Sembazuru/Interactive-Rainbow/Schematic/ExtraLEDs/ExtraLEDs_Bottom.png

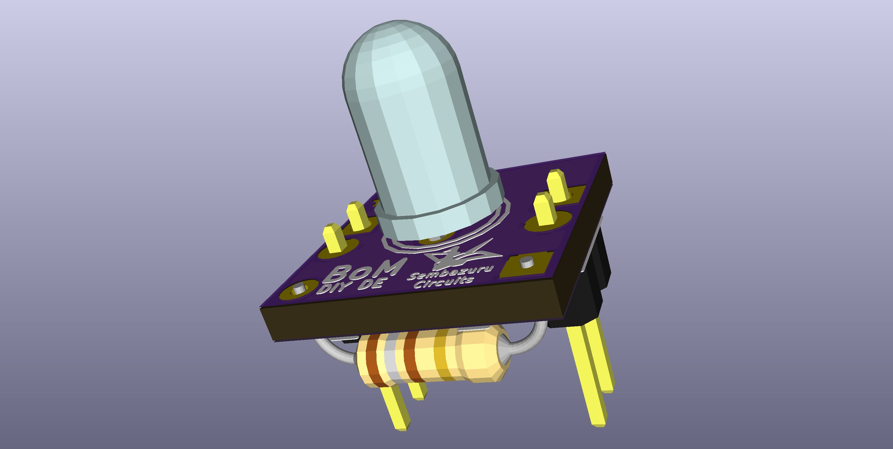
Schematic/ExtraLEDs/ExtraLEDs_Bottom.png
