Sembazuru/Interactive-Rainbow/Schematic/ExtraLEDs/ExtraLEDs_BareTop.png

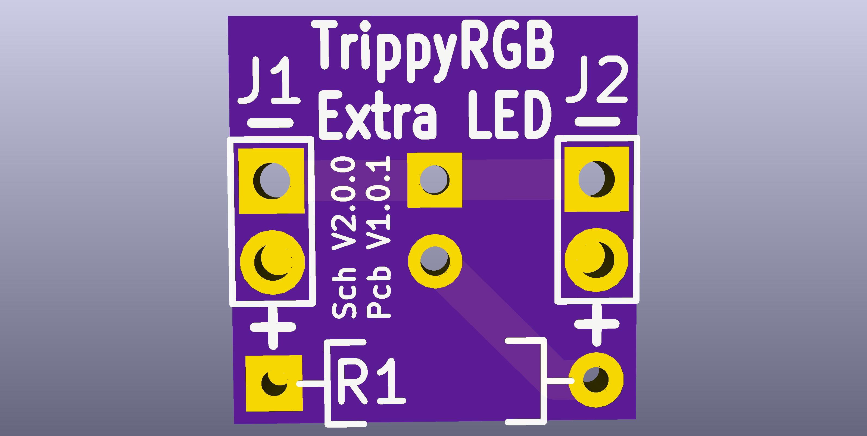
Schematic/ExtraLEDs/ExtraLEDs_BareTop.png
