Sembazuru/Interactive-Rainbow/Circuit Board Design Relative Sizes.pdf

LED | LED

LED LED

LED LED

LED LED

LED LED

LED LED

LED LED

LED LED

Sensor & LED | Sensor & LED

I&O Expander

Logic & Oscillator

Sensor & LED | Sensor & LED
Sensor & LED | Sensor & LED

I&O Expander
