Sembazuru/Interactive-Rainbow/Long Sign design idea 2017-02-08 CDE.png

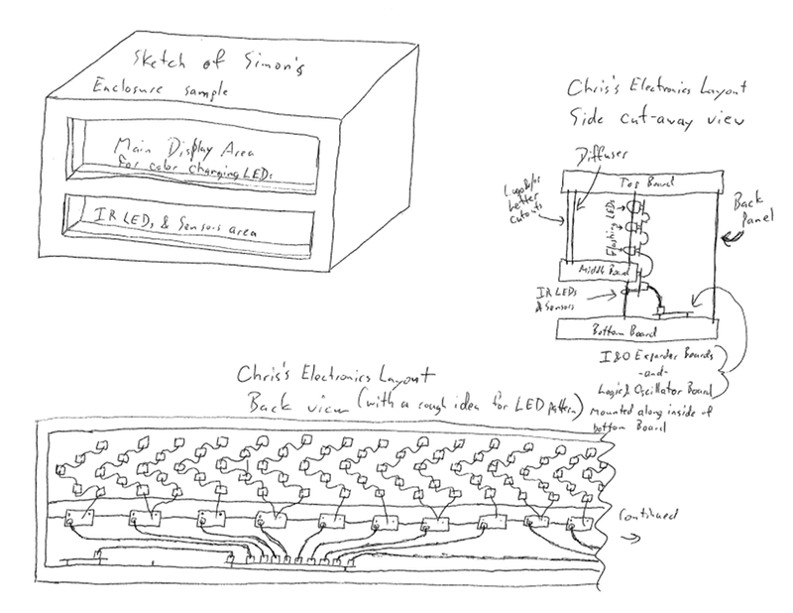
Long Sign design idea 2017-02-08 CDE.png
