Sembazuru/Interactive-Rainbow/Schematic/ExtraLEDs/ExtraLEDs_BareBottom.png

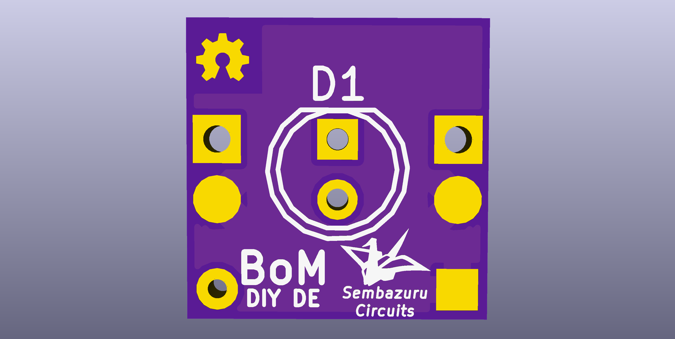
Schematic/ExtraLEDs/ExtraLEDs_BareBottom.png
