Sembazuru/Interactive-Rainbow/Schematic/ExtraLEDs/ExtraLEDs_Top.png

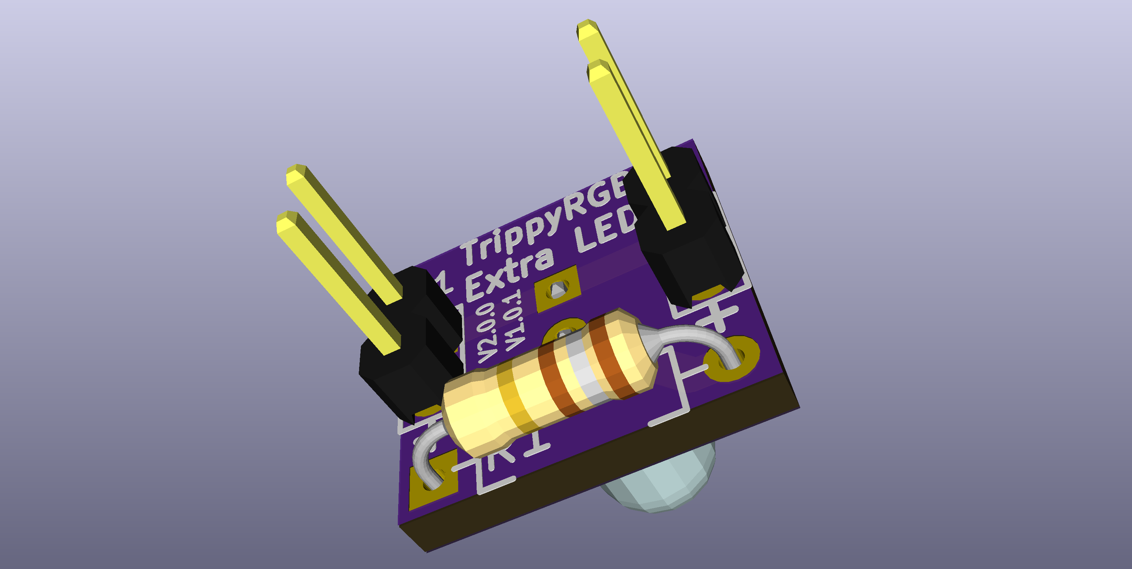
Schematic/ExtraLEDs/ExtraLEDs_Top.png
