Sembazuru/Interactive-Rainbow/Schematic/I&O_Epander/I&O_Epander_ComponentSide.png

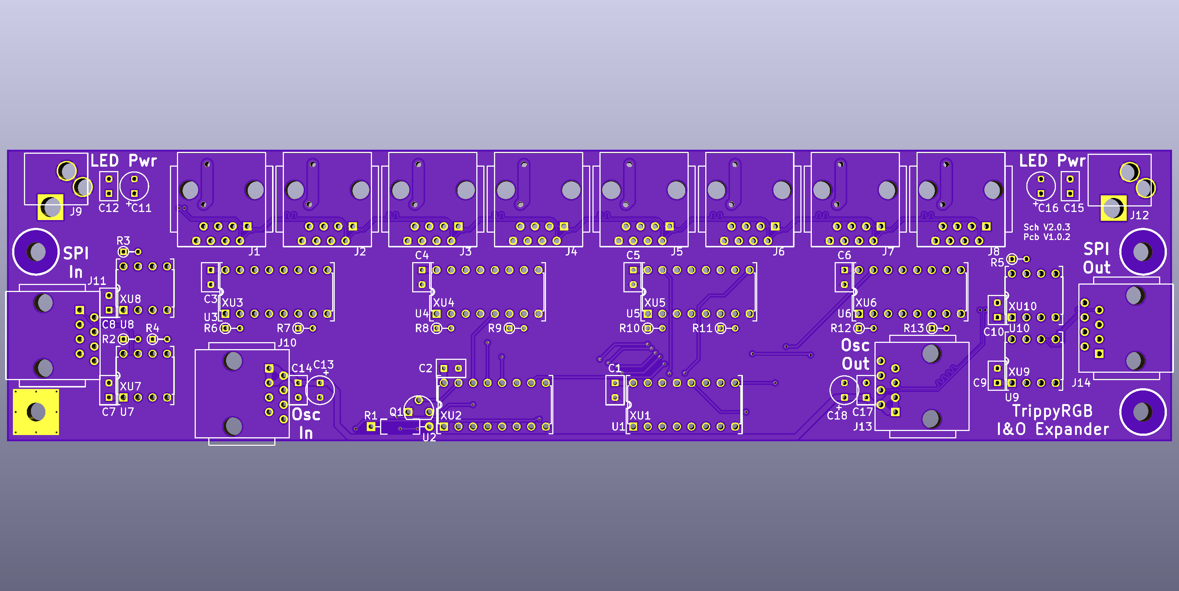
Schematic/I&O_Epander/I&O_Epander_ComponentSide.png
