Sembazuru/Interactive-Rainbow/Schematic/I&O_Epander/I&O_Epander_ComponentSide_Parts.png

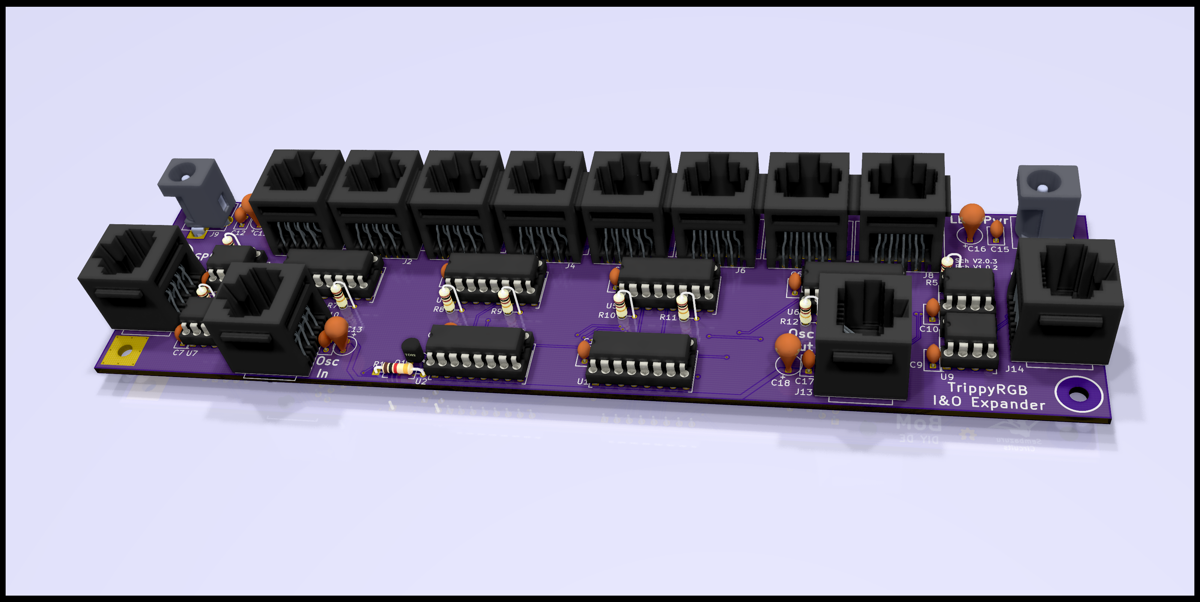
Schematic/I&O_Epander/I&O_Epander_ComponentSide_Parts.png
