Sembazuru/Interactive-Rainbow/Schematic/LED&Sensor/LED&Sensor_ComponentSide.png

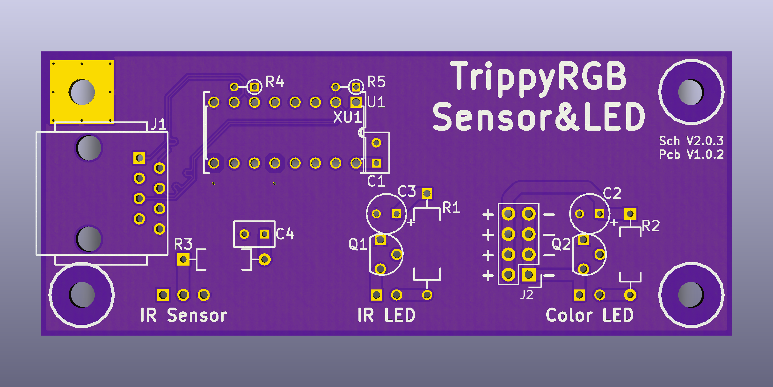
Schematic/LED&Sensor/LED&Sensor_ComponentSide.png
