Sembazuru/Interactive-Rainbow/Schematic/LED&Sensor/LED&Sensor_ComponentSide_Parts.png

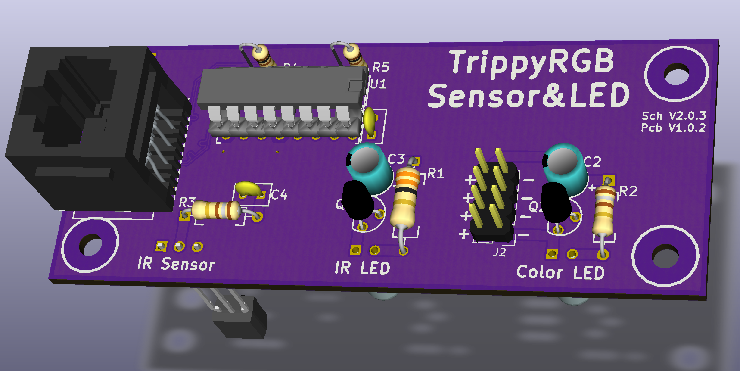
Schematic/LED&Sensor/LED&Sensor_ComponentSide_Parts.png
