Sembazuru/Interactive-Rainbow/Schematic/LED&Sensor/LED&Sensor_SolderSide_Parts.png

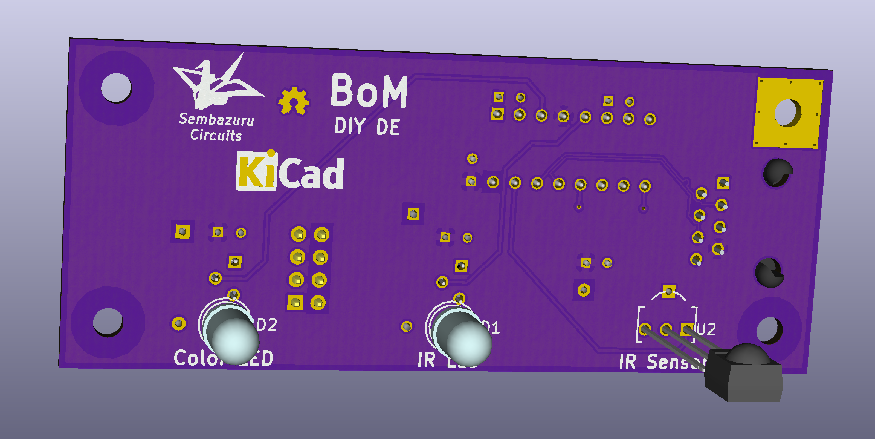
Schematic/LED&Sensor/LED&Sensor_SolderSide_Parts.png
