Sembazuru/Interactive-Rainbow/Schematic/Logic&Oscillator/Logic&Oscillator_ComponentSide.png

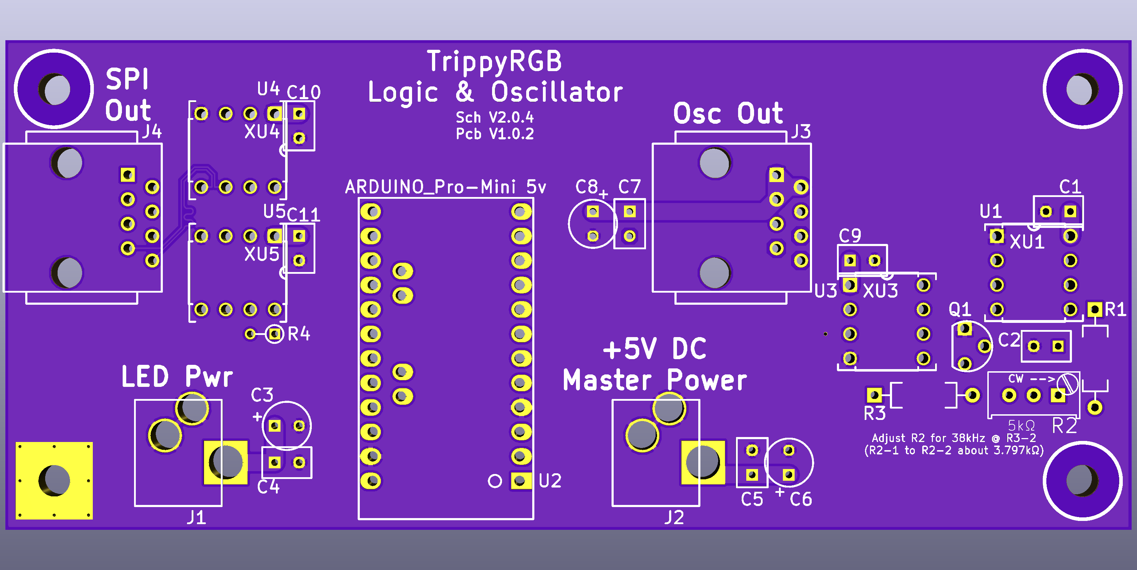
Schematic/Logic&Oscillator/Logic&Oscillator_ComponentSide.png
