Sembazuru/Interactive-Rainbow/Schematic/Logic&Oscillator/Logic&Oscillator_ComponentSide_Parts.png

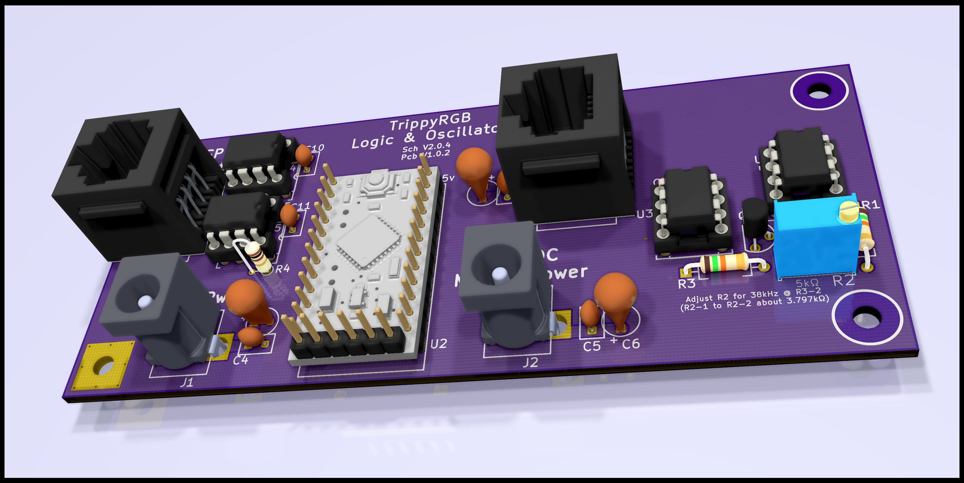
Schematic/Logic&Oscillator/Logic&Oscillator_ComponentSide_Parts.png
