Sembazuru/Interactive-Rainbow/Schematic/Logic&Oscillator/Logic&Oscillator_SolderSide_Parts.png

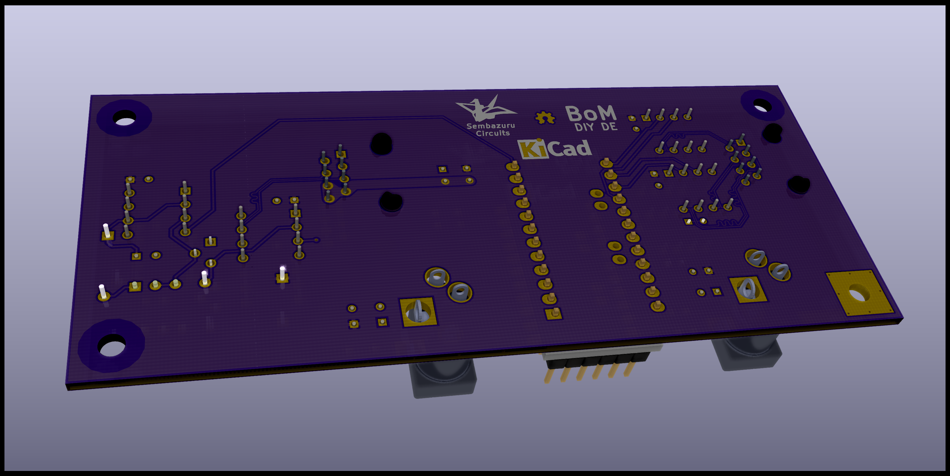
Schematic/Logic&Oscillator/Logic&Oscillator_SolderSide_Parts.png
