Sembazuru/Interactive-Rainbow/(list of files, cad)

Other CAD files:
Circuit Board Design Relative Sizes.dwg
Layout suggestion 2105-08-07.dwg
