Sembazuru/Interactive-Rainbow/Schematic/LED&Sensor/bom/Screenshots/Assembly01.png

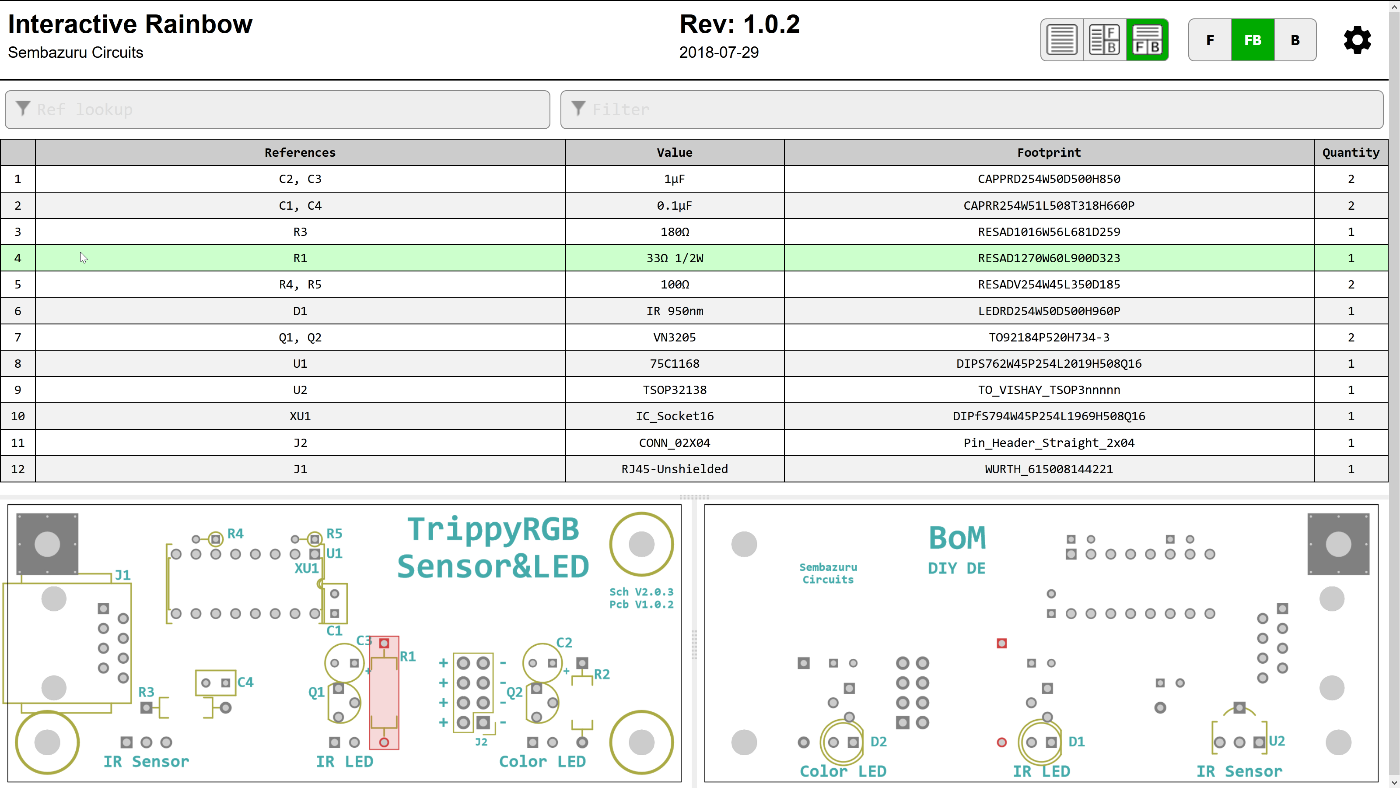
Schematic/LED&Sensor/bom/Screenshots/Assembly01.png
