Sembazuru/Interactive-Rainbow/Schematic/LED&Sensor/bom/Screenshots/Assembly03.png

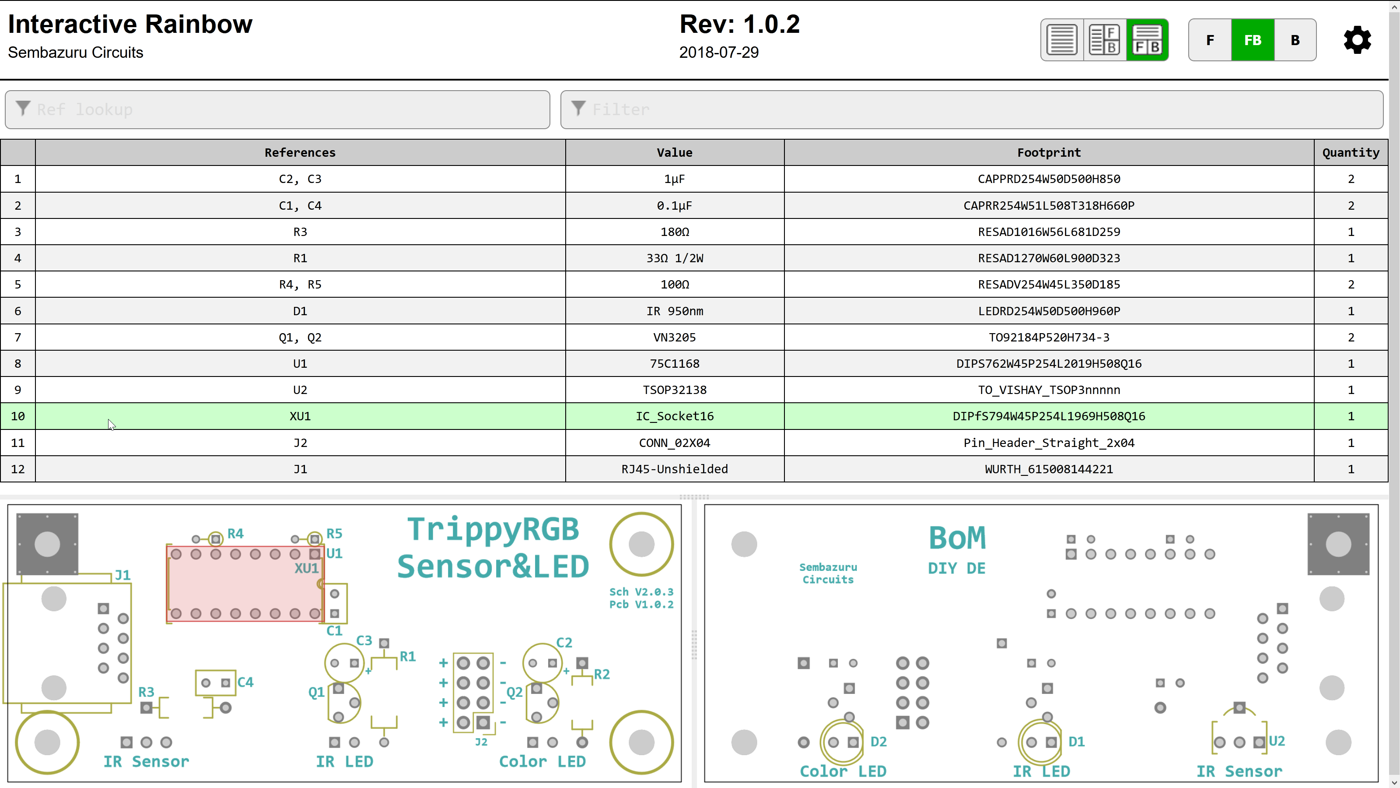
Schematic/LED&Sensor/bom/Screenshots/Assembly03.png
