Sembazuru/Interactive-Rainbow/Schematic/LED&Sensor/LED&Sensor_SolderSide.png

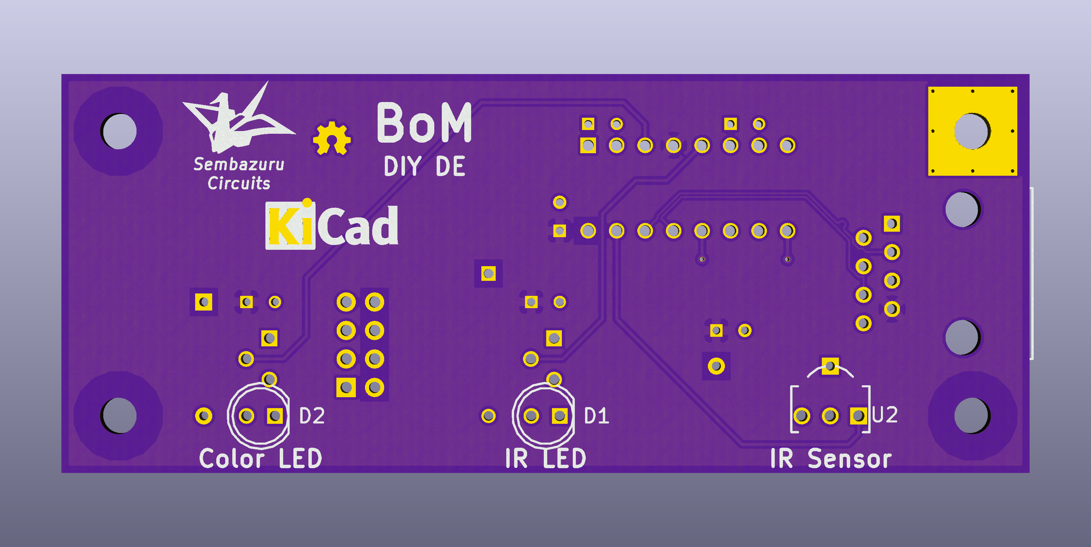
Schematic/LED&Sensor/LED&Sensor_SolderSide.png
