Sembazuru/Interactive-Rainbow/Schematic/Logic&Oscillator/Logic&Oscillator_SolderSide.png

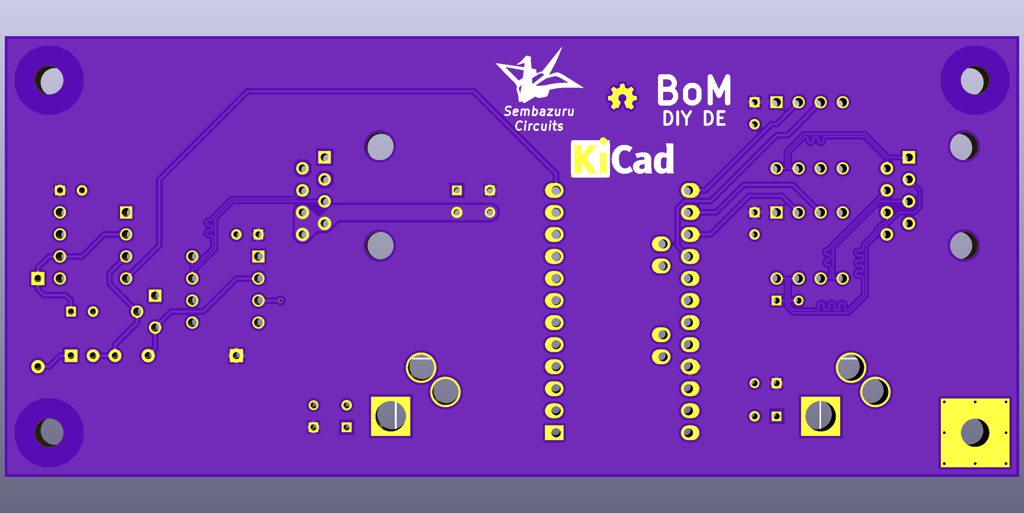
Schematic/Logic&Oscillator/Logic&Oscillator_SolderSide.png
