Sembazuru/Interactive-Rainbow/LED_characterization/R=217.4/CleanedUp.ods

UTC TIME SEC | CH2 VOLT DC | Converted UTC Time | Converted Local Time | Converted Amps | mA | 217.4 |  | A | mA
1475537569.371 | 1.537687 | 2016-10-03 23:32:49.371 | 19:32:49.371 | 0.007073077276909 | 7.07307727690892 |  | Max= | 0.009402966881325 | 9.40296688132475
1475537570.67 | 1.538127 | 2016-10-03 23:32:50.670 | 19:32:50.670 | 0.007075101195952 | 7.07510119595216 |  | Min= | 0.006986706531739 | 6.98670653173873
1475537571.966 | 1.54518 | 2016-10-03 23:32:51.966 | 19:32:51.966 | 0.007107543698252 | 7.10754369825207 |  | Average= | 0.008326716243163 | 8.32671624316347
1475537573.503 | 1.559413 | 2016-10-03 23:32:53.503 | 19:32:53.503 | 0.007173012879485 | 7.17301287948482 |  | RMS= | 0.008367249406598 | 8.36724940659813
1475537574.801 | 1.559249 | 2016-10-03 23:32:54.801 | 19:32:54.801 | 0.00717225850966 | 7.17225850965961
1475537576.1 | 1.558992 | 2016-10-03 23:32:56.100 | 19:32:56.100 | 0.007171076356946 | 7.17107635694572 |  | Elapsed Time= | 16:15.594
1475537577.465 | 1.7241 | 2016-10-03 23:32:57.465 | 19:32:57.465 | 0.007930542778289 | 7.93054277828887
1475537578.793 | 1.924527 | 2016-10-03 23:32:58.793 | 19:32:58.793 | 0.008852470101196 | 8.85247010119595
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
