Sembazuru/Interactive-Rainbow/LED_characterization/R=109.1/Calculated.csv

UTC TIME SEC | CH2 VOLT DC | Converted UTC Time | Converted Local Time | Converted Amps | mA
1475544487.639 | 1.374686 | 2016-10-04 01:28:07.639 | 21:28:08 | 0.012600238313474 | 12.6002383134739
1475544488.373 | 1.373825 | 2016-10-04 01:28:08.373 | 21:28:08 | 0.012592346471127 | 12.5923464711274
1475544489.696 | 1.333505 | 2016-10-04 01:28:09.696 | 21:28:10 | 0.012222777268561 | 12.222777268561
1475544490.986 | 1.262904 | 2016-10-04 01:28:10.986 | 21:28:11 | 0.011575655362053 | 11.5756553620532
1475544492.466 | 1.218261 | 2016-10-04 01:28:12.466 | 21:28:12 | 0.011166461961503 | 11.1664619615032
1475544493.815 | 1.217107 | 2016-10-04 01:28:13.815 | 21:28:14 | 0.011155884509624 | 11.1558845096242
1475544495.106 | 1.224013 | 2016-10-04 01:28:15.106 | 21:28:15 | 0.011219184234647 | 11.2191842346471
1475544496.395 | 1.241434 | 2016-10-04 01:28:16.395 | 21:28:16 | 0.011378863428048 | 11.3788634280477
1475544497.75 | 1.265945 | 2016-10-04 01:28:17.750 | 21:28:18 | 0.011603528872594 | 11.603528872594
1475544499.075 | 1.257701 | 2016-10-04 01:28:19.075 | 21:28:19 | 0.011527965169569 | 11.5279651695692
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
