Sembazuru/Interactive-Rainbow/LED_characterization/R=109.1/CleanedUp.CSV

UTC TIME SEC | CH1 AMPS DC | CH2 VOLT DC
1475544487.639 | -1.923242E-05 | 1.374686E000
1475544488.373 | -2.884864E-05 | 1.373825E000
1475544489.696 | -2.884864E-05 | 1.333505E000
1475544490.986 | -9.616215E-06 | 1.262904E000
1475544492.466 | -2.884864E-05 | 1.218261E000
1475544493.815 | -3.365675E-05 | 1.217107E000
1475544495.106 | -2.404053E-05 | 1.224013E000
1475544496.395 | -3.365675E-05 | 1.241434E000
1475544497.750 | -2.404053E-05 | 1.265945E000
1475544499.075 | -2.884864E-05 | 1.257701E000
1475544500.366 | -2.404053E-05 | 1.259607E000
1475544501.658 | -2.884864E-05 | 1.410316E000
1475544502.950 | -1.923242E-05 | 1.572237E000
1475544504.531 | 4.808107E-06 | 1.627120E000
1475544505.823 | -3.365675E-05 | 1.626516E000
1475544507.113 | -2.404053E-05 | 1.597242E000
1475544508.468 | -1.442432E-05 | 1.541314E000
1475544509.791 | -1.923242E-05 | 1.503632E000
1475544511.083 | -1.923242E-05 | 1.502955E000
1475544512.375 | -3.846485E-05 | 1.507351E000
1475544513.968 | -3.365675E-05 | 1.569361E000
1475544515.265 | -2.404053E-05 | 1.619683E000
1475544516.556 | -2.404053E-05 | 1.620287E000
1475544517.915 | -3.365675E-05 | 1.618803E000
1475544519.238 | -1.923242E-05 | 1.658794E000
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
