Sembazuru/Interactive-Rainbow/LED_characterization/R=109.1/Calculated.png

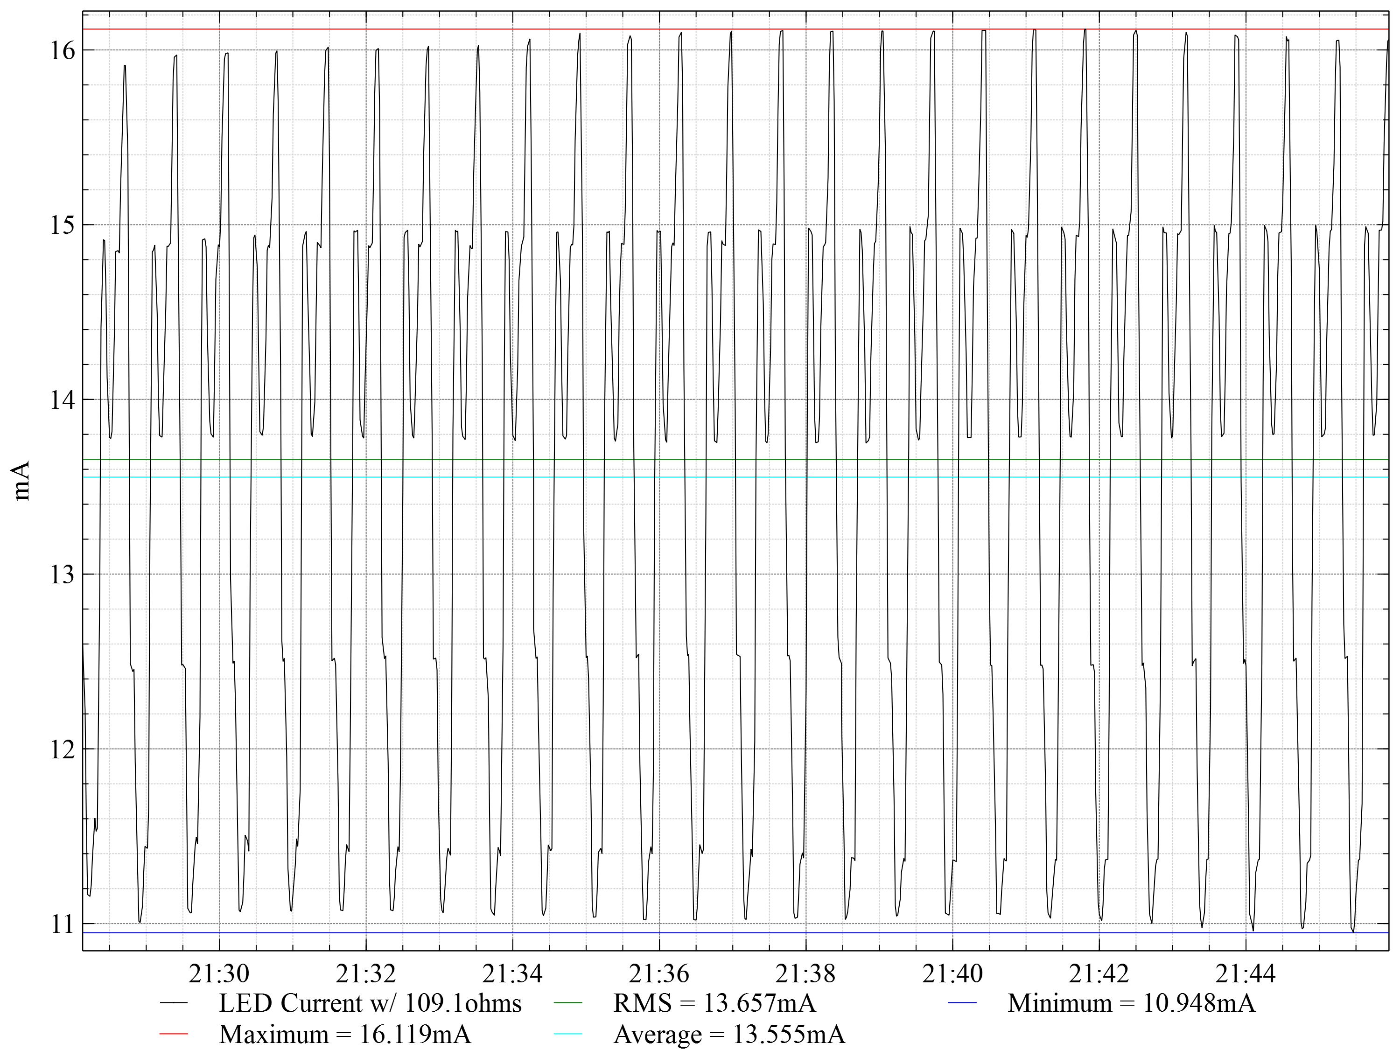
LED_characterization/R=109.1/Calculated.png
