Sembazuru/Interactive-Rainbow/LED_characterization/R=217.4/Calculated.png

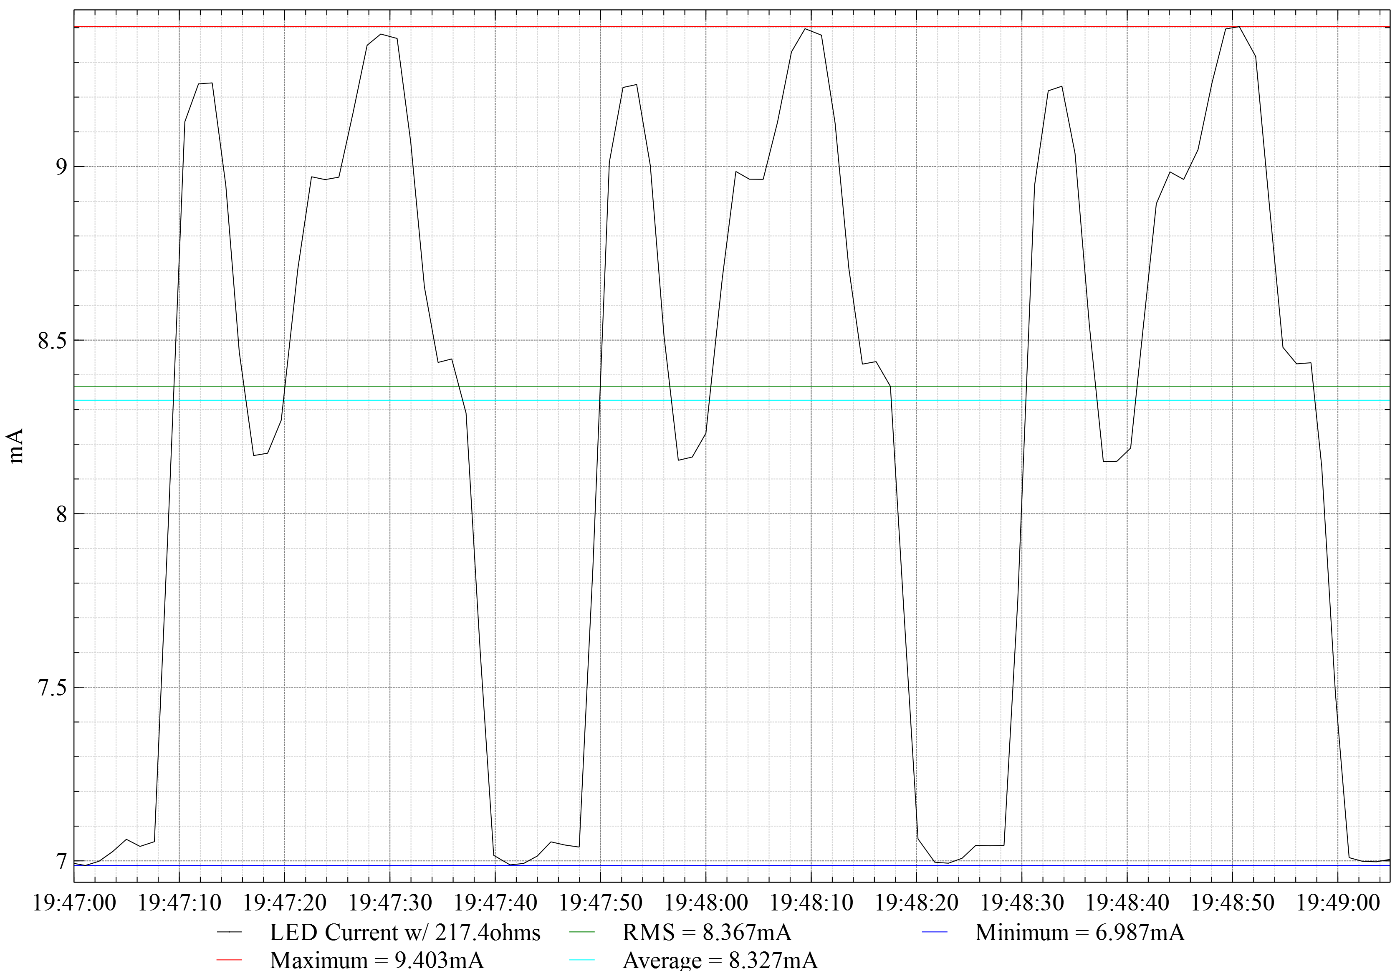
LED_characterization/R=217.4/Calculated.png
