Sembazuru/Interactive-Rainbow/Circuit Board Design Layout Guide.pdf

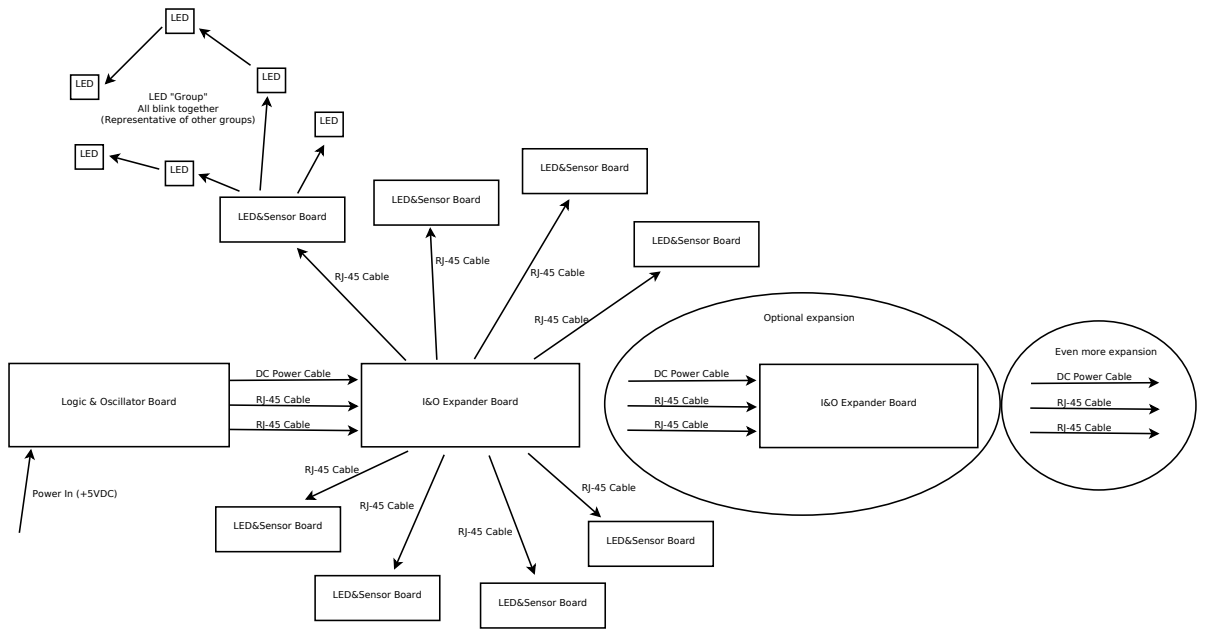
[picture p22: page 1]
Power In (+5VDC); I&O Expander Board; RJ-45 Cable; Optional expansion; LED

LED "Group"
All blink together

(Representative of other groups)

LED&Sensor Board

Even more expansion

DC Power Cable

Logic & Oscillator Board
