Sembazuru/Interactive-Rainbow/Schematic/I&O_Epander/I&O_Expander_Schematic_v2.0.3.pdf

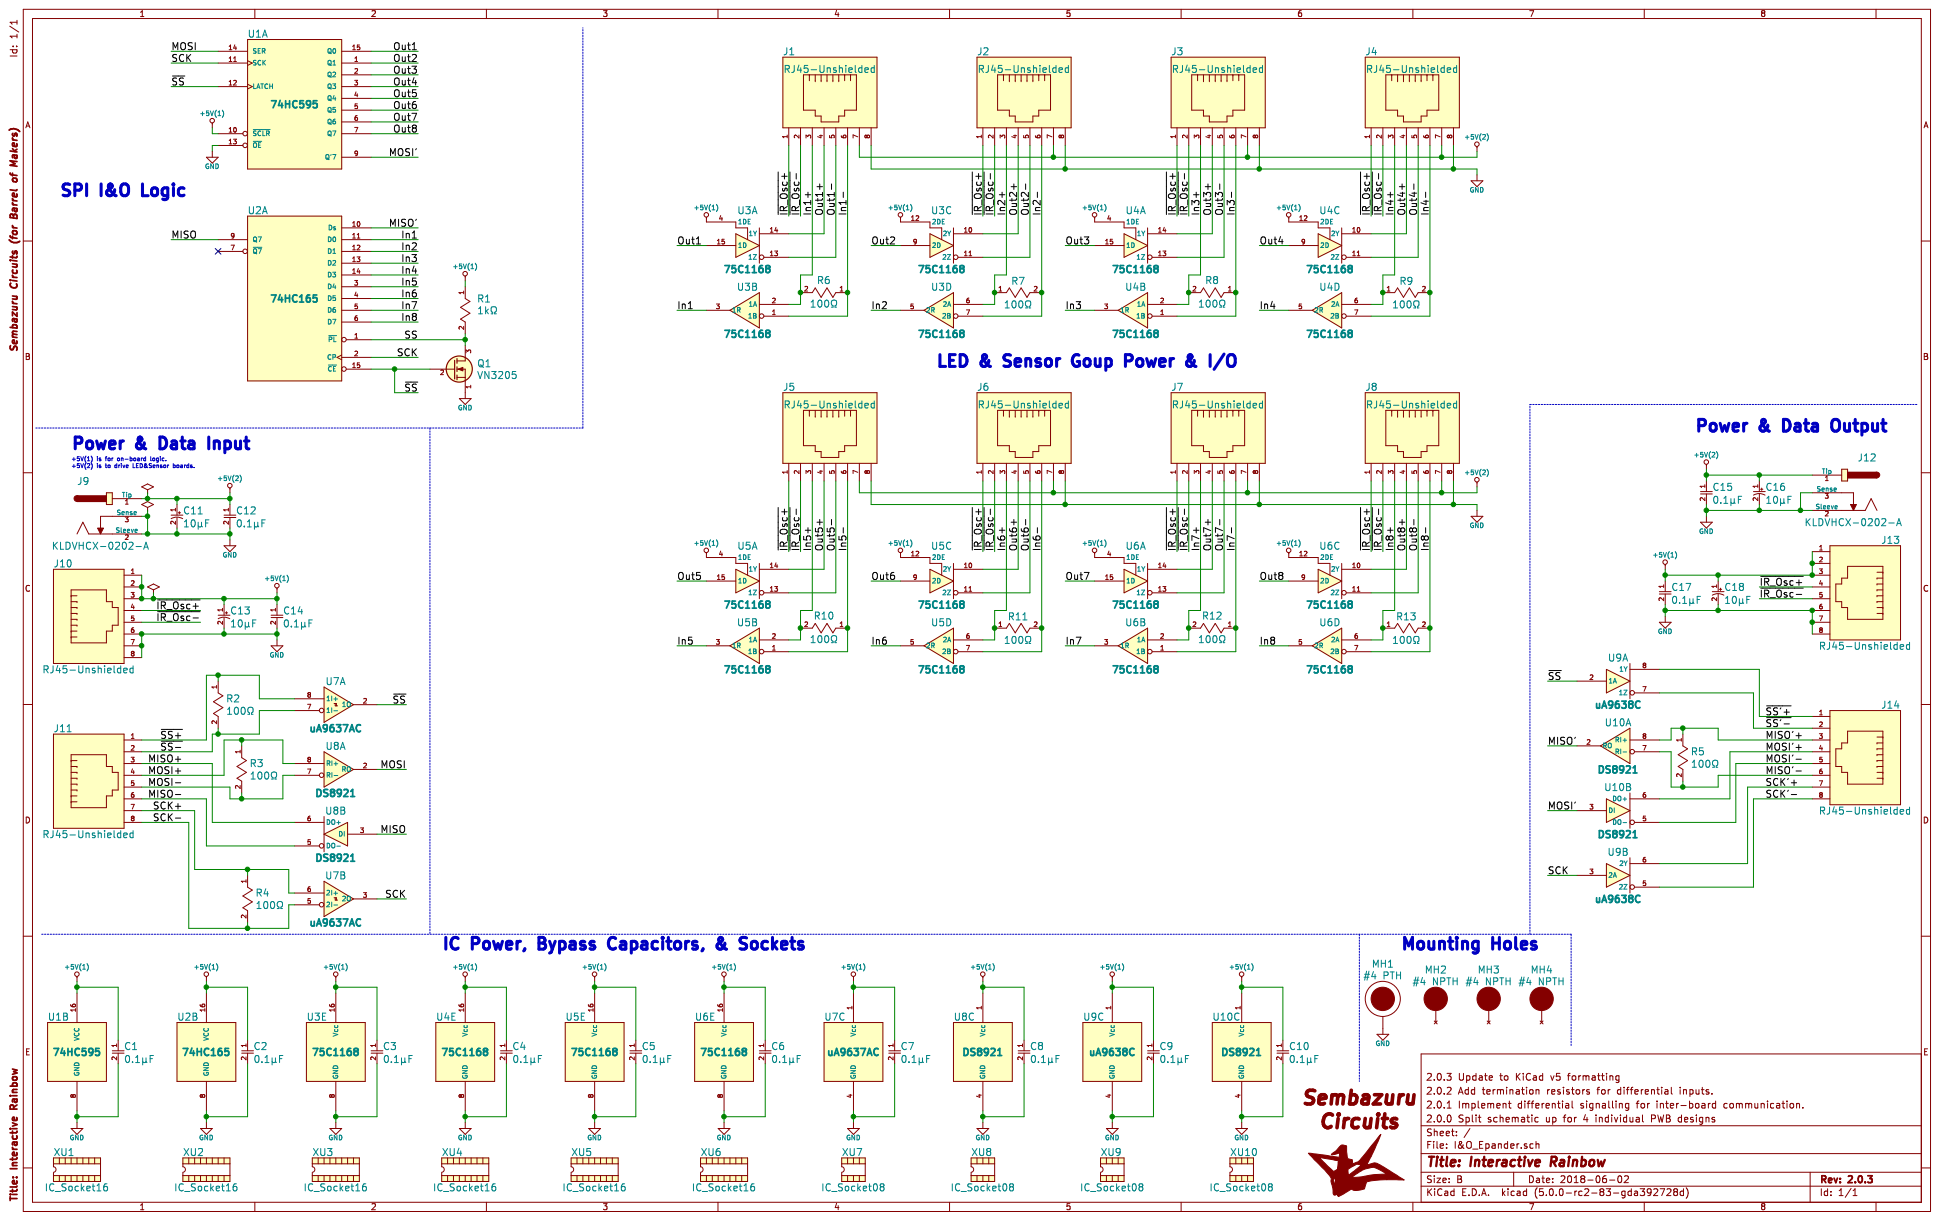
[picture p38: page 1]
