Sembazuru/Interactive-Rainbow/Schematic/I&O_Epander/PCB 1.0.2.pdf

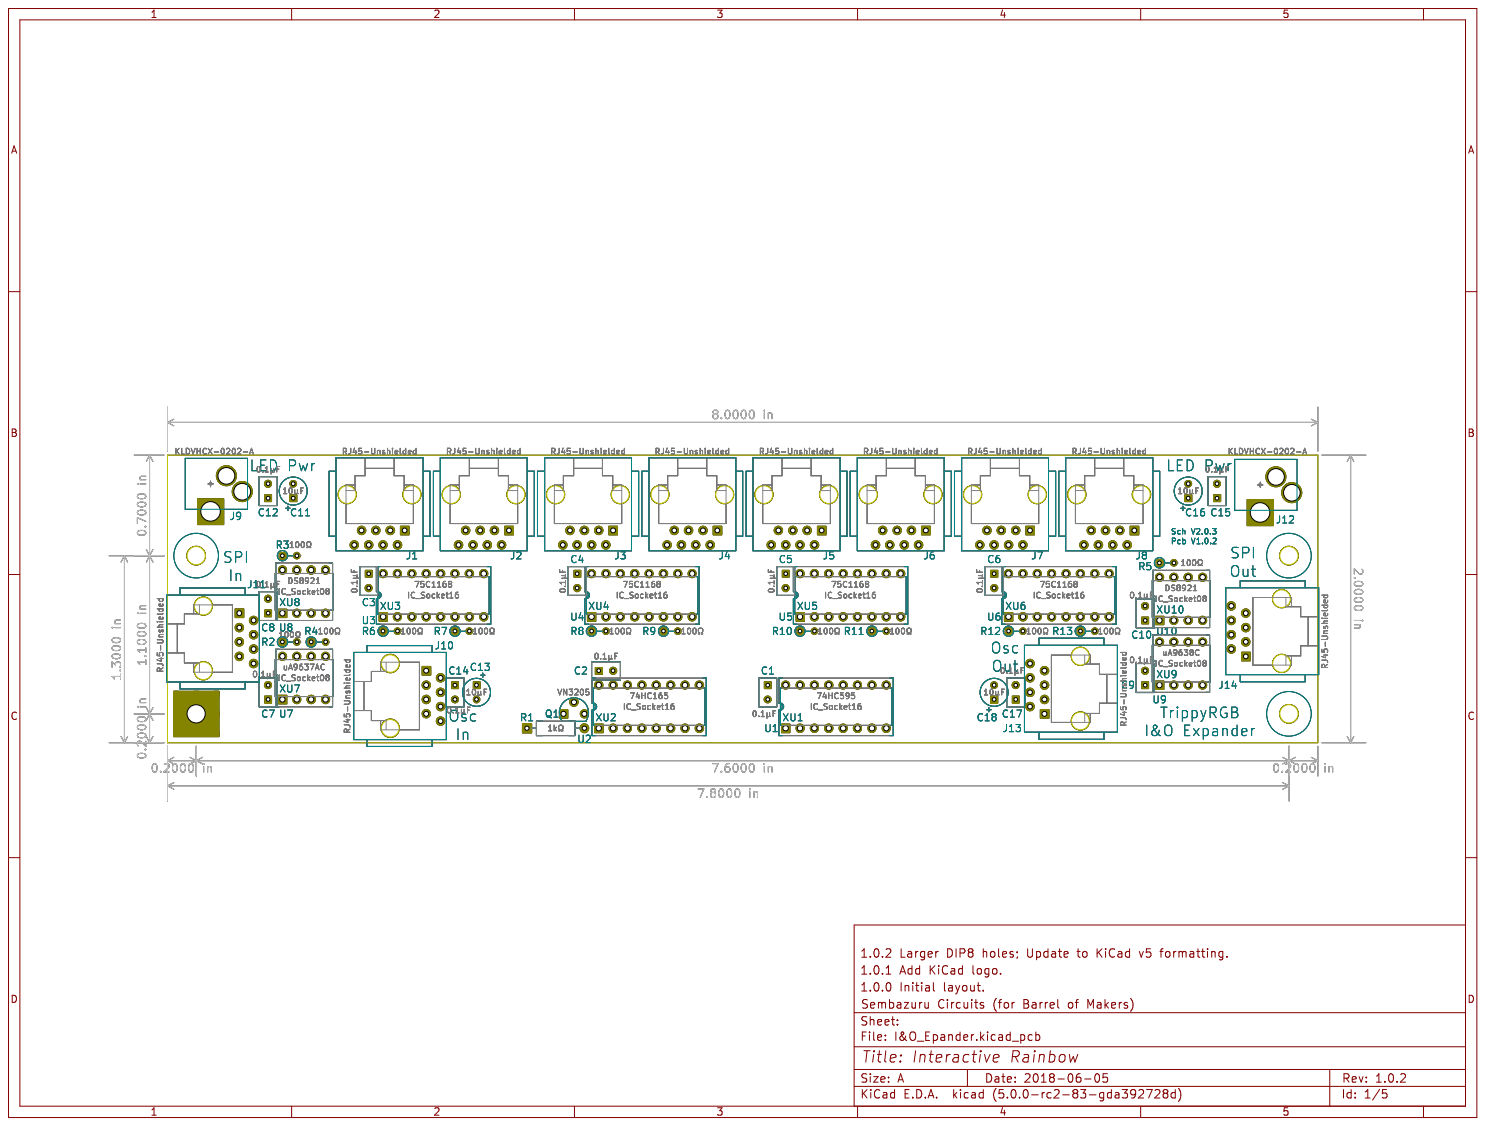
[picture p39: page 1]

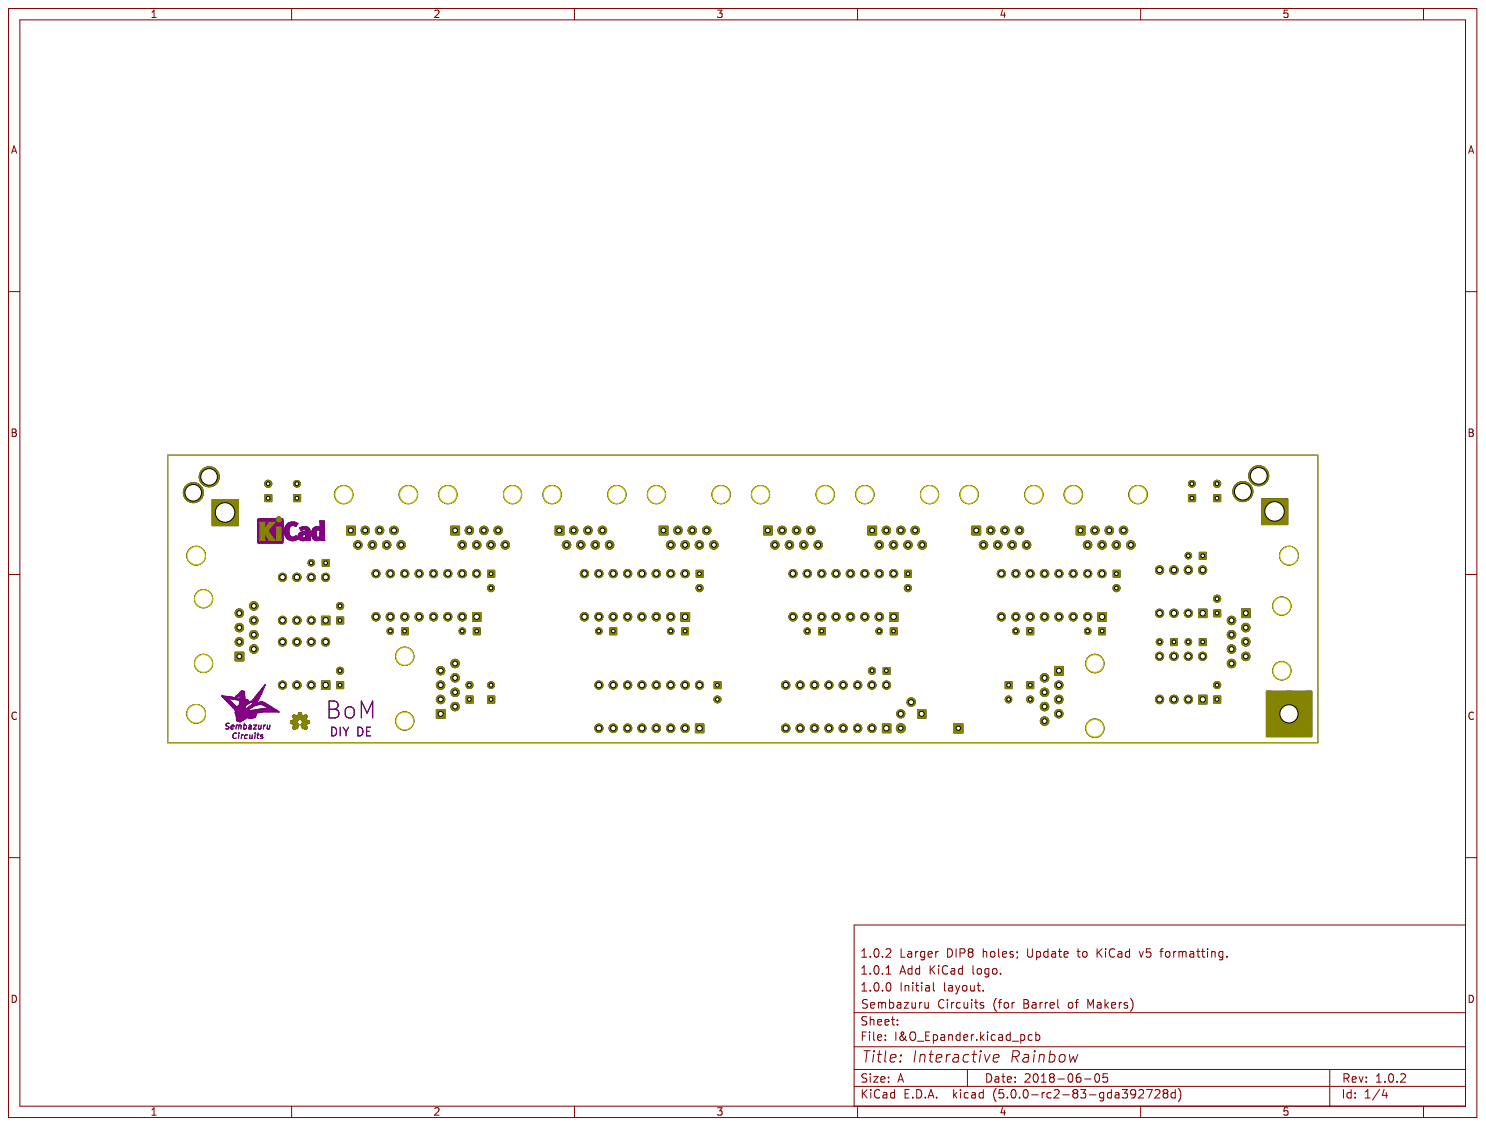
[picture p40: page 2]
