Sembazuru/Interactive-Rainbow/Schematic/Logic&Oscillator/PCB 1.0.2.pdf

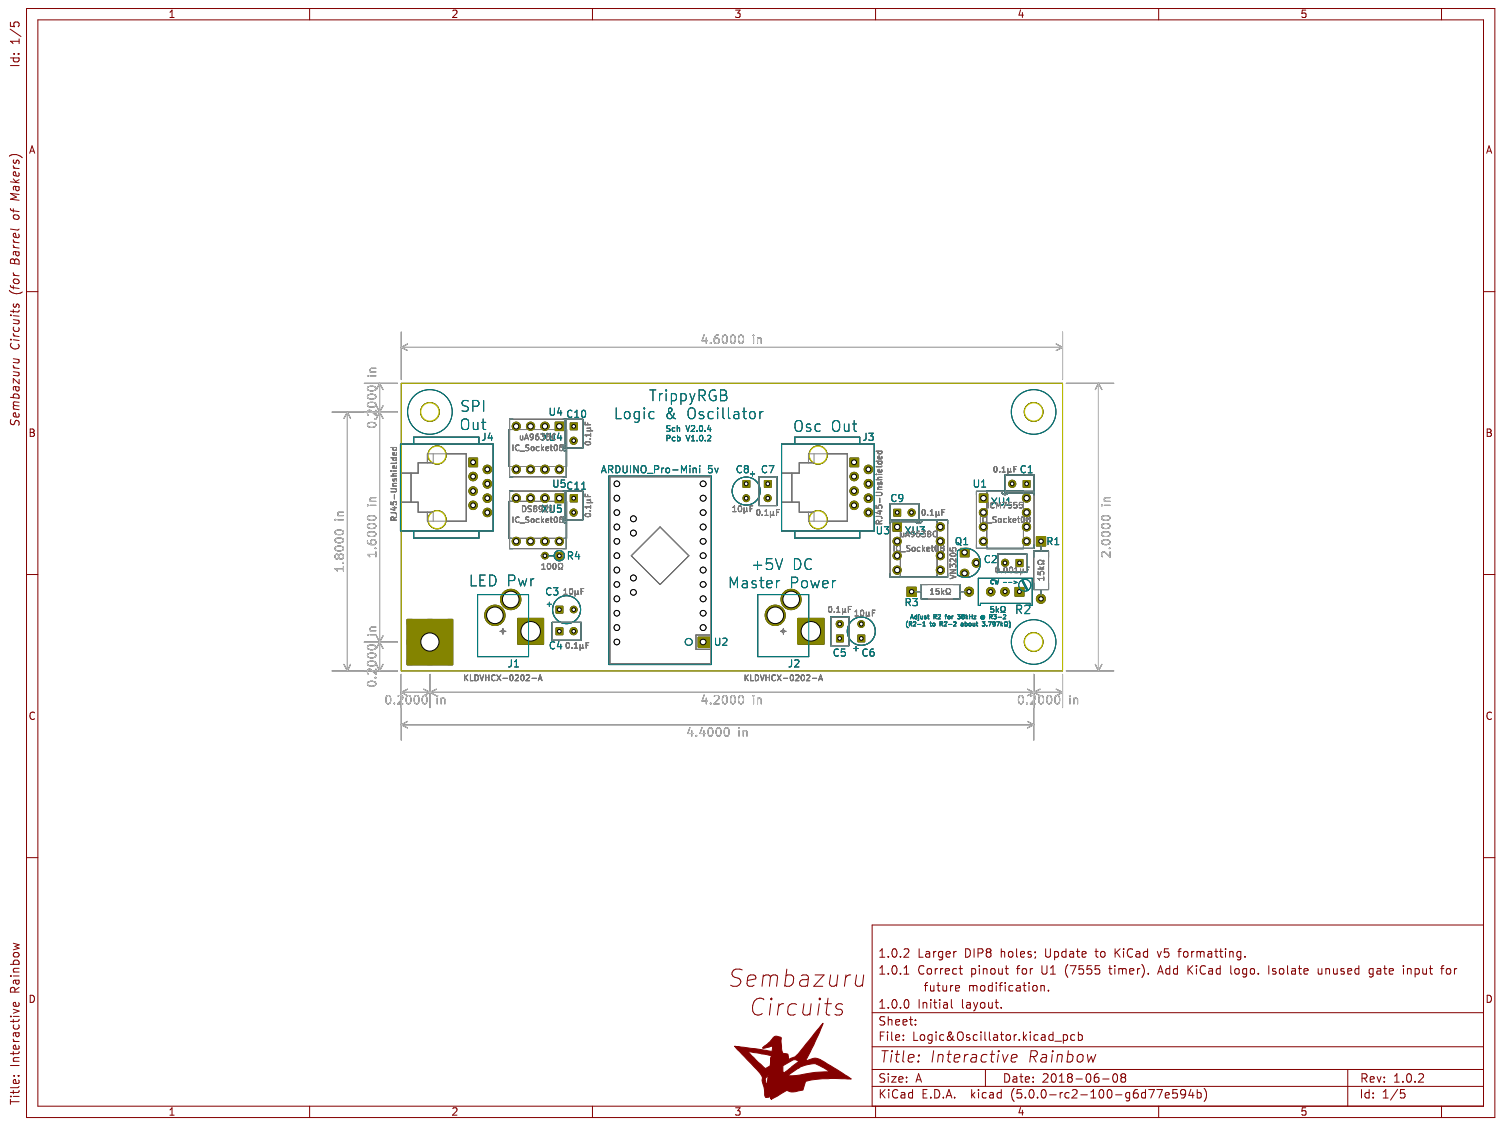
[picture p41: page 1]

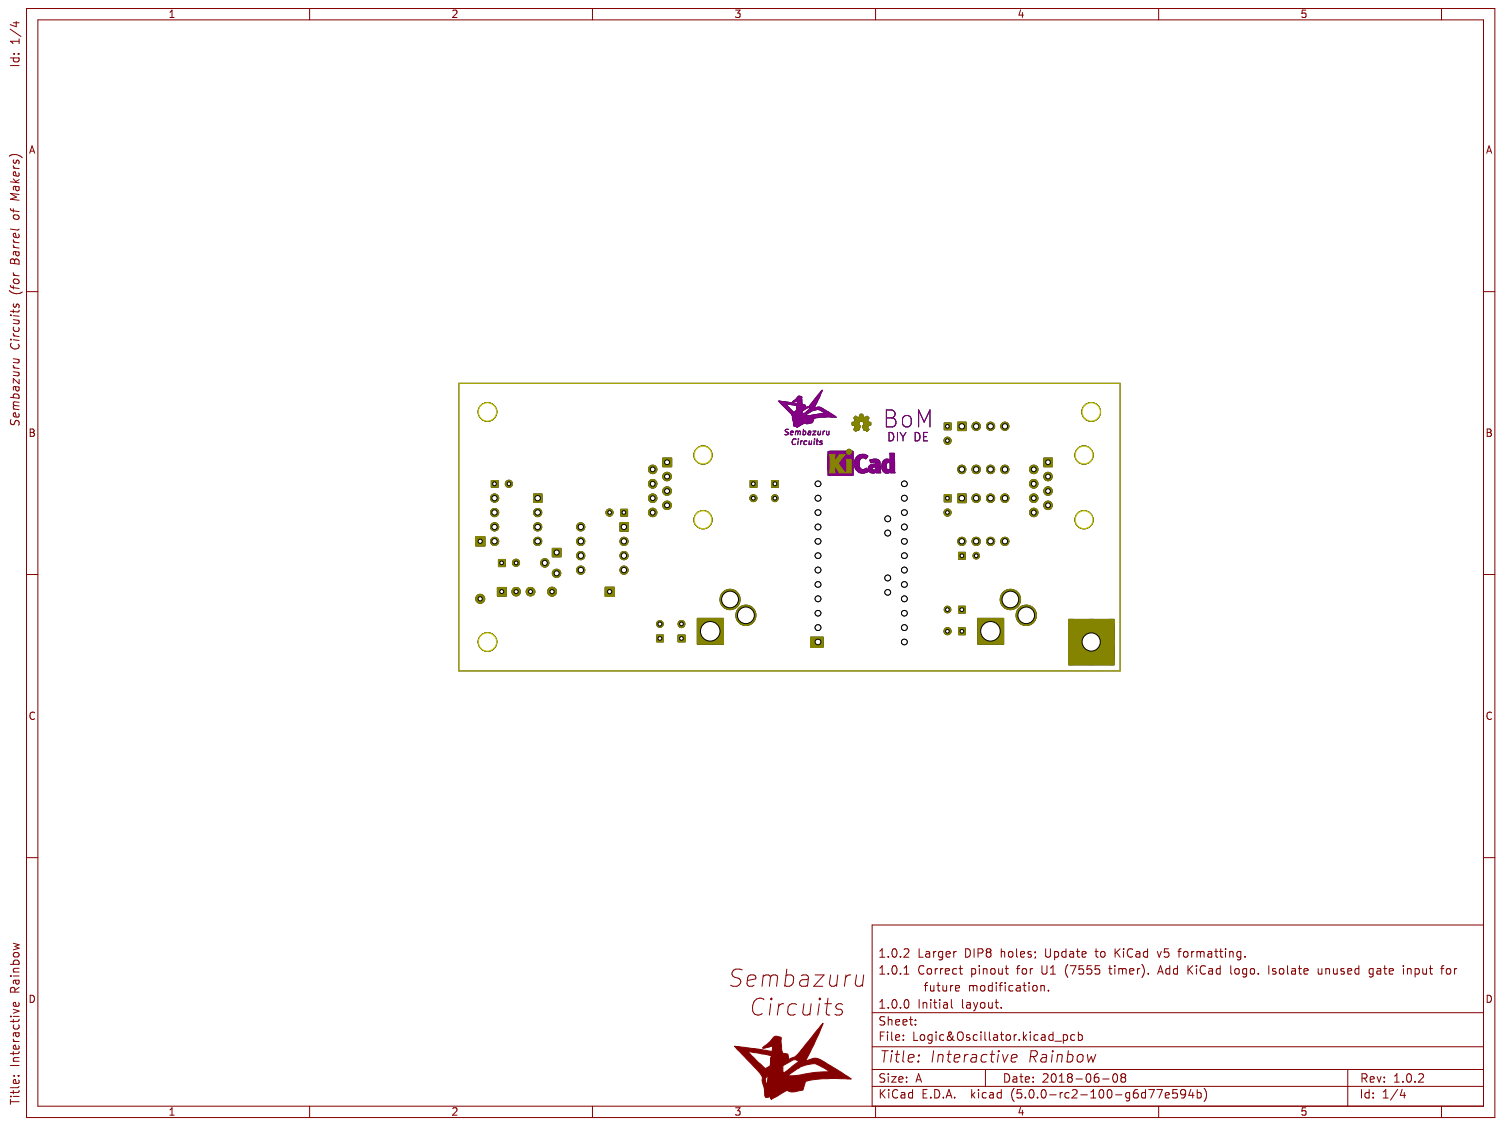
[picture p42: page 2]
