Sembazuru/Interactive-Rainbow/Schematic/Logic&Oscillator/Schematic 2.0.4.pdf

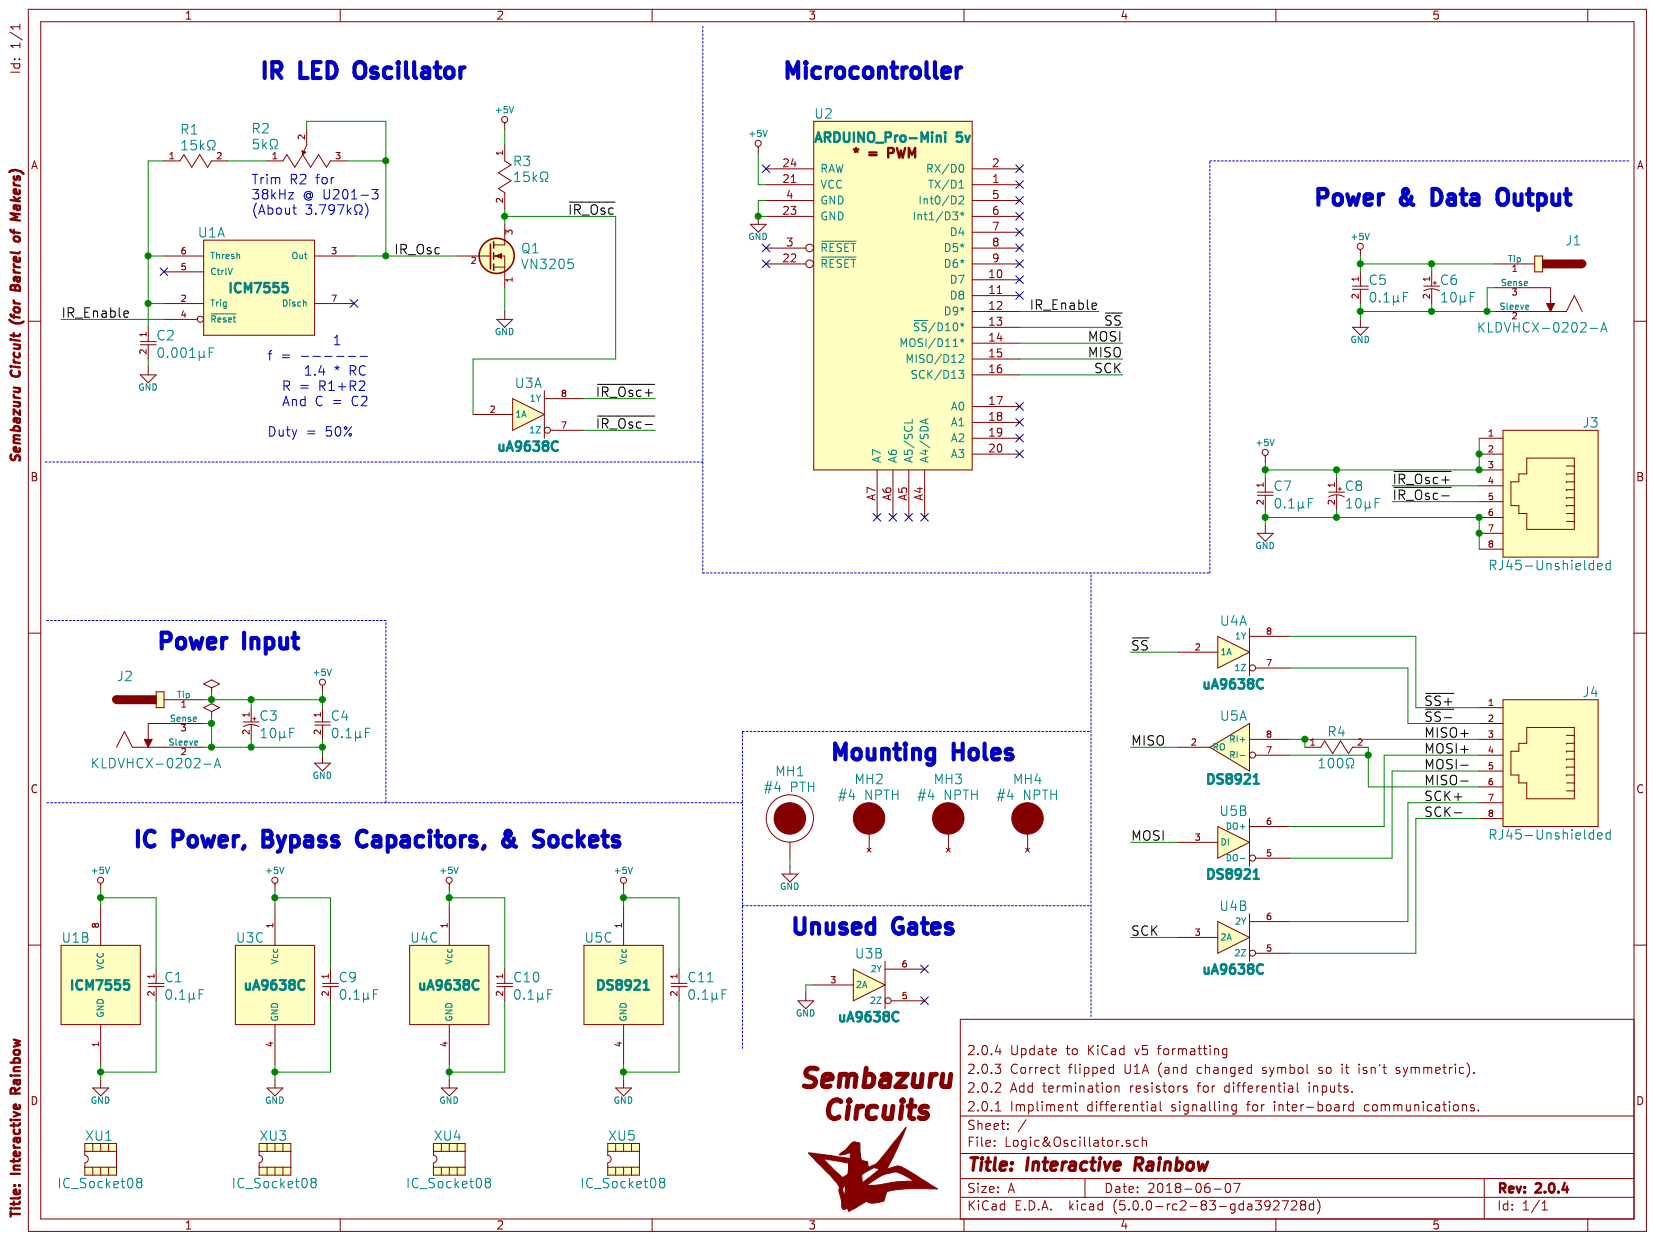
[picture p43: page 1]
