Sembazuru/Interactive-Rainbow/Schematic/ExtraLEDs/PCB 1.0.0.pdf

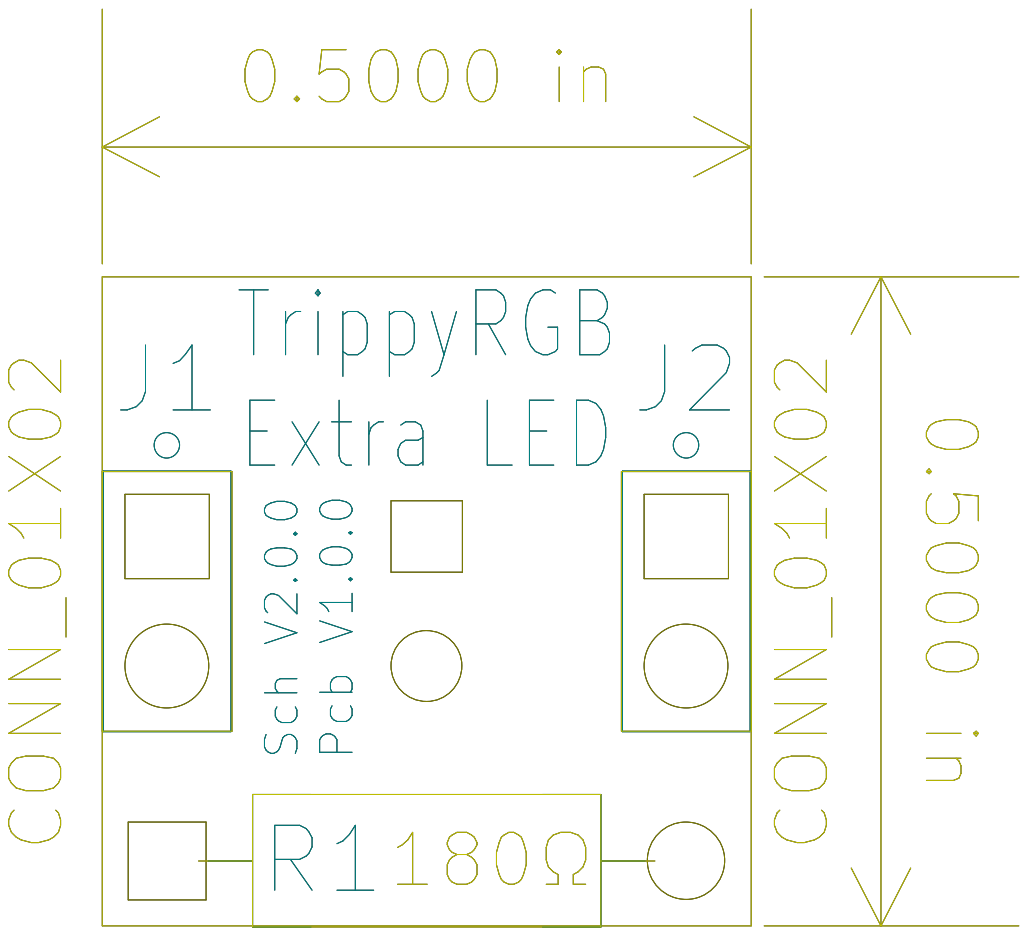
[picture p44: page 1]

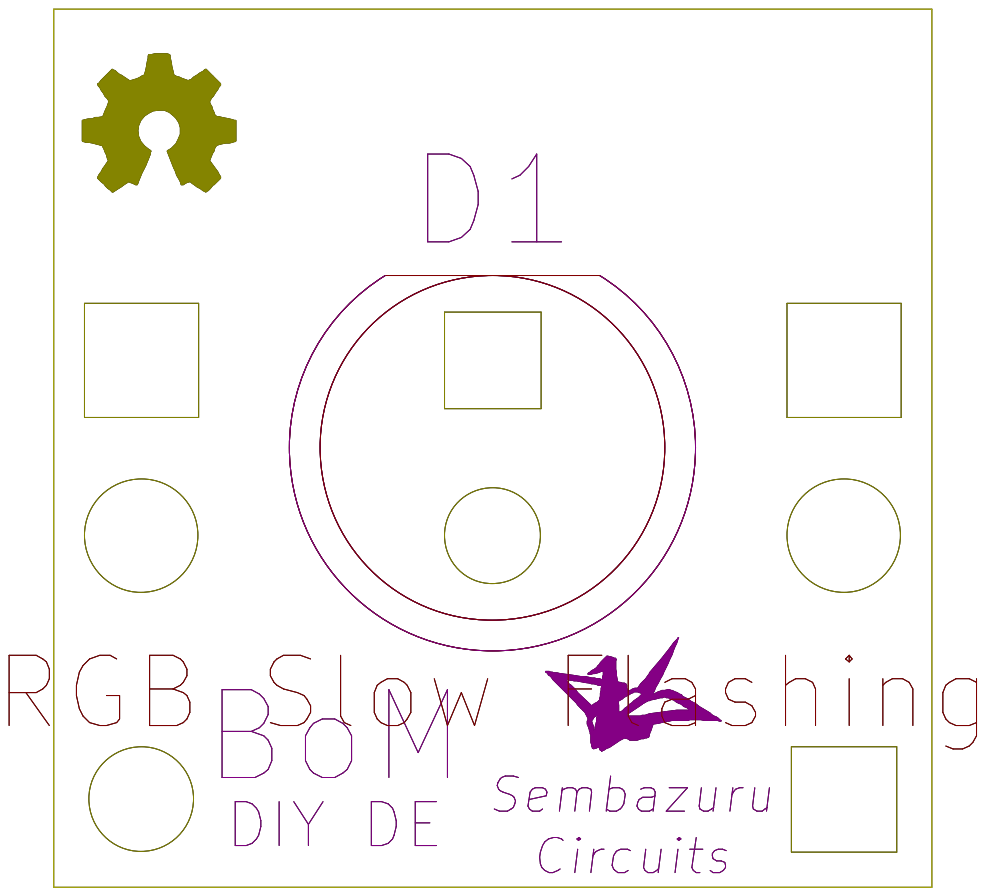
[picture p45: page 2]
