Sembazuru/Interactive-Rainbow/Schematic/ExtraLEDs/Schematic 2.0.0.pdf

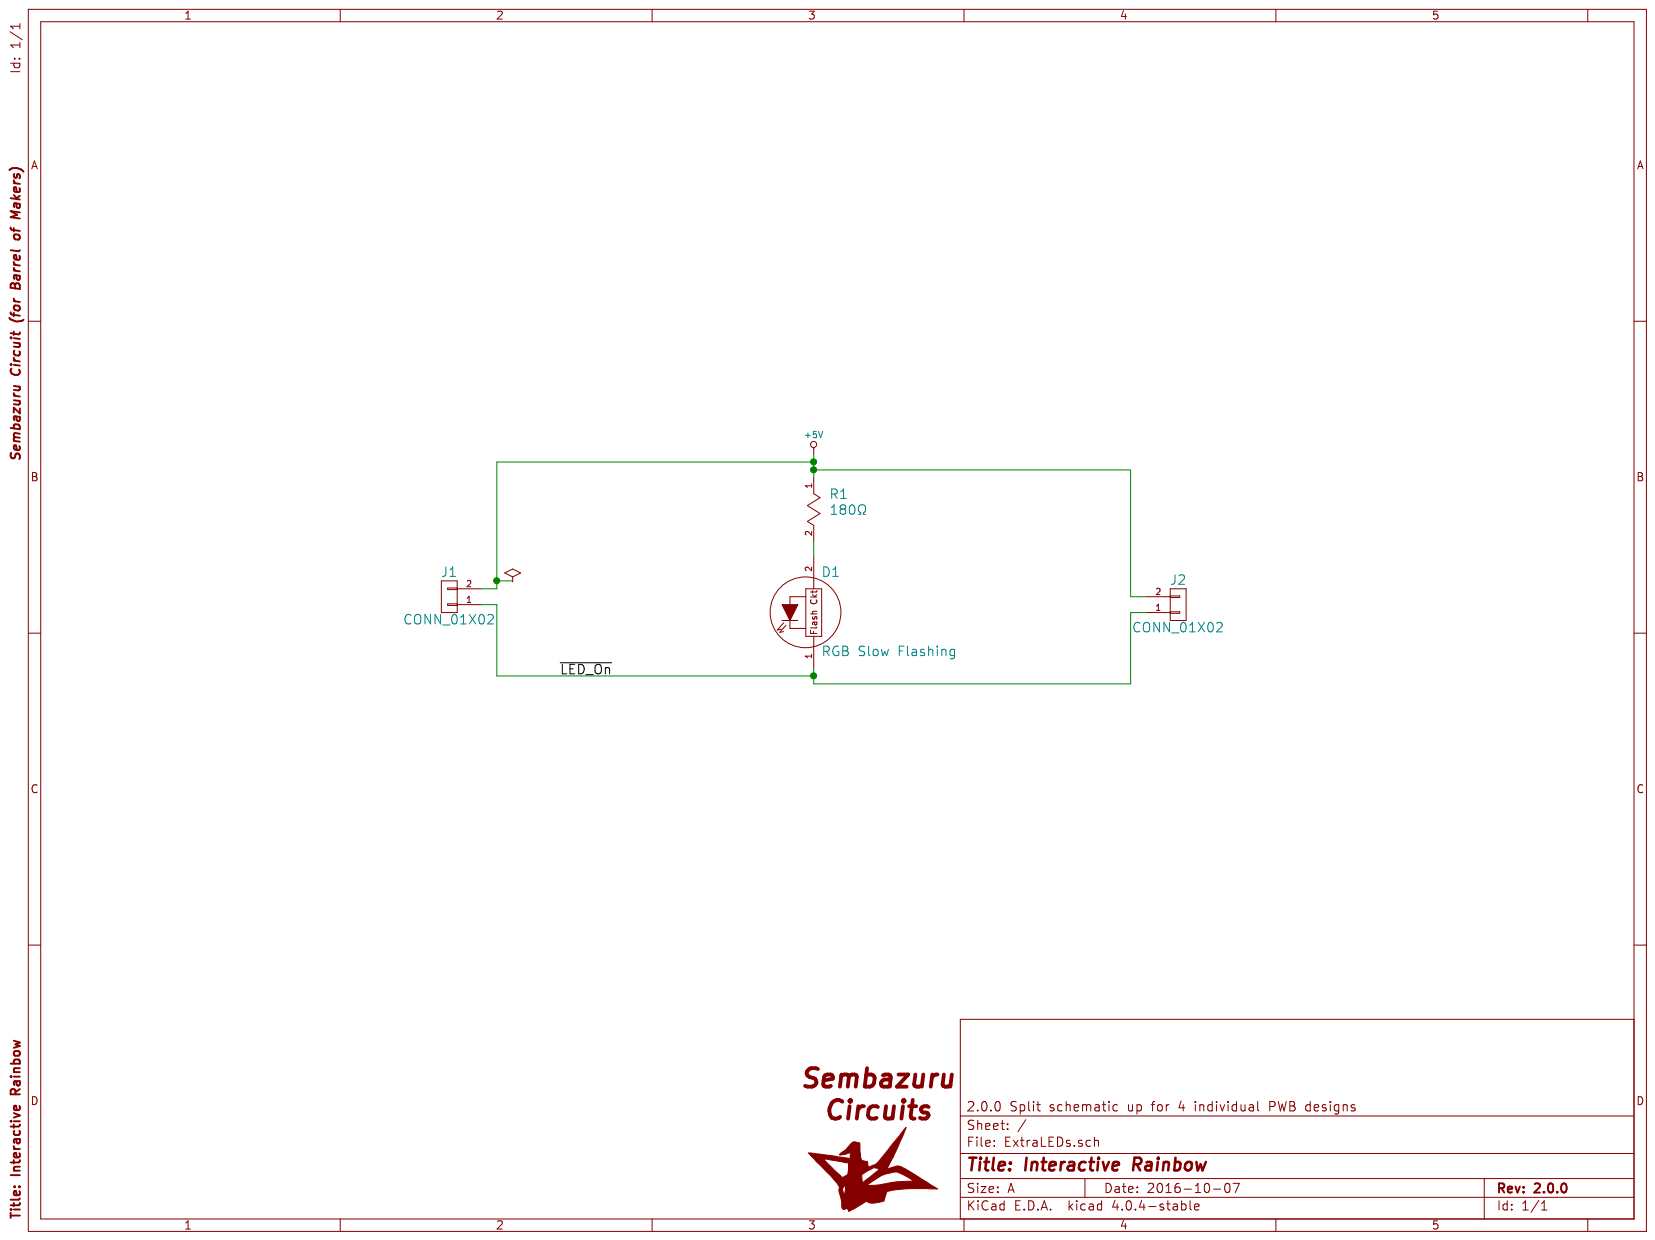
[picture p46: page 1]
