Sembazuru/Interactive-Rainbow/Schematic/I&O_Epander/PCB 1.0.0.pdf

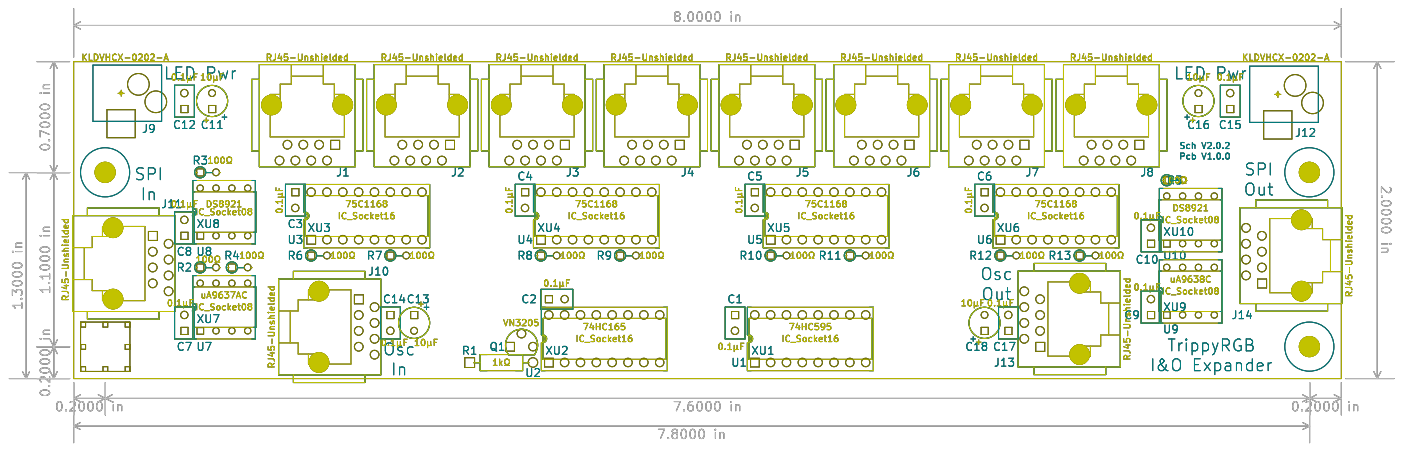
[picture p47: page 1]

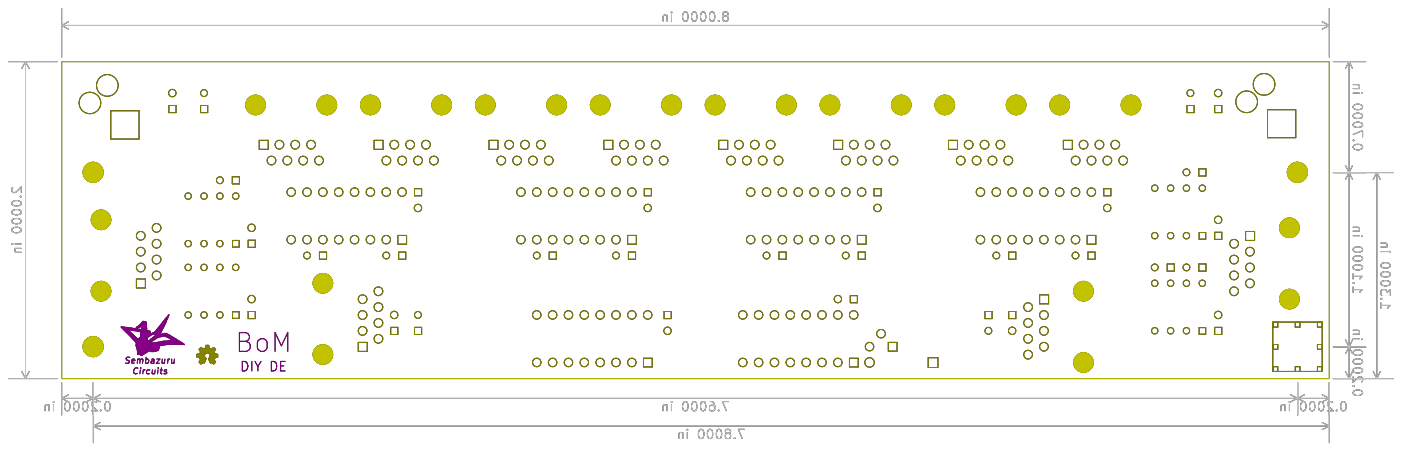
[picture p48: page 2]
