Sembazuru/Interactive-Rainbow/Schematic/I&O_Epander/PCB 1.0.1.pdf

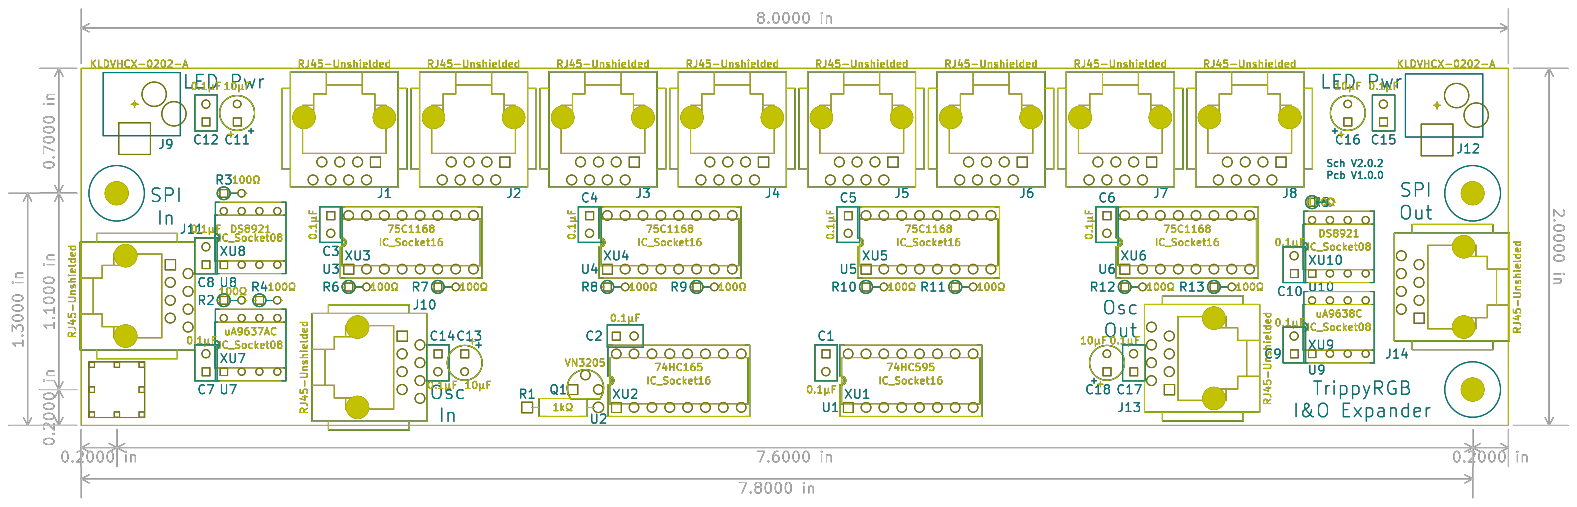
[picture p49: page 1]

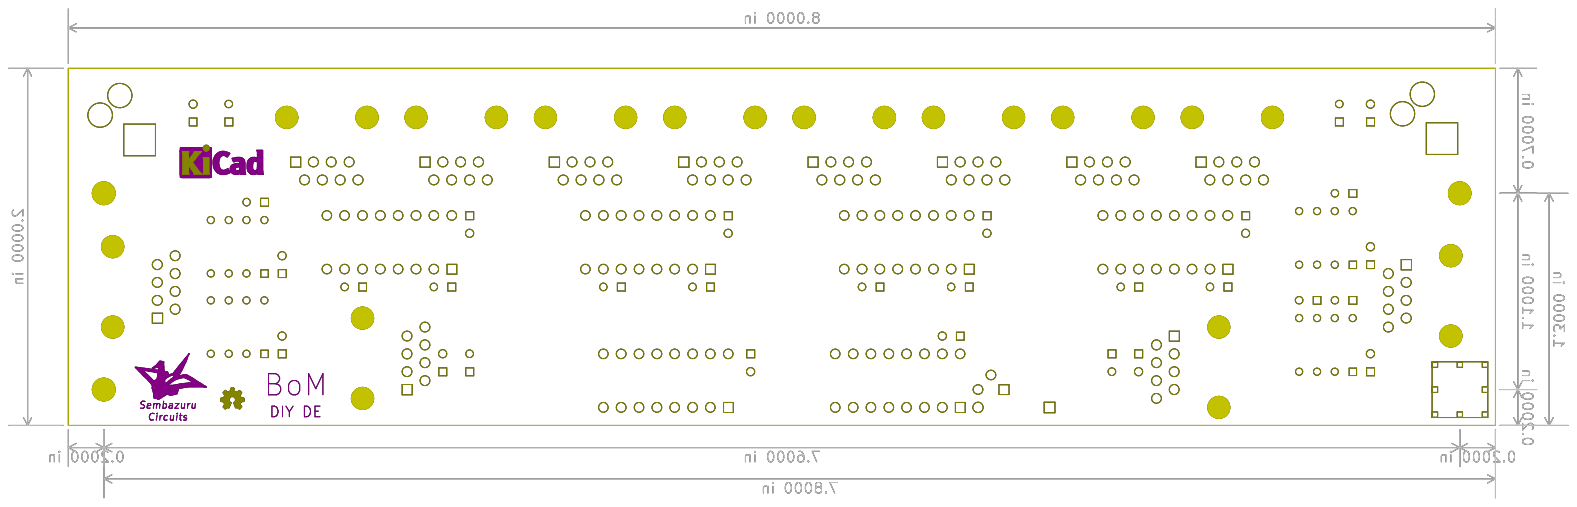
[picture p50: page 2]
