Sembazuru/Interactive-Rainbow/Schematic/LED&Sensor/PCB 1.0.0.pdf

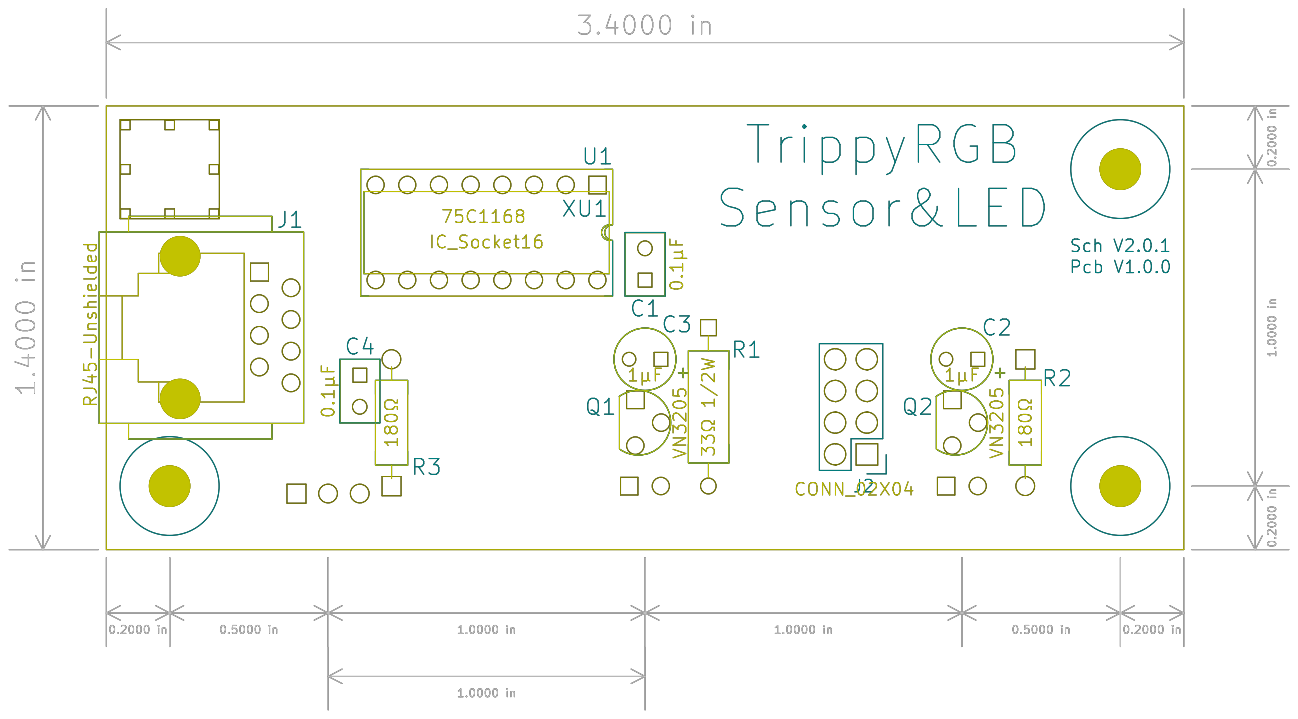
[picture p51: page 1]

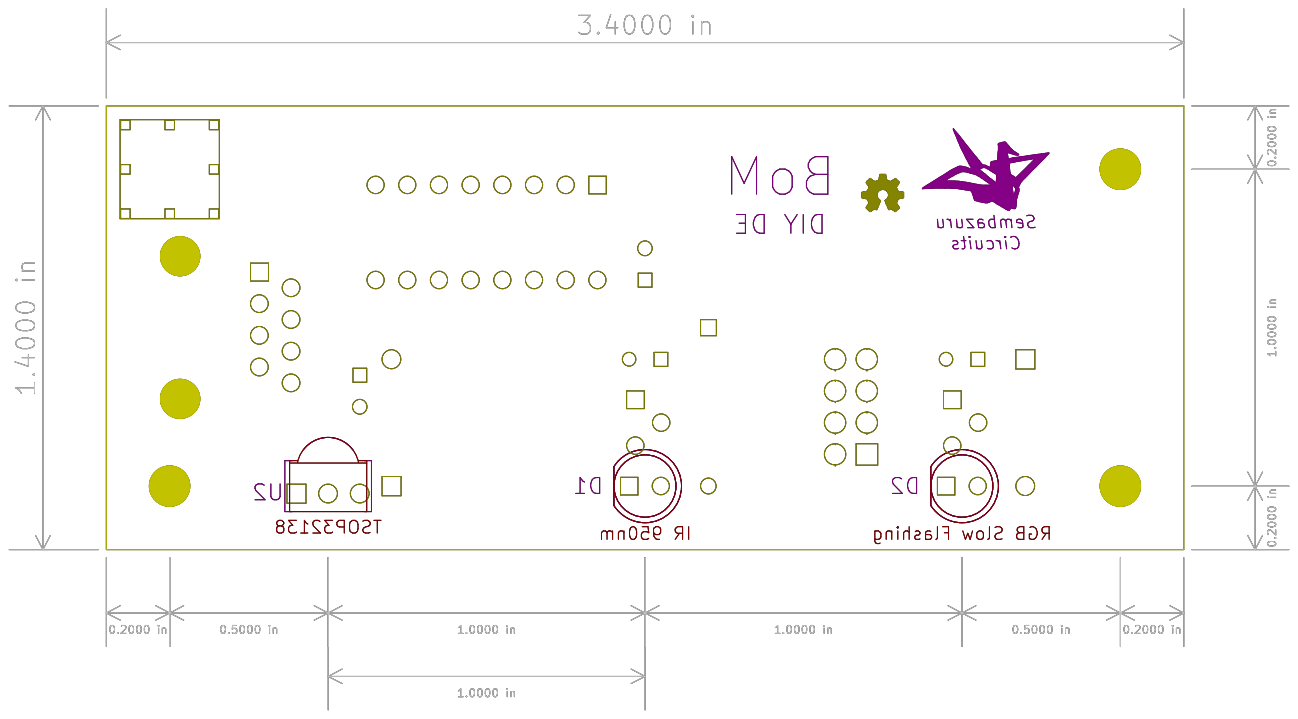
[picture p52: page 2]
