Sembazuru/Interactive-Rainbow/Schematic/LED&Sensor/PCB 1.0.1.pdf

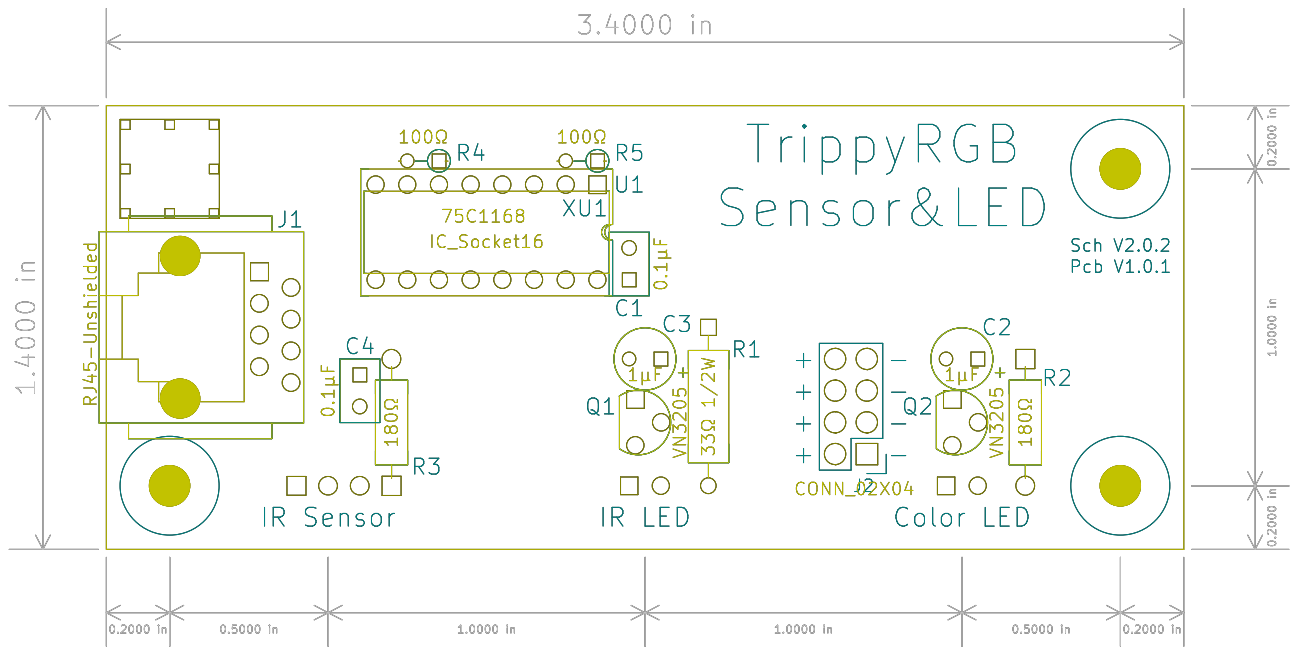
[picture p53: page 1]

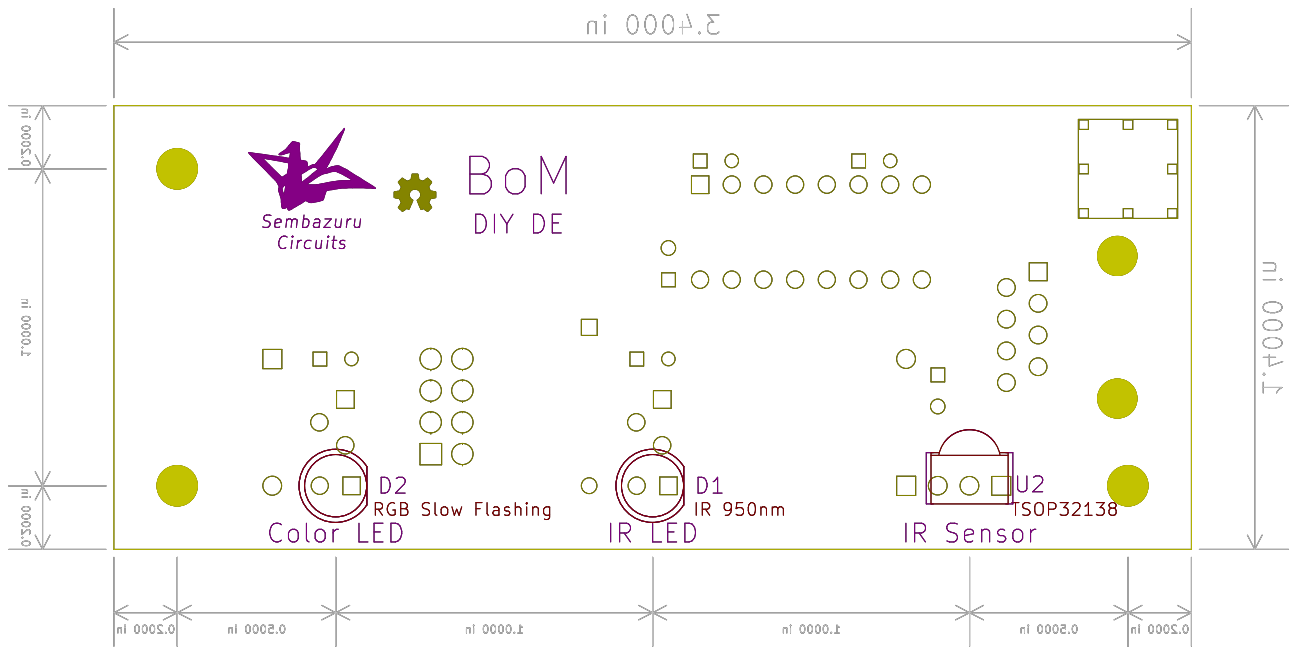
[picture p54: page 2]
