Sembazuru/Interactive-Rainbow/Schematic/LED&Sensor/PCB 1.0.2.pdf

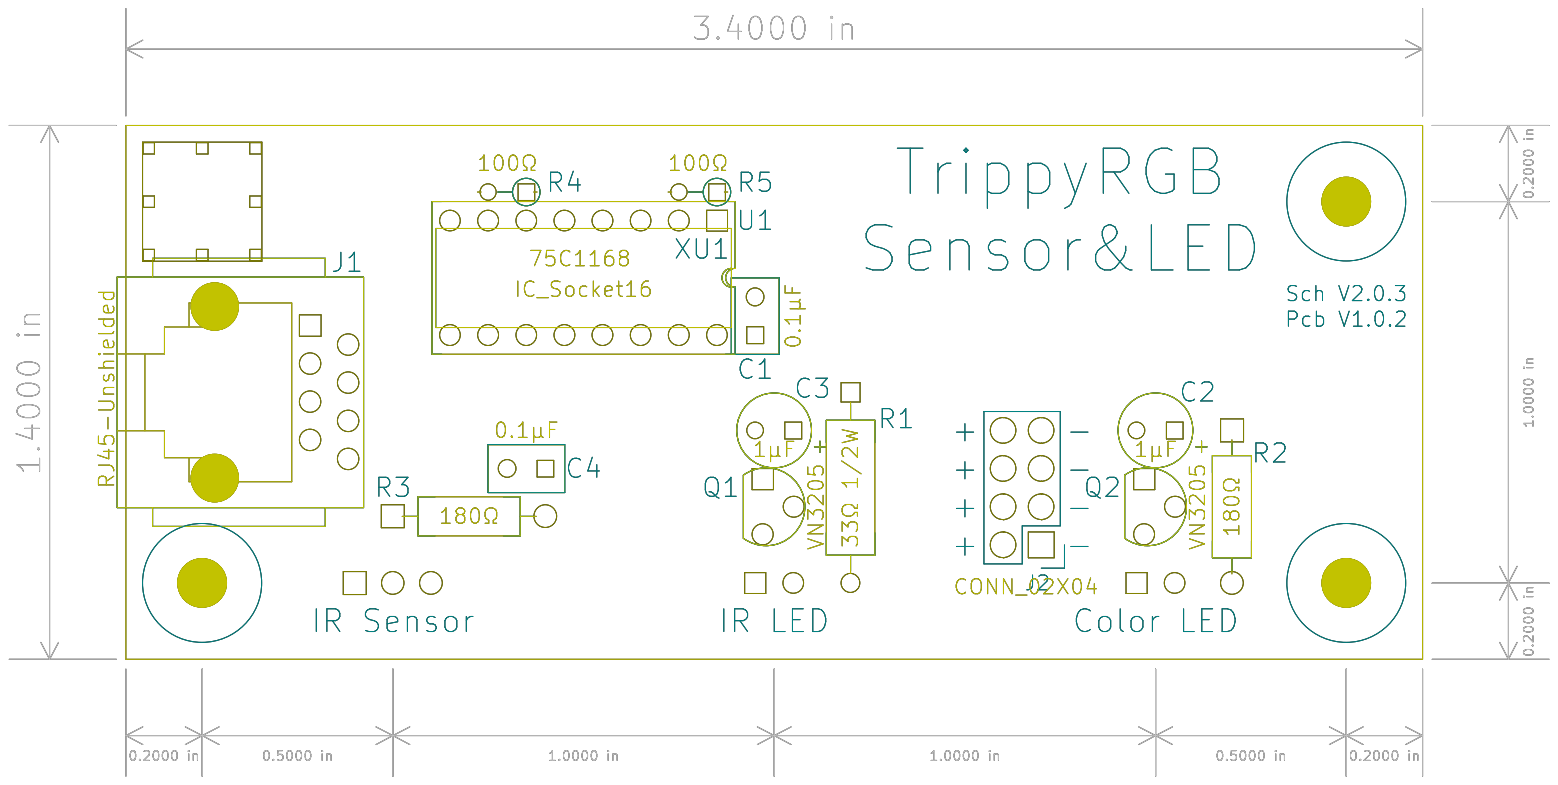
[picture p55: page 1]

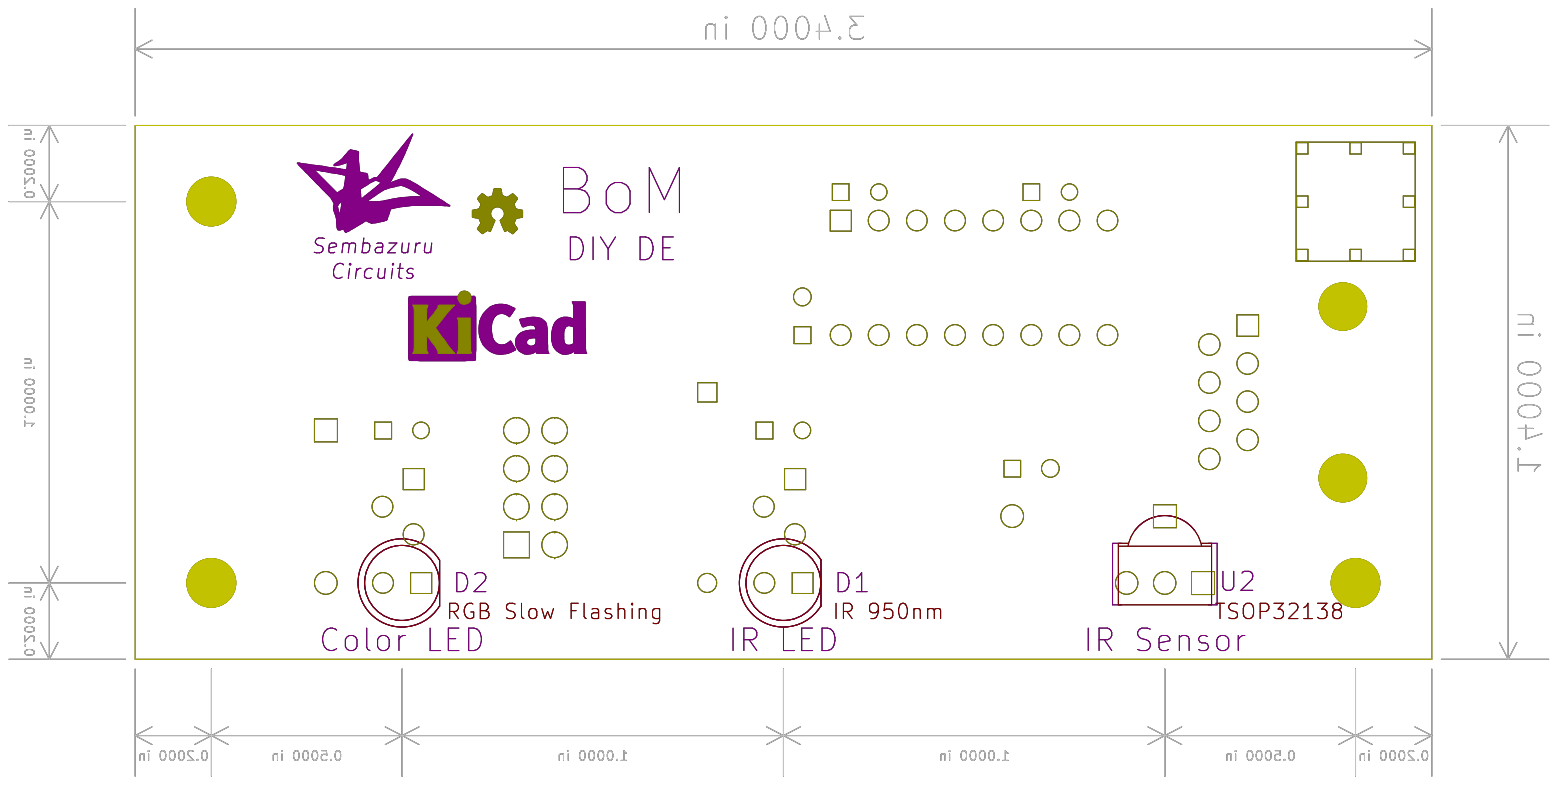
[picture p56: page 2]
