Sembazuru/Interactive-Rainbow/Schematic/LED&Sensor/Schematic 2.0.0.pdf

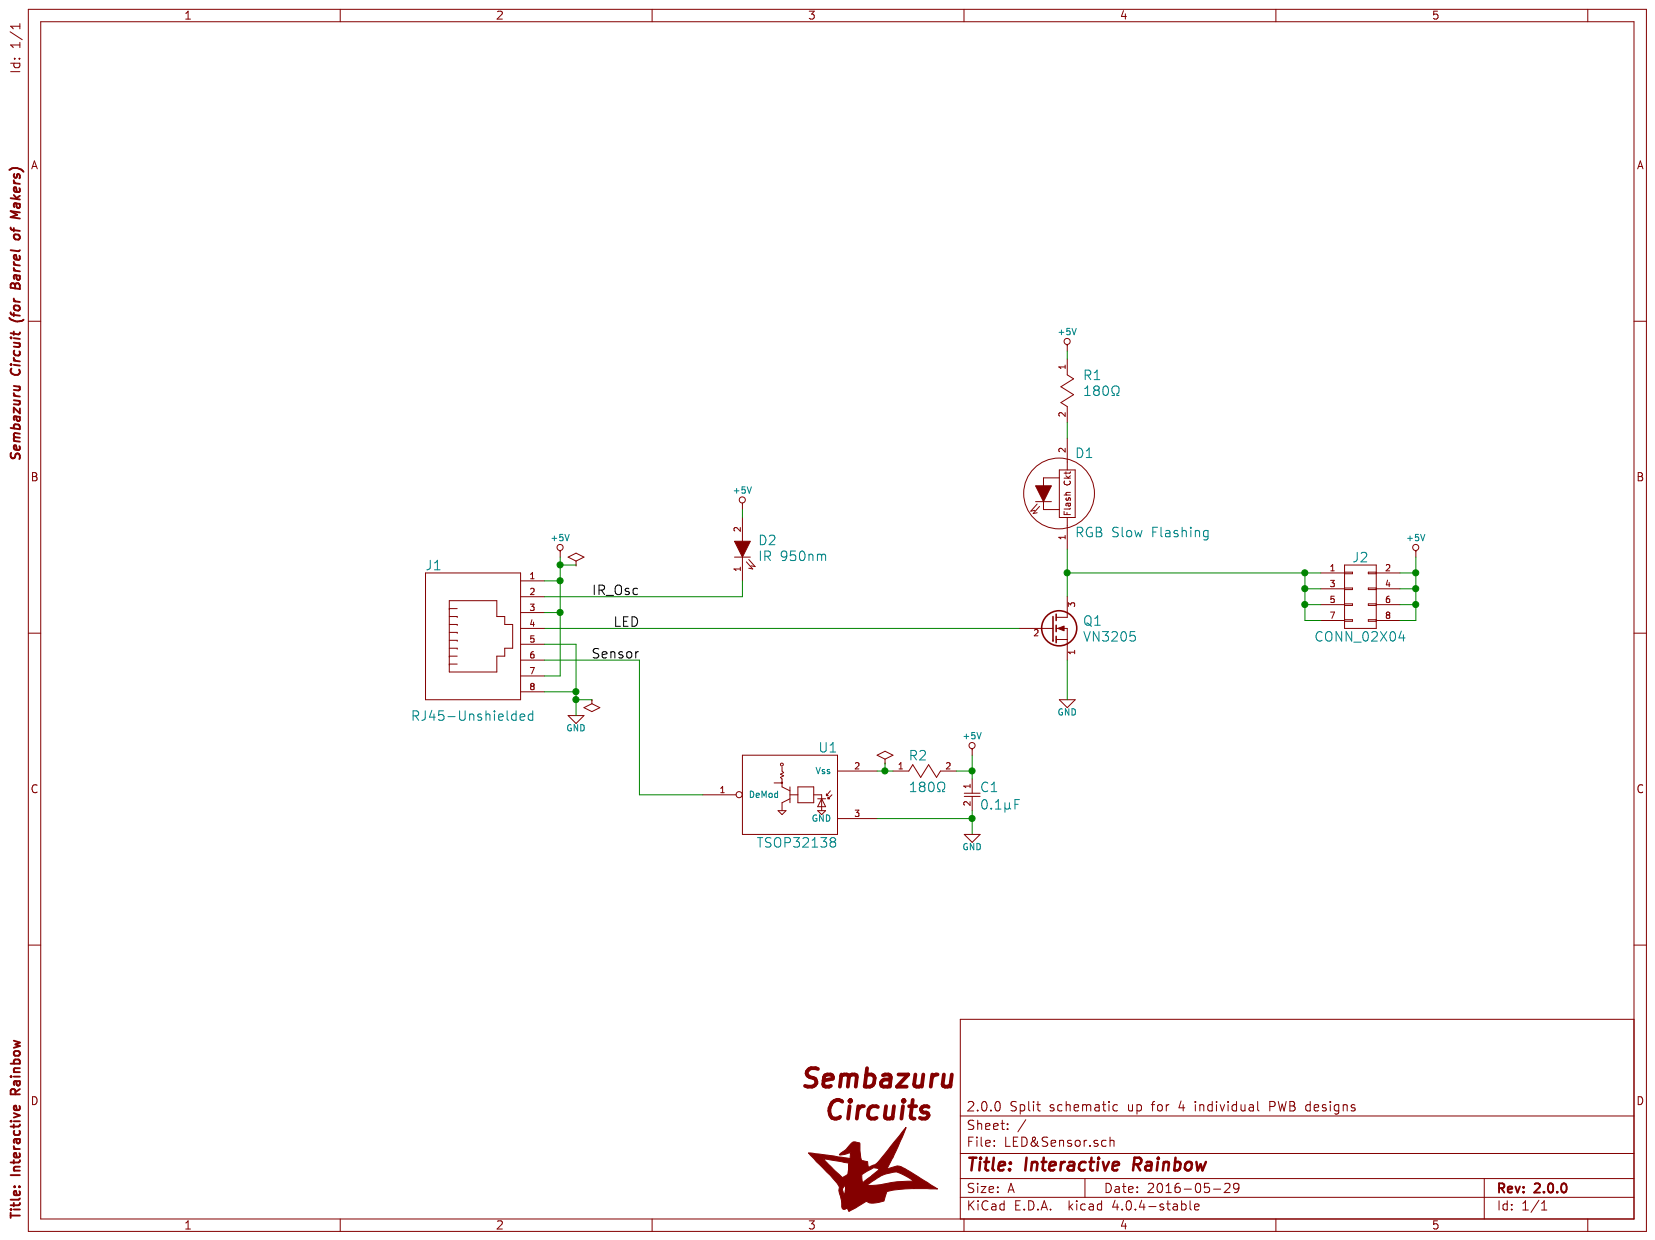
[picture p57: page 1]
