Sembazuru/Interactive-Rainbow/Schematic/LED&Sensor/Schematic 2.0.1.pdf

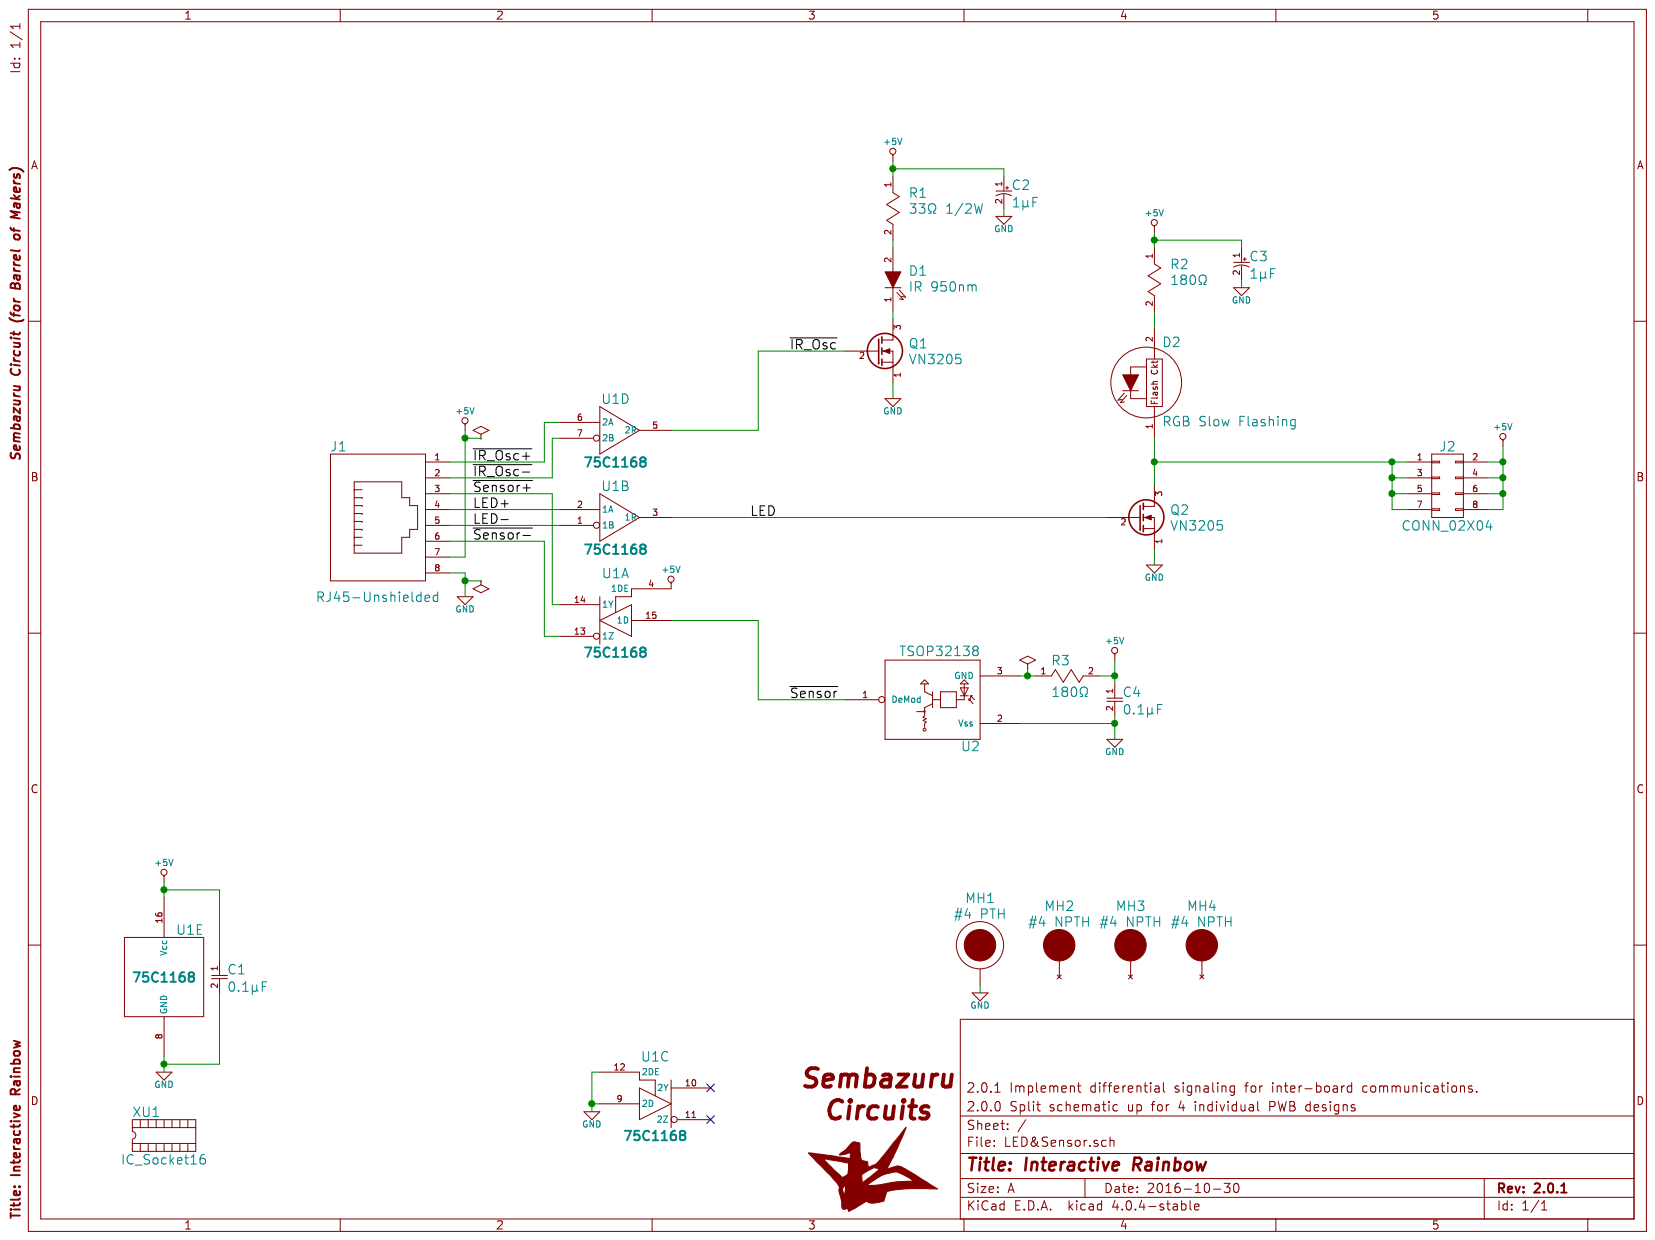
[picture p58: page 1]
