Sembazuru/Interactive-Rainbow/Schematic/LED&Sensor/Schematic 2.0.2.pdf

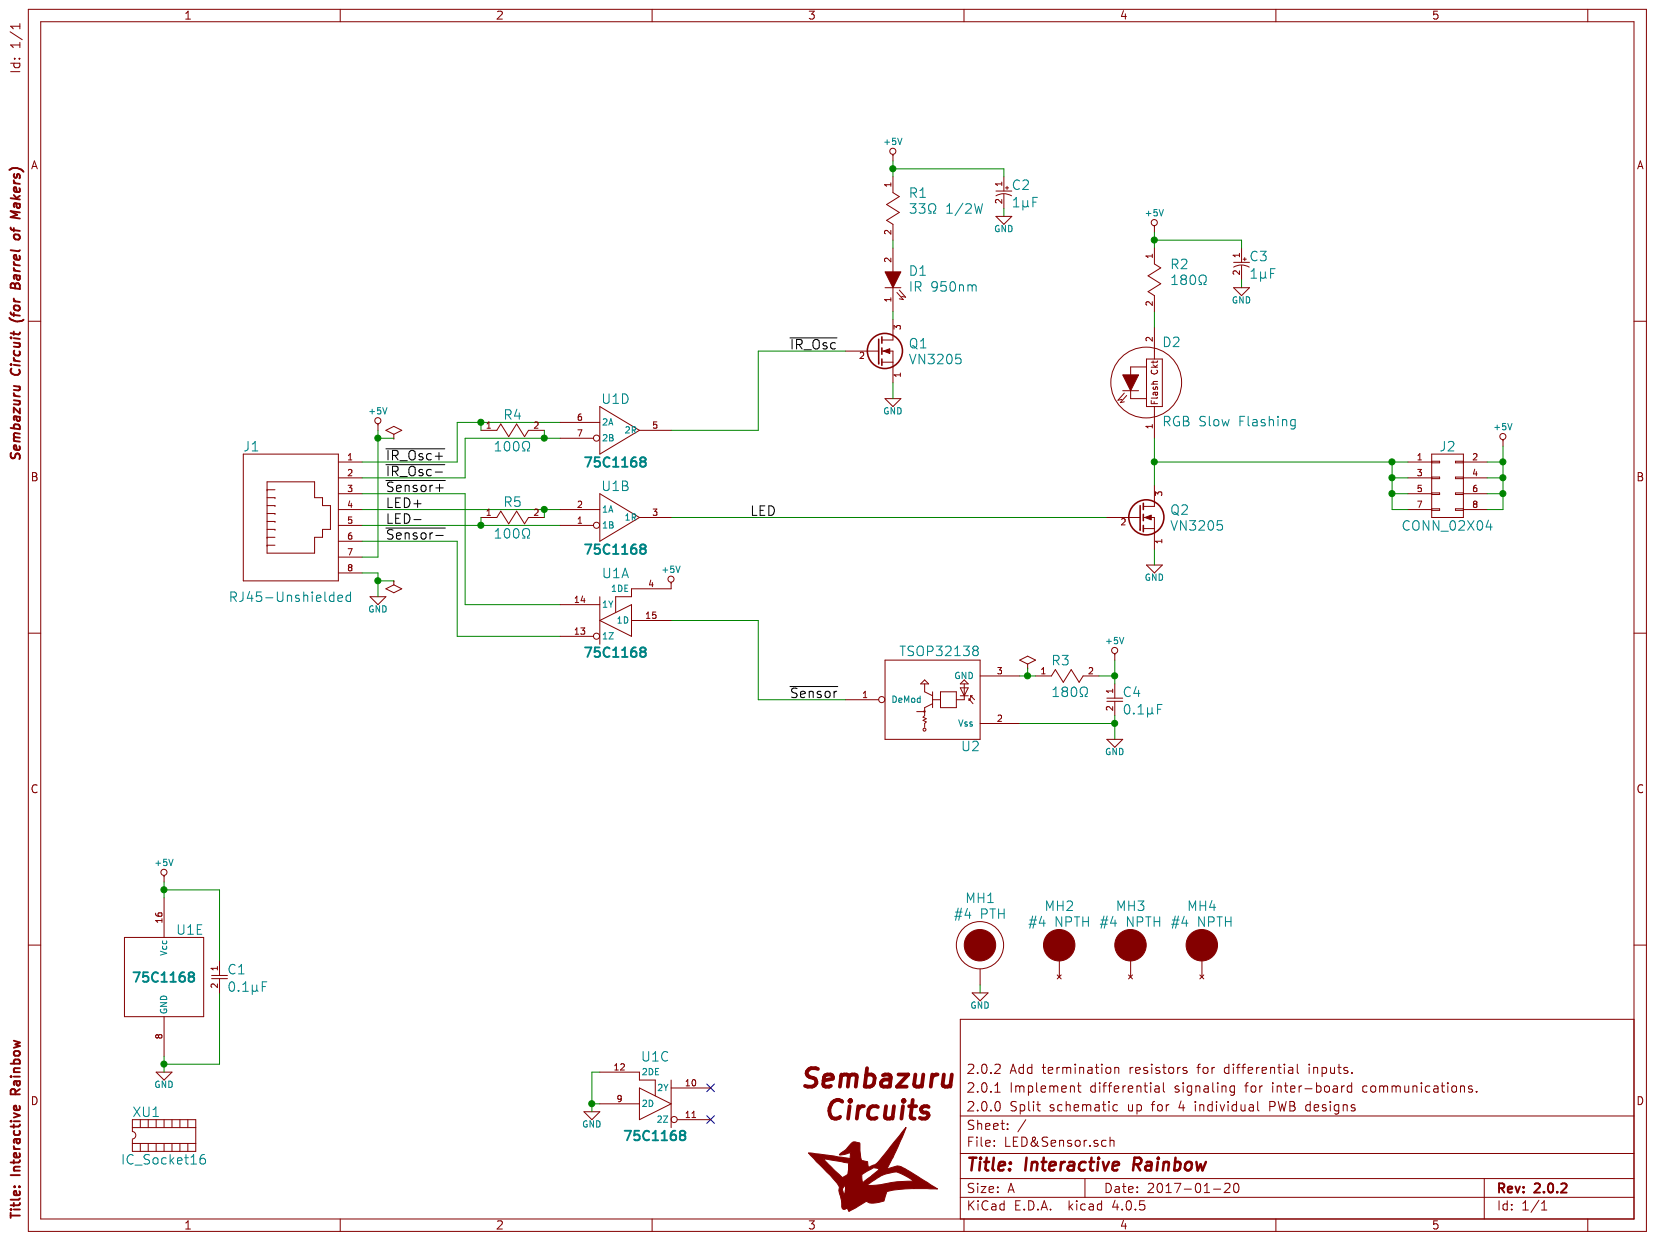
[picture p59: page 1]
