Sembazuru/Interactive-Rainbow/Schematic/LED&Sensor/Schematic 2.0.3.pdf

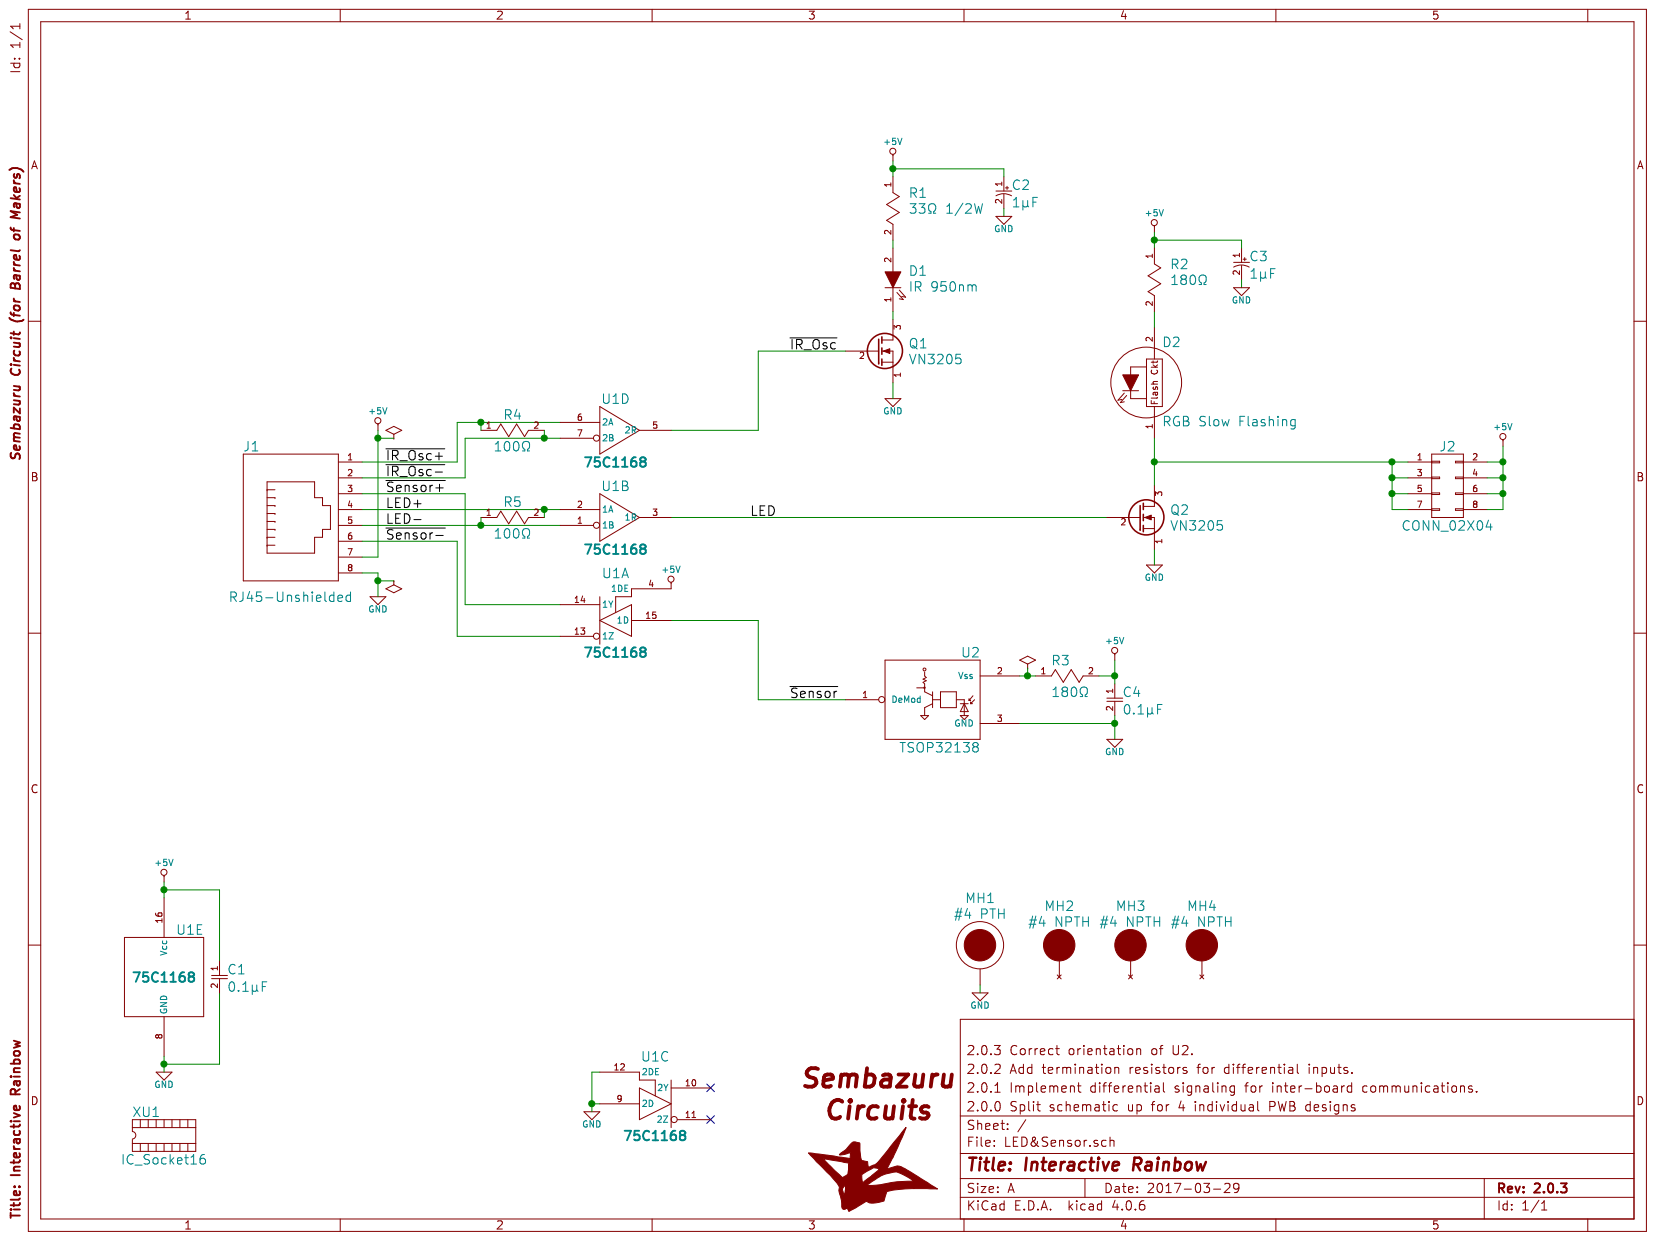
[picture p60: page 1]
