Sembazuru/Interactive-Rainbow/Schematic/Logic&Oscillator/PCB 1.0.0.pdf

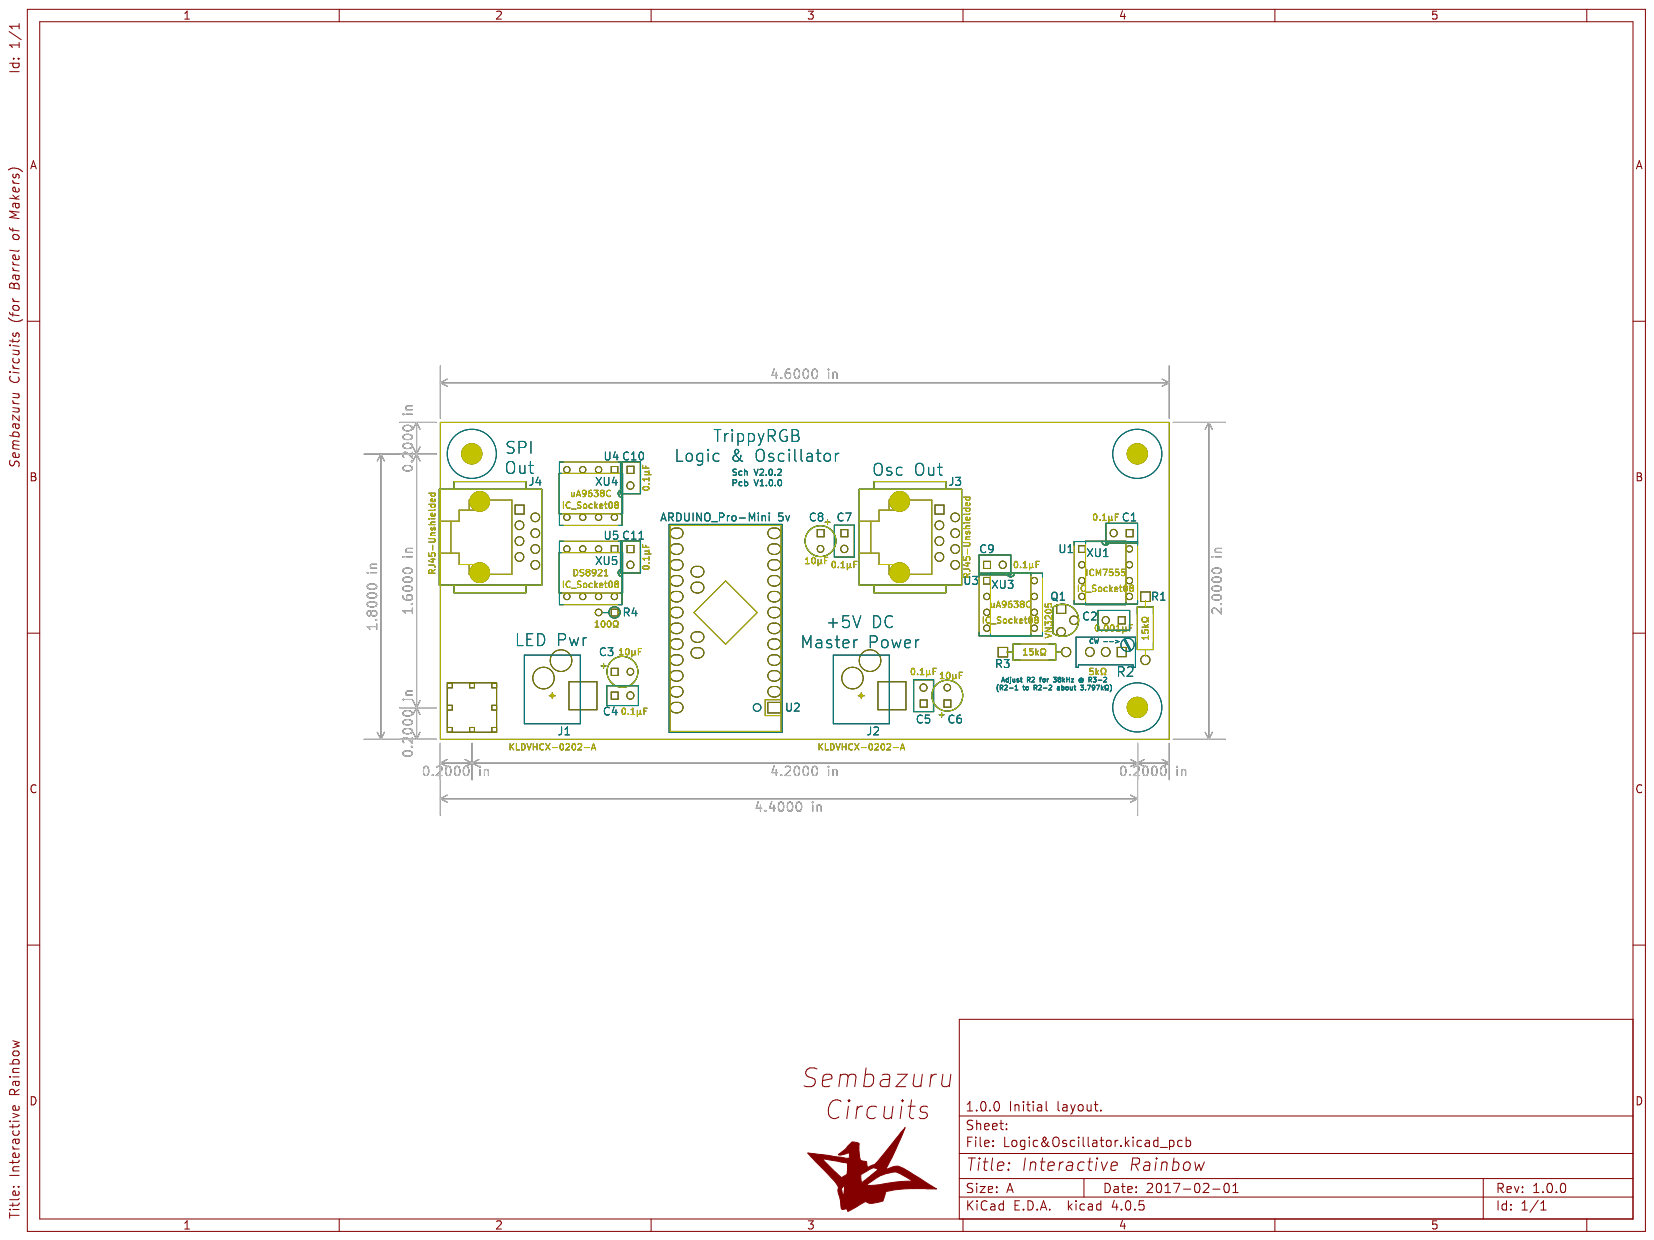
[picture p61: page 1]

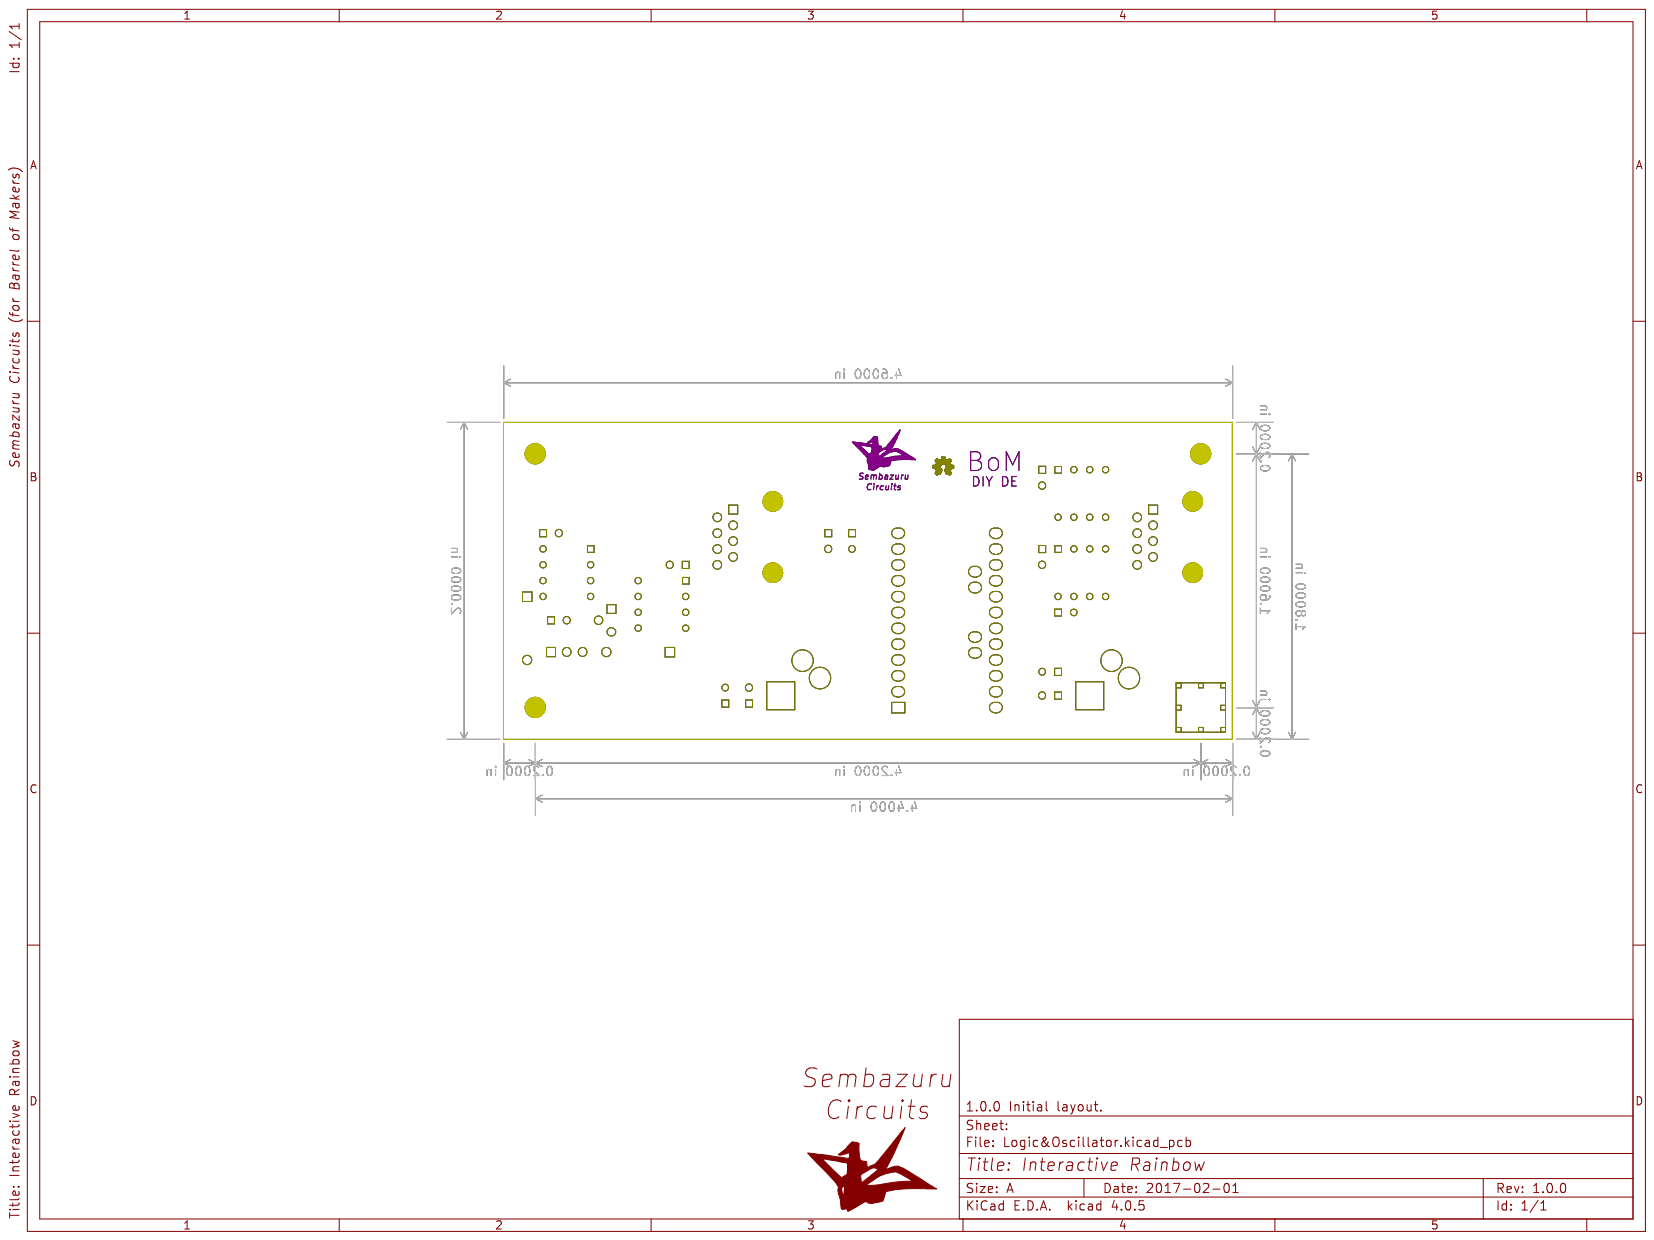
[picture p62: page 2]
