Sembazuru/Interactive-Rainbow/Schematic/Logic&Oscillator/PCB 1.0.1.pdf

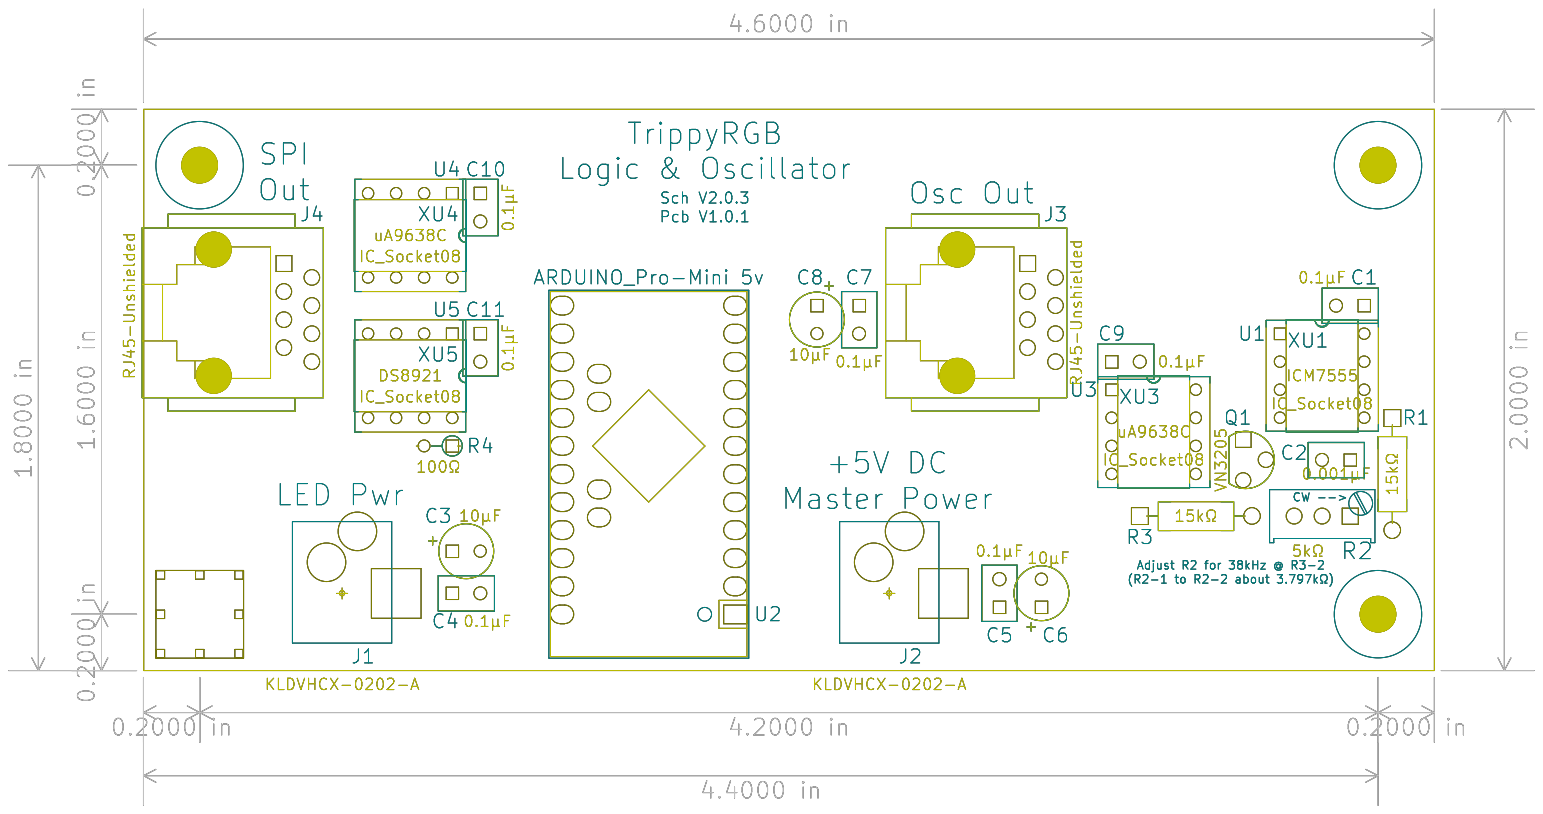
[picture p63: page 1]

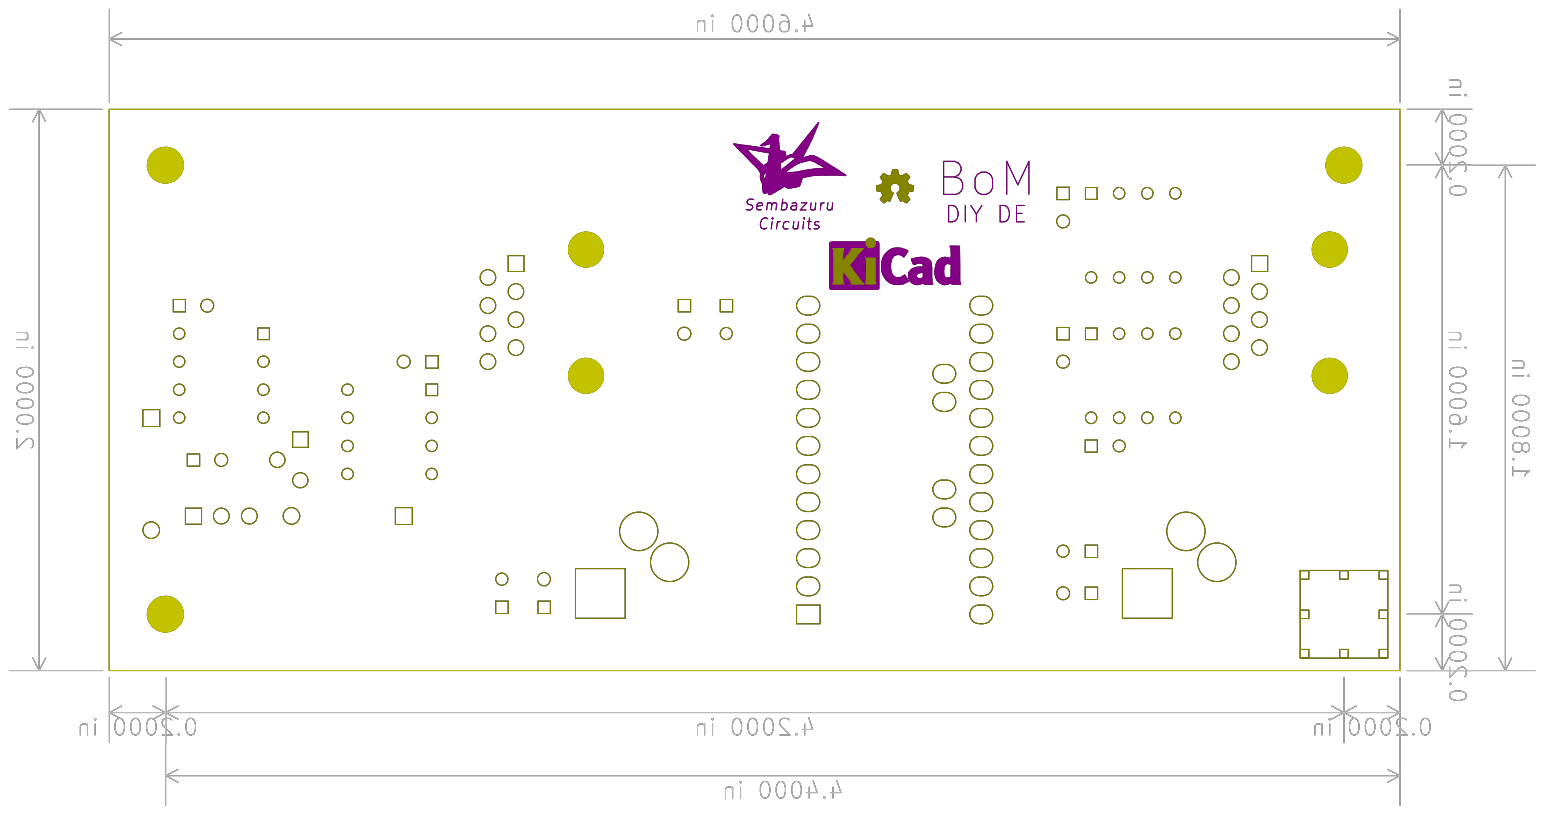
[picture p64: page 2]
