Sembazuru/Interactive-Rainbow/Schematic/Logic&Oscillator/Schematic 2.0.0.pdf

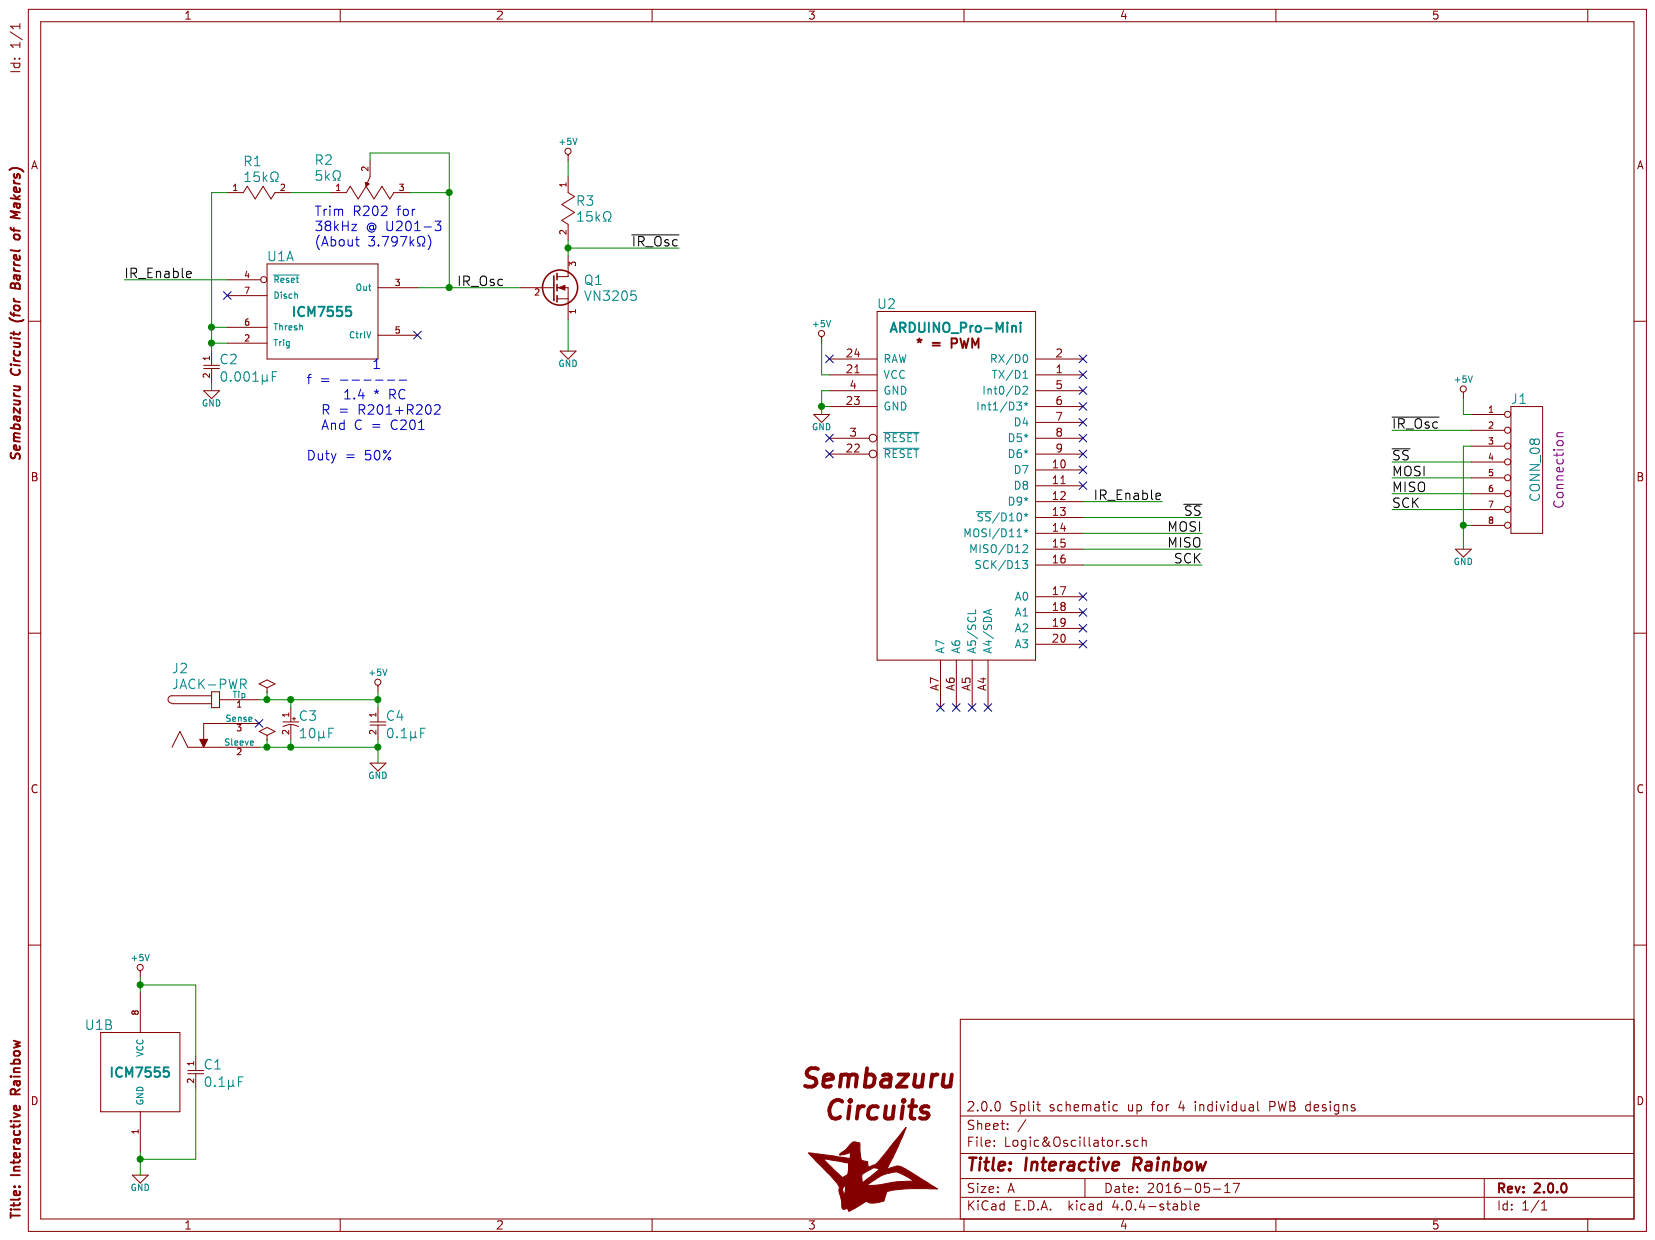
[picture p65: page 1]
