Sembazuru/Interactive-Rainbow/Schematic/Logic&Oscillator/Schematic 2.0.1.pdf

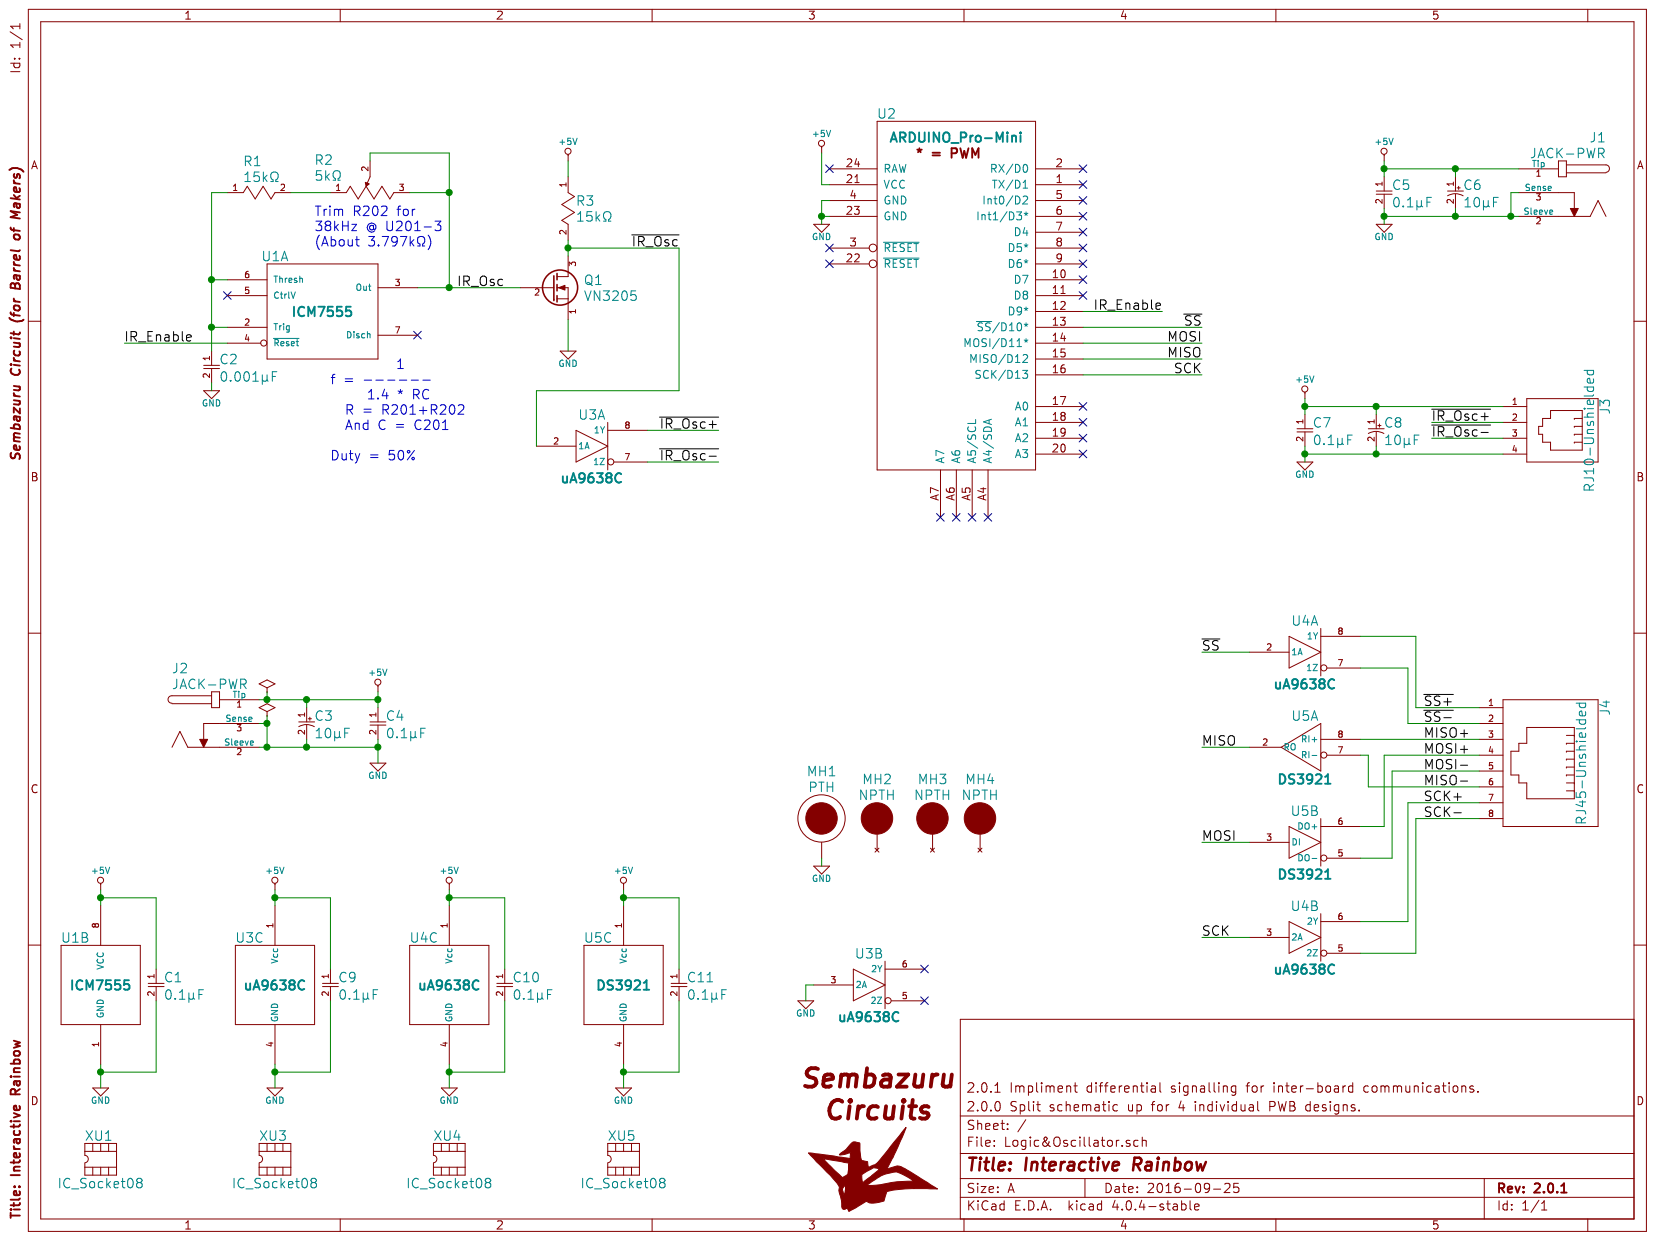
[picture p66: page 1]
