Sembazuru/Interactive-Rainbow/Schematic/Logic&Oscillator/Schematic 2.0.2.pdf

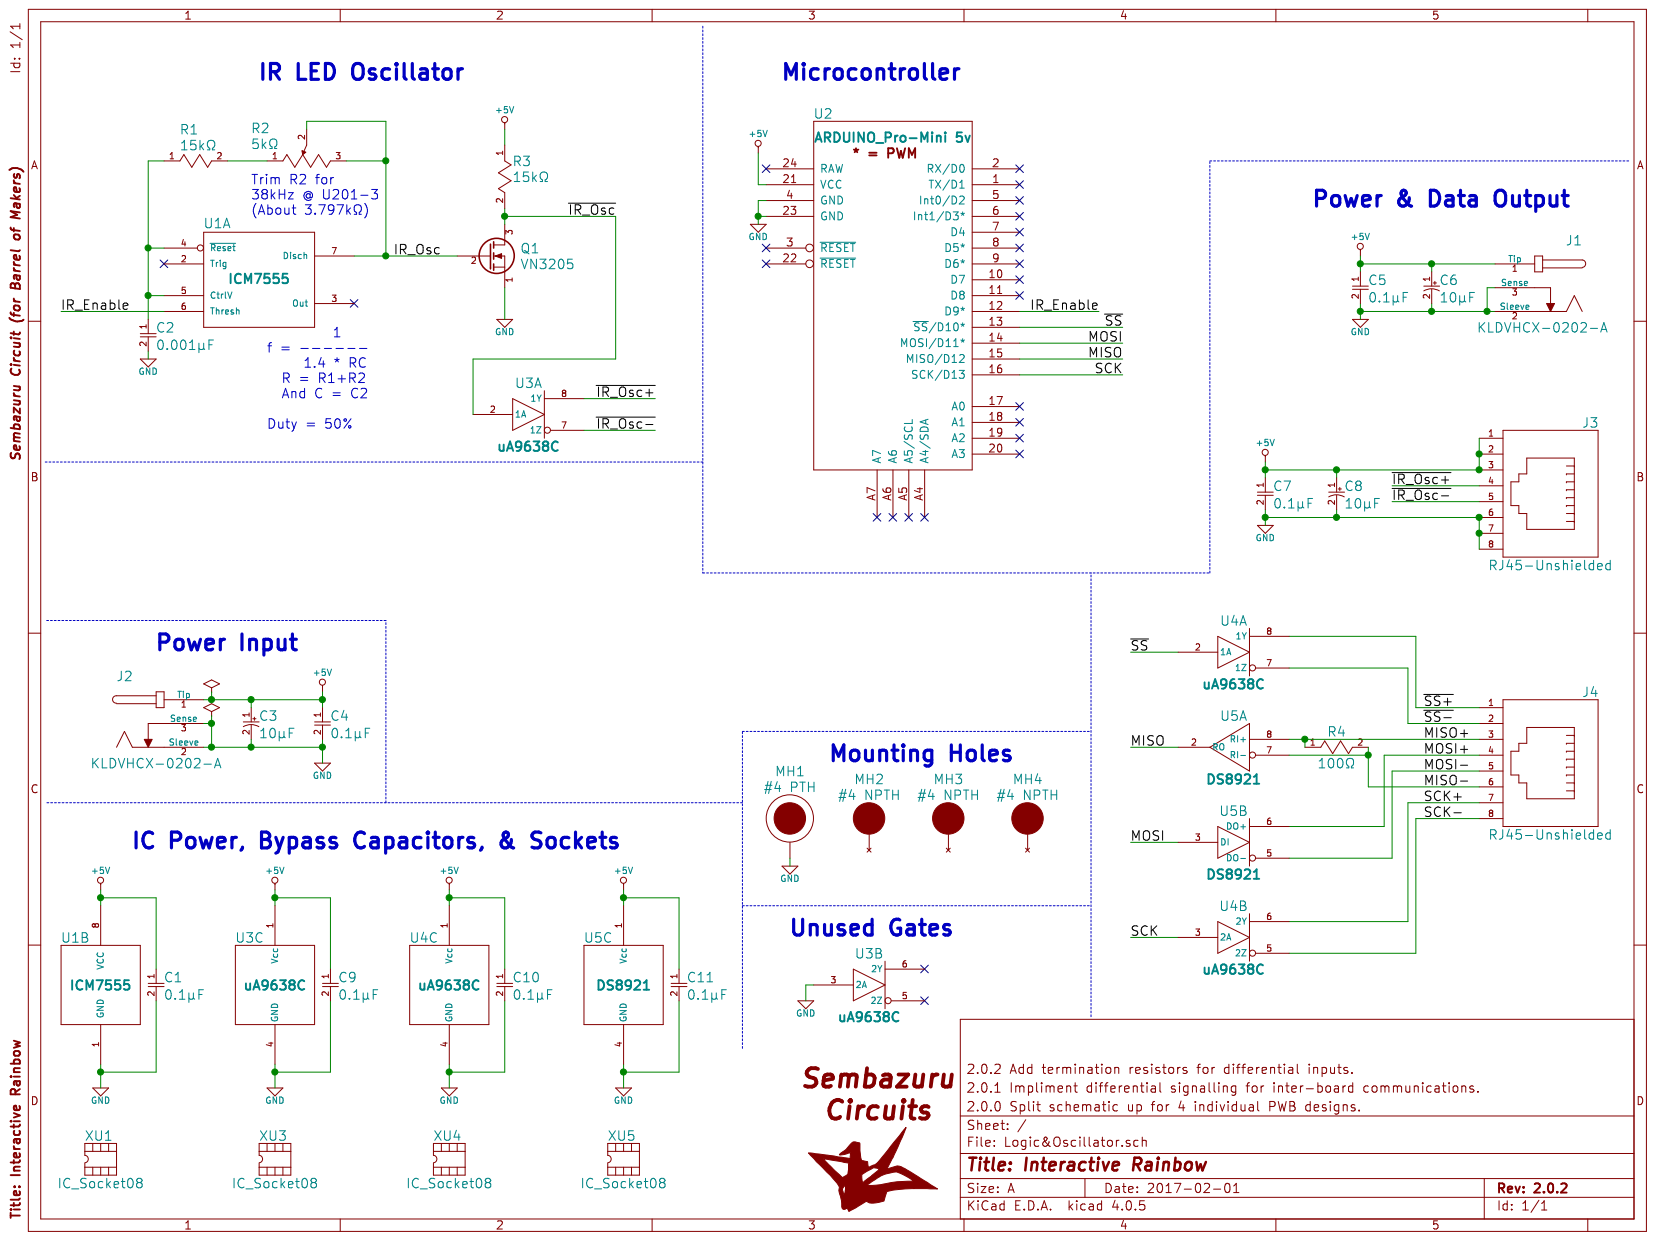
[picture p67: page 1]
