Sembazuru/Interactive-Rainbow/Schematic/Logic&Oscillator/Schematic 2.0.3.pdf

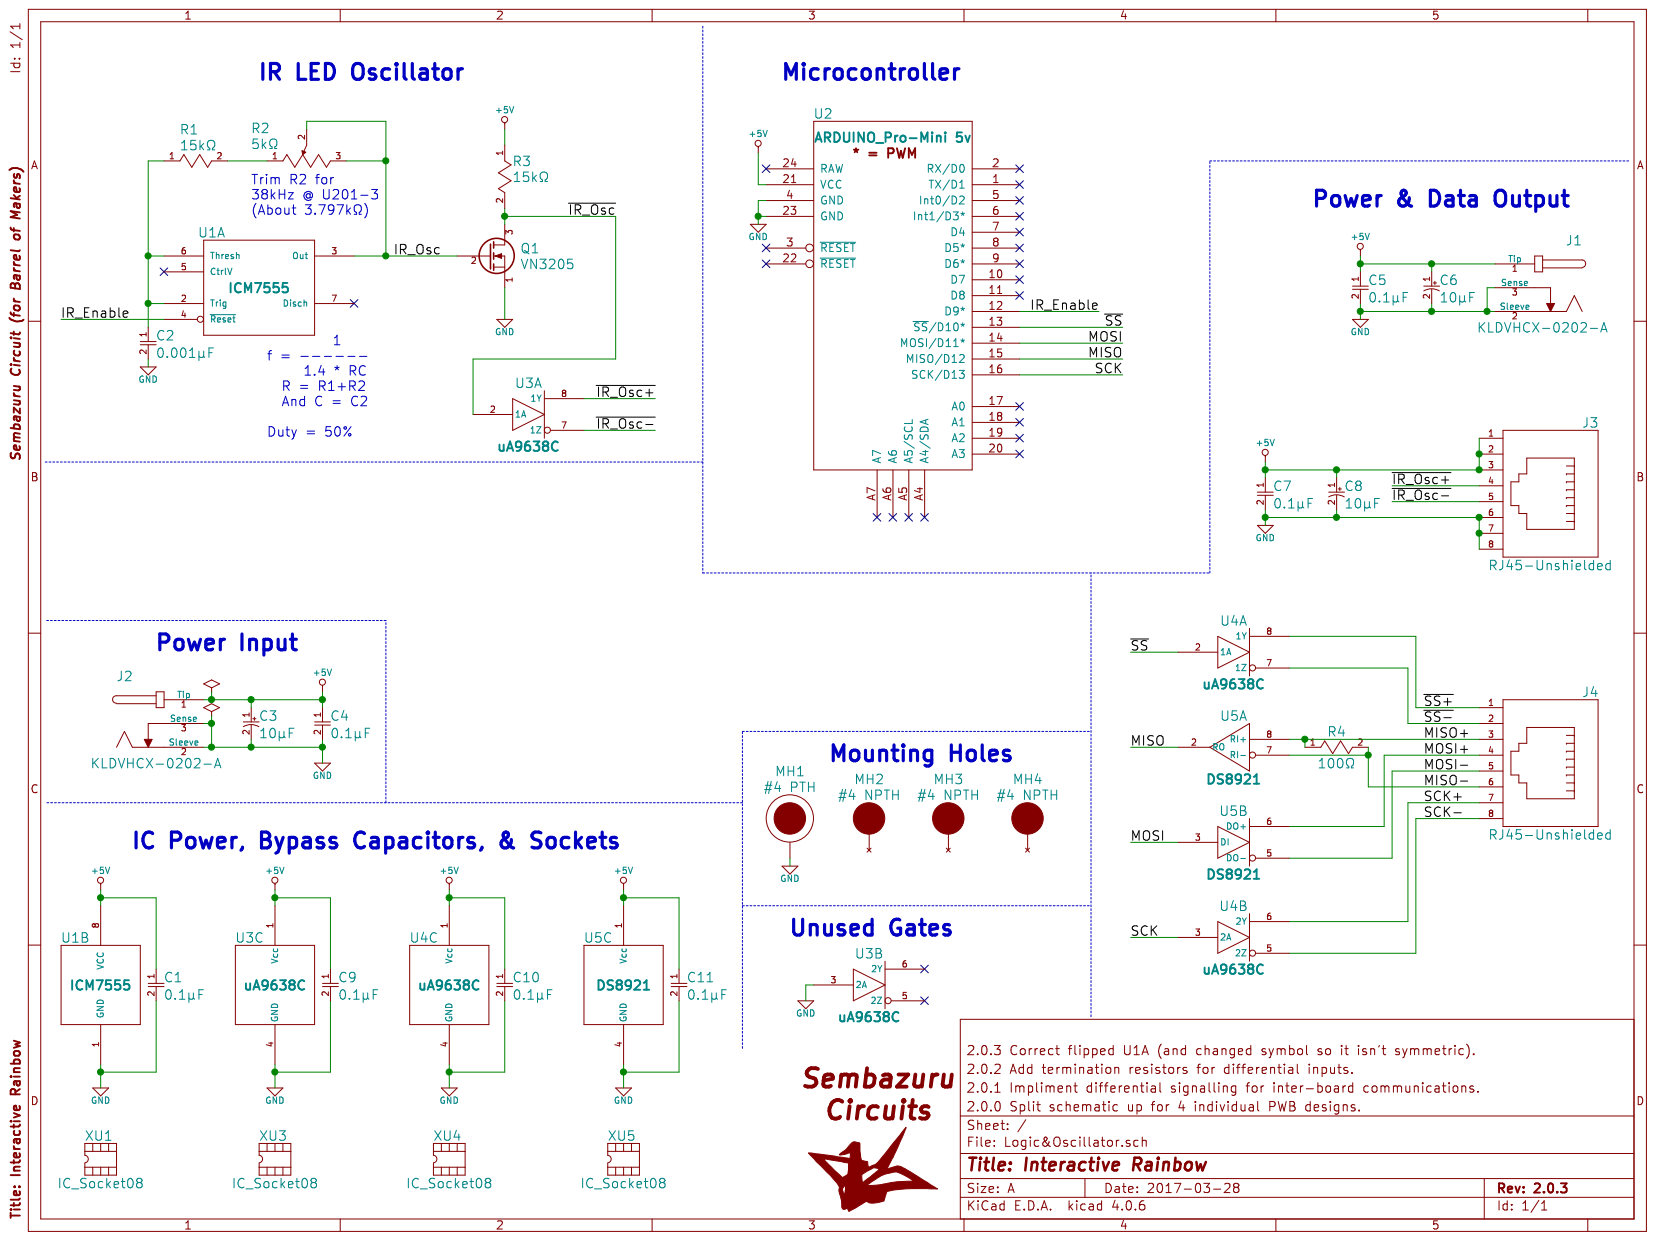
[picture p68: page 1]
