Sembazuru/Interactive-Rainbow/Schematic/I&O_Epander/I&O_Expander_Schematic_v2.0.1.pdf

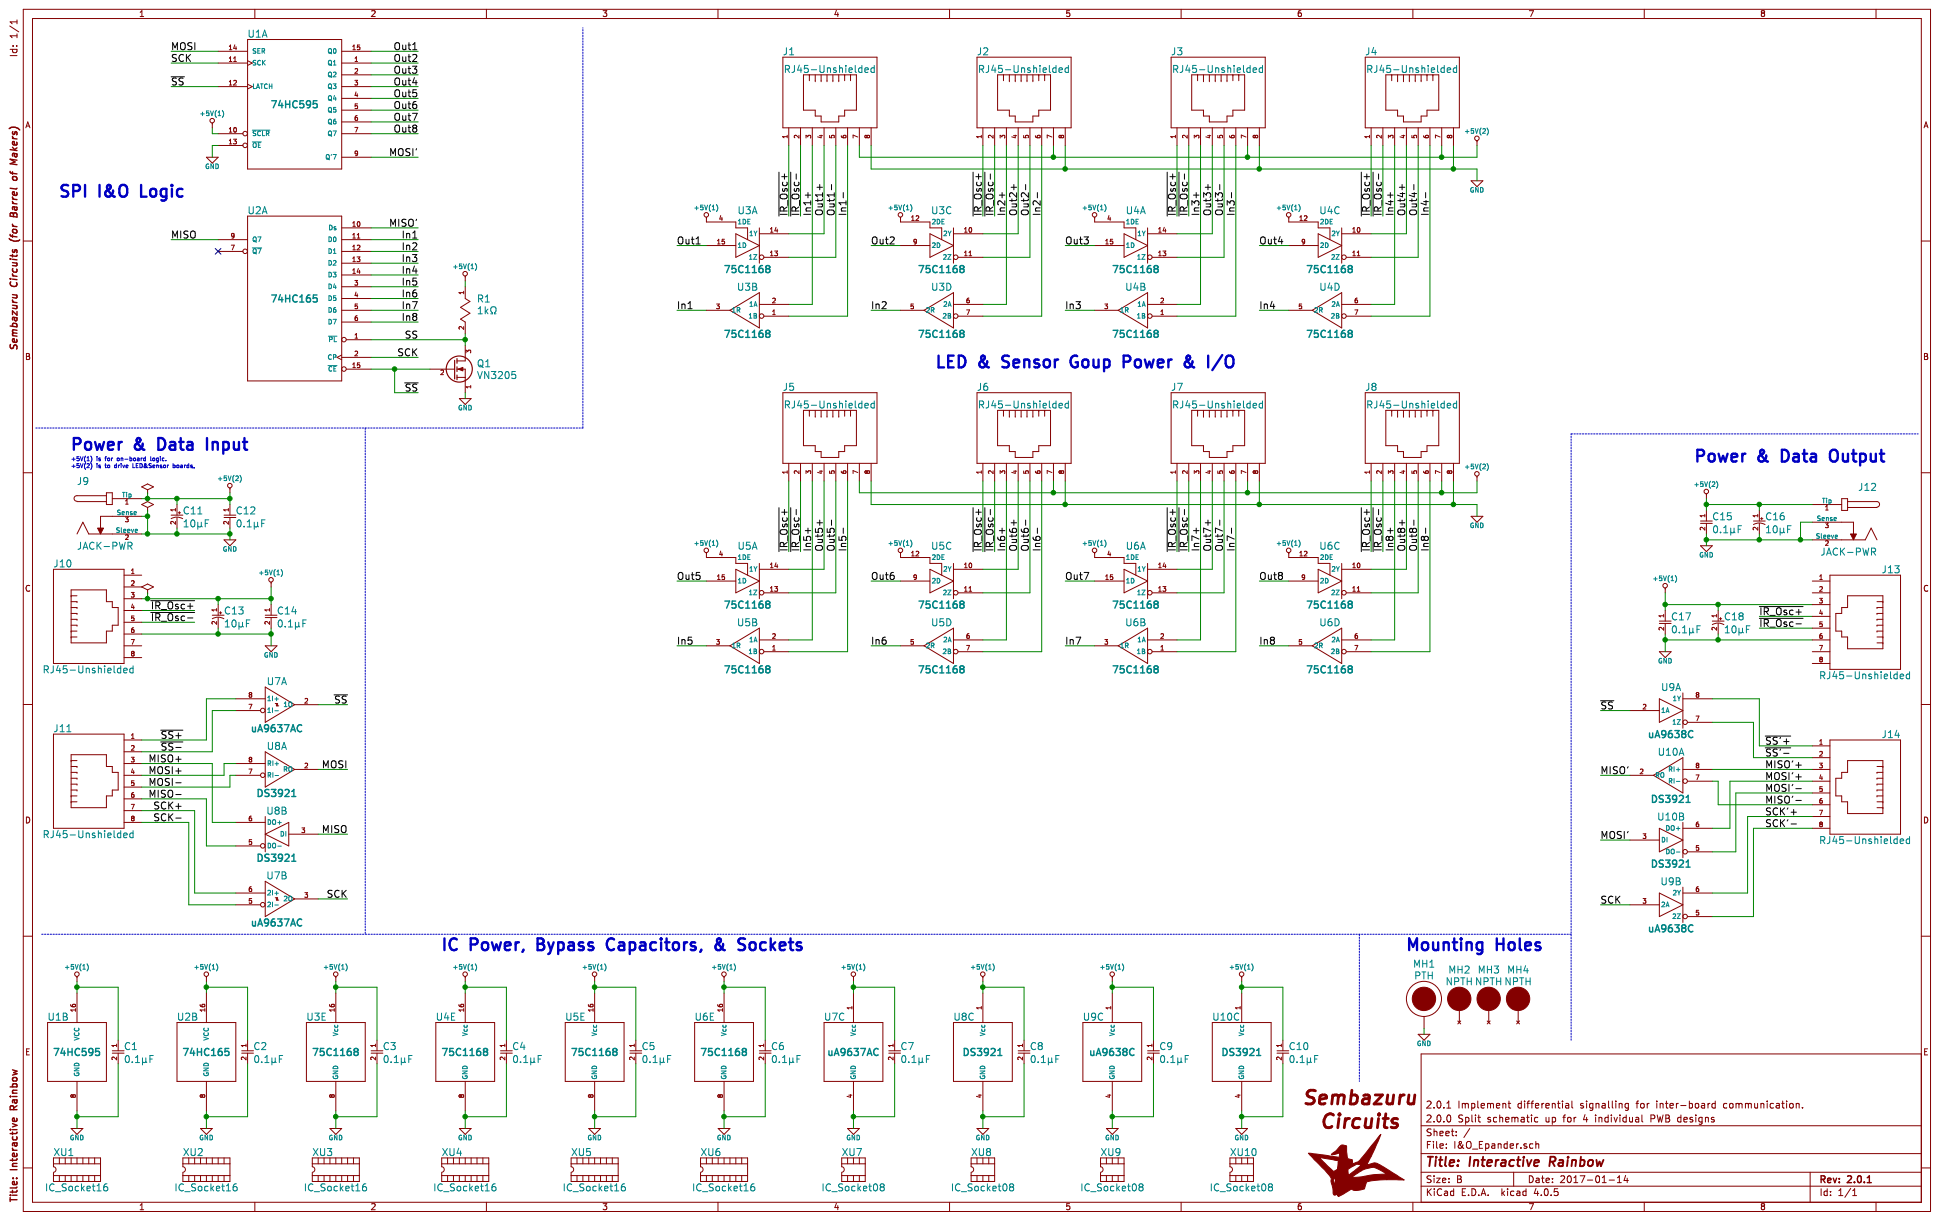
[picture p69: page 1]
