Sembazuru/Interactive-Rainbow/Schematic/I&O_Epander/I&O_Expander_Schematic_v2.0.2.pdf

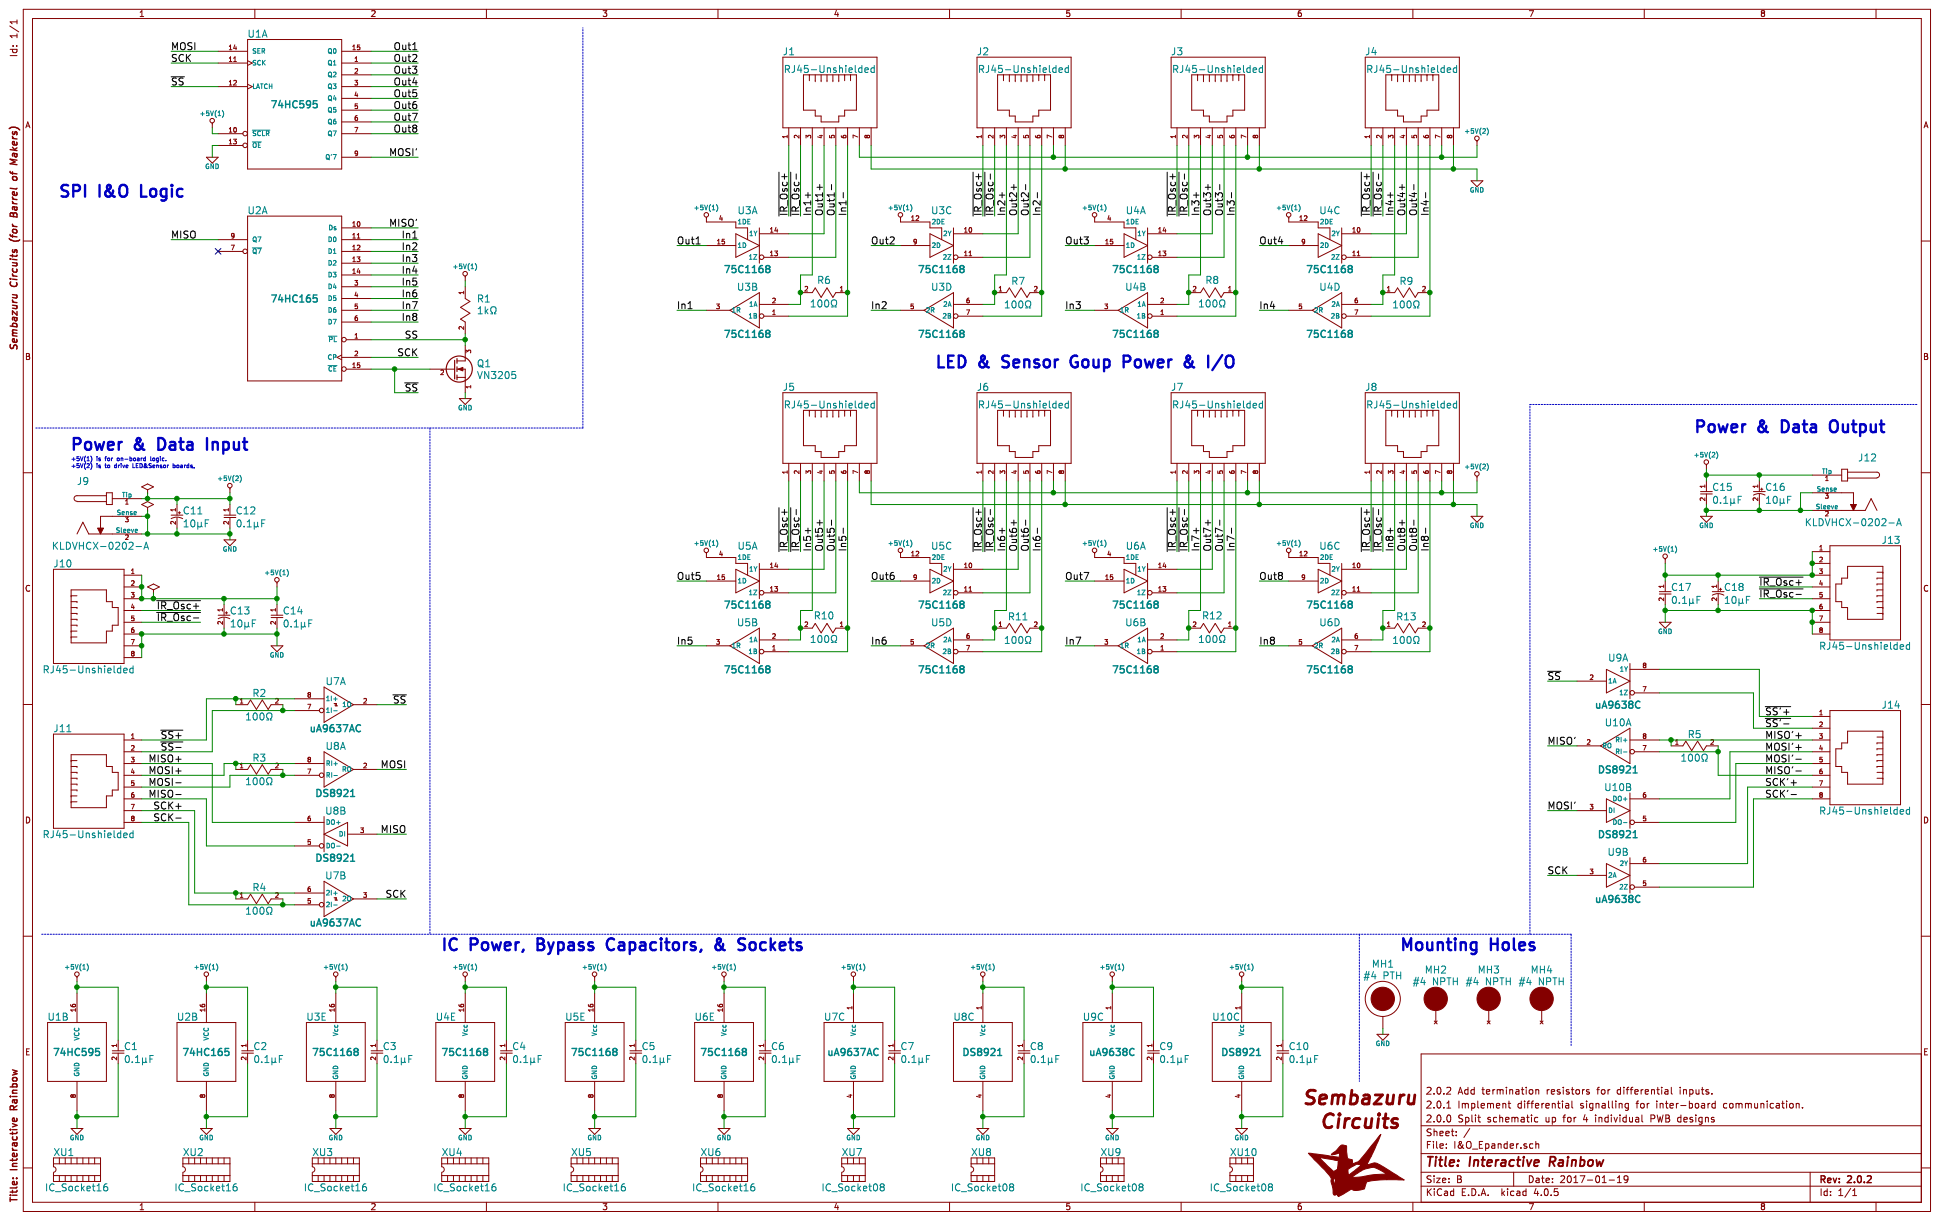
[picture p70: page 1]
