Sembazuru/Interactive-Rainbow/(list of files, drawings)

Other design files:
Schematic/LED_Group_Perfboard.fzz
