Sembazuru/Interactive-Rainbow/Schematic/ExtraLEDs/ExtraLEDs.kicad_pcb

## KiCad design Schematic/ExtraLEDs/ExtraLEDs.kicad_pcb (2018-09-17)

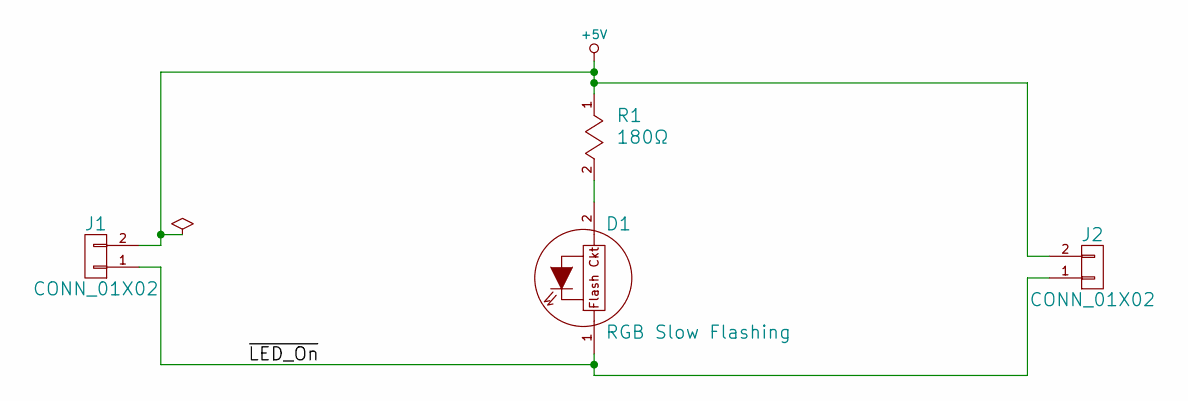
[picture p71: schematic ExtraLEDs.sch, Interactive Rainbow - Extra LEDs]

Parts:
D1: RGB Slow Flashing; LEDRD254W50D500H960P; MfgPart ADA679
J1, J2: CONN_01X02; HDRV2W64P254_1X2_508X254X1016A
R1: 180Ω; RESAD1016W56L681D259

Connections:
+5V: J1.2, J2.2, R1.1
/~LED_On: D1.1 (K), J1.1, J2.1
unnamed: D1.2 (A), R1.2

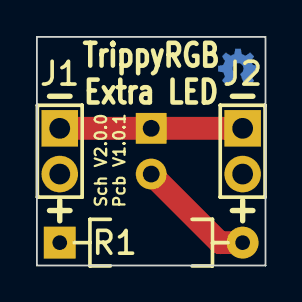
[picture p72: board ExtraLEDs.kicad_pcb from above]

Board: 2 copper layers, 12.7 x 12.7 mm, 4 parts (1 on the bottom side), 3 nets.
