Sembazuru/Interactive-Rainbow/Schematic/I&O_Epander/I&O_Epander.kicad_pcb

## KiCad design Schematic/I&O_Epander/I&O_Epander.kicad_pcb (2018-09-17)

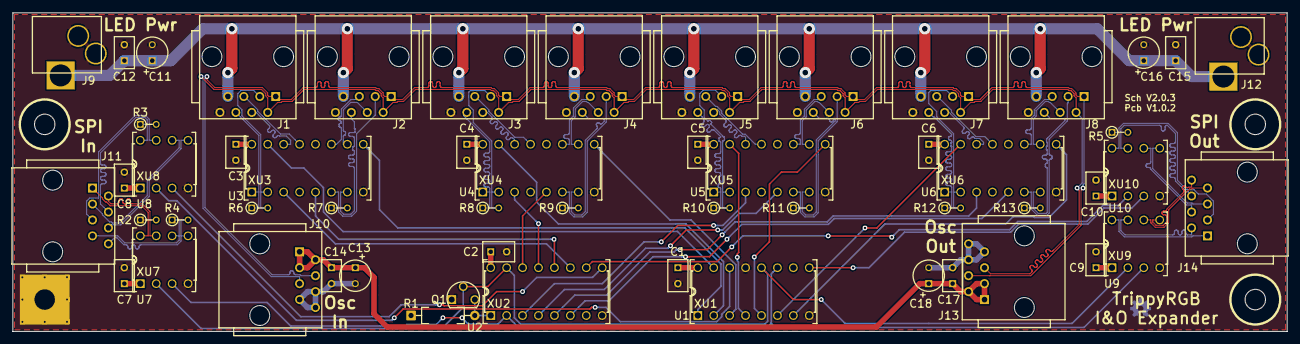
[picture p73: board I&O_Epander.kicad_pcb from above]

Board: 2 copper layers, 203.2 x 50.8 mm, 70 parts (0 on the bottom side), 76 nets.

Parts:
C1, C2, C3, C4, C5, C6, C7, C8, C9, C10, C12, C14, C15, C17: 0.1µF; CAPRR254W51L508T318H660P
C11, C13, C16, C18: 10µF; CAPPRD254W50D500H850
J1, J2, J3, J4, J5, J6, J7, J8, J10, J11, J13, J14: RJ45-Unshielded; WURTH_615008144221
J9, J12: KLDVHCX-0202-A; KYCON_KLDVHCX-0202-x_CirHole
MH1: #4 PTH; MTGP794H326V8P
MH2, MH3, MH4: #4 NPTH; MTGNP794H326Z794P
Q1: VN3205; TO92184P520H734-3
R1: 1kΩ; RESAD1016W56L681D259
R2, R3, R4, R5, R6, R7, R8, R9, R10, R11, R12, R13: 100Ω; RESADV254W45L350D185
U1: 74HC595; DIPS762W45P254L2019H508Q16
U2: 74HC165; DIPS762W45P254L2019H508Q16
U3, U4, U5, U6: 75C1168; DIPS762W45P254L2019H508Q16
U7: uA9637AC; DIPS762W45P254L1003H508Q8
U8, U10: DS8921; DIPS762W45P254L1003H508Q8
U9: uA9638C; DIPS762W45P254L1003H508Q8
XU1, XU2, XU3, XU4, XU5, XU6: IC_Socket16; DIPfS794W45P254L1969H508Q16
XU7, XU8, XU9, XU10: IC_Socket08; DIPfS762W45P254L1016H508Q8

Connections:
+5V(1): C1.1, C2.1, C3.1, C4.1, C5.1, C6.1, C7.1, C8.1, C9.1, C10.1, C13.1, C14.1, C17.1, C18.1, J10.1, J10.2, J10.3, J13.1, J13.2, J13.3, R1.1, U1.10, U1.16, U2.16, U3.4, U3.12, U3.16, U4.4, U4.12, U4.16, U5.4, U5.12, U5.16, U6.4, U6.12, U6.16, U7.1, U8.1, U9.1, U10.1
+5V(2): C11.1, C12.1, C15.1, C16.1, J1.7, J2.7, J3.7, J4.7, J5.7, J6.7, J7.7, J8.7, J9.1, J12.1
/In1: U2.11, U3.3
/In1+: J1.3, R6.2, U3.2
/In1-: J1.6, R6.1, U3.1
/In2: U2.12, U3.5
/In2+: J2.3, R7.1, U3.6
/In2-: J2.6, R7.2, U3.7
/In3: U2.13, U4.3
/In3+: J3.3, R8.2, U4.2
/In3-: J3.6, R8.1, U4.1
/In4: U2.14, U4.5
/In4+: J4.3, R9.1, U4.6
/In4-: J4.6, R9.2, U4.7
/In5: U2.3, U5.3
/In5+: J5.3, R10.2, U5.2
/In5-: J5.6, R10.1, U5.1
/In6: U2.4, U5.5
/In6+: J6.3, R11.1, U5.6
/In6-: J6.6, R11.2, U5.7
/In7: U2.5, U6.3
/In7+: J7.3, R12.2, U6.2
/In7-: J7.6, R12.1, U6.1
/In8: U2.6, U6.5
/In8+: J8.3, R13.1, U6.6
/In8-: J8.6, R13.2, U6.7
/MISO: U2.9, U8.3
/MISO': U2.10, U10.2
/MISO'+: J14.3, R5.1, U10.8
/MISO'-: J14.6, R5.2, U10.7
/MISO+: J11.3, U8.6
/MISO-: J11.6, U8.5
/MOSI: U1.14, U8.2
/MOSI': U1.9, U10.3
/MOSI'+: J14.4, U10.6
/MOSI'-: J14.5, U10.5
/MOSI+: J11.4, R3.1, U8.8
/MOSI-: J11.5, R3.2, U8.7
/Out1: U1.15, U3.15
/Out1+: J1.4, U3.14
/Out1-: J1.5, U3.13
/Out2: U1.1, U3.9
/Out2+: J2.4, U3.10
/Out2-: J2.5, U3.11
/Out3: U1.2, U4.15
/Out3+: J3.4, U4.14
/Out3-: J3.5, U4.13
/Out4: U1.3, U4.9
/Out4+: J4.4, U4.10
/Out4-: J4.5, U4.11
/Out5: U1.4, U5.15
/Out5+: J5.4, U5.14
/Out5-: J5.5, U5.13
/Out6: U1.5, U5.9
/Out6+: J6.4, U5.10
/Out6-: J6.5, U5.11
/Out7: U1.6, U6.15
/Out7+: J7.4, U6.14
/Out7-: J7.5, U6.13
/Out8: U1.7, U6.9
/Out8+: J8.4, U6.10
/Out8-: J8.5, U6.11
/SCK: U1.11, U2.2, U7.3, U9.3
/SCK'+: J14.7, U9.6
/SCK'-: J14.8, U9.5
/SCK+: J11.7, R4.1, U7.6
/SCK-: J11.8, R4.2, U7.5
/SS: Q1.3, R1.2, U2.1
/~IR_Osc+: J1.1, J2.1, J3.1, J4.1, J5.1, J6.1, J7.1, J8.1, J10.4, J13.4
/~IR_Osc-: J1.2, J2.2, J3.2, J4.2, J5.2, J6.2, J7.2, J8.2, J10.5, J13.5
/~SS: Q1.2, U1.12, U2.15, U7.2, U9.2
/~SS'+: J14.1, U9.8
/~SS'-: J14.2, U9.7
/~SS+: J11.1, R2.1, U7.8
/~SS-: J11.2, R2.2, U7.7
GND: C1.2, C2.2, C3.2, C4.2, C5.2, C6.2, C7.2, C8.2, C9.2, C10.2, C11.2, C12.2, C13.2, C14.2, C15.2, C16.2, C17.2, C18.2, J1.8, J2.8, J3.8, J4.8, J5.8, J6.8, J7.8, J8.8, J9.2, J9.3, J10.6, J10.7, J10.8, J12.2, J12.3, J13.6, J13.7, J13.8, MH1.0, Q1.1, U1.8, U1.13, U2.8, U3.8, U4.8, U5.8, U6.8, U7.4, U8.4, U9.4, U10.4
