Sembazuru/Interactive-Rainbow/Schematic/LED&Sensor/LED&Sensor.kicad_pcb

## KiCad design Schematic/LED&Sensor/LED&Sensor.kicad_pcb (2018-09-17)

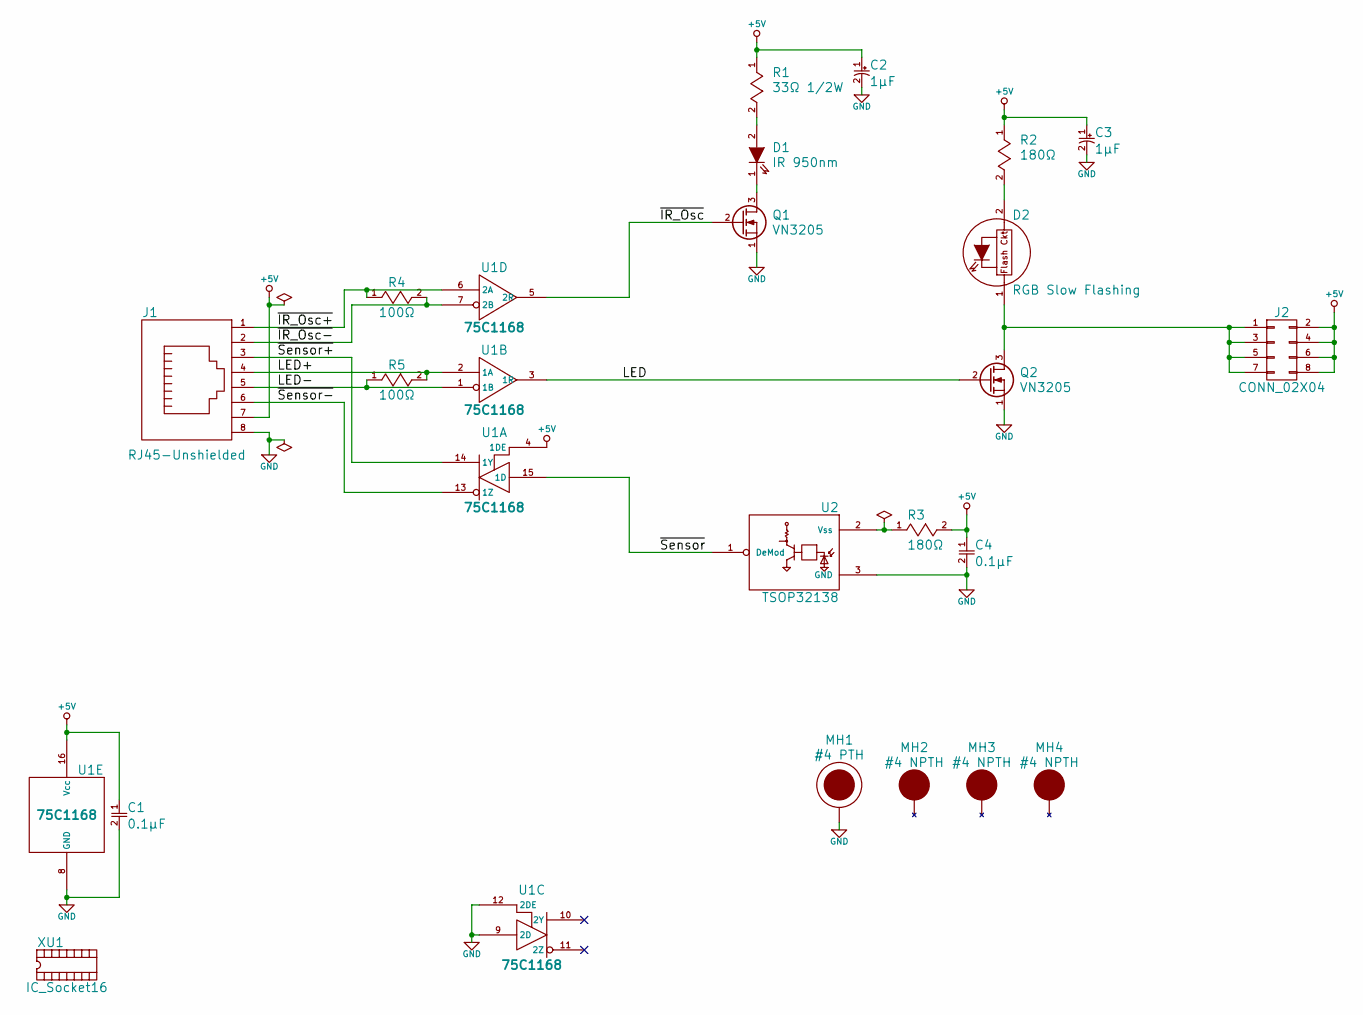
[picture p74: schematic LED&Sensor.sch, Interactive Rainbow]

Parts:
C1, C4: 0.1µF; CAPRR254W51L508T318H660P
C2, C3: 1µF; CAPPRD254W50D500H850
D1: IR 950nm; LEDRD254W50D500H960P
D2: RGB Slow Flashing; LEDRD254W50D500H960P
J1: RJ45-Unshielded; WURTH_615008144221
J2: CONN_02X04; Pin_Header_Straight_2x04
MH1: #4 PTH; MTGP794H326V8P
MH2, MH3, MH4: #4 NPTH; MTGNP794H326Z794P
Q1, Q2: VN3205; TO92184P520H734-3
R1: 33Ω 1/2W; RESAD1270W60L900D323
R2, R3: 180Ω; RESAD1016W56L681D259
R4, R5: 100Ω; RESADV254W45L350D185
U1: 75C1168; DIPS762W45P254L2019H508Q16
U2: TSOP32138; TO_VISHAY_TSOP3nnnnn
XU1: IC_Socket16; DIPfS794W45P254L1969H508Q16

Connections:
+5V: C1.1, C2.1, C3.1, C4.1, J1.7, J2.2, J2.4, J2.6, J2.8, R1.1, R2.1, R3.2, U1.4 (1DE), U1.16 (Vcc)
/LED: Q2.2 (G), U1.3 (1R)
/LED+: J1.4, R5.2, U1.2 (1A)
/LED-: J1.5, R5.1, U1.1 (1B)
/~IR_Osc: Q1.2 (G), U1.5 (2R)
/~IR_Osc+: J1.1, R4.1, U1.6 (2A)
/~IR_Osc-: J1.2, R4.2, U1.7 (2B)
/~Sensor: U1.15 (1D), U2.1 (DeMod)
/~Sensor+: J1.3, U1.14 (1Y)
/~Sensor-: J1.6, U1.13 (1Z)
GND: C1.2, C2.2, C3.2, C4.2, J1.8, MH1.0, Q1.1 (S), Q2.1 (S), U1.8 (GND), U1.9 (2D), U1.12 (2DE), U2.3 (GND)
unnamed: D1.1 (K), Q1.3 (D)
unnamed: D1.2 (A), R1.2
unnamed: D2.1 (K), J2.1, J2.3, J2.5, J2.7, Q2.3 (D)
unnamed: D2.2 (A), R2.2
unnamed: R3.1, U2.2 (Vss)

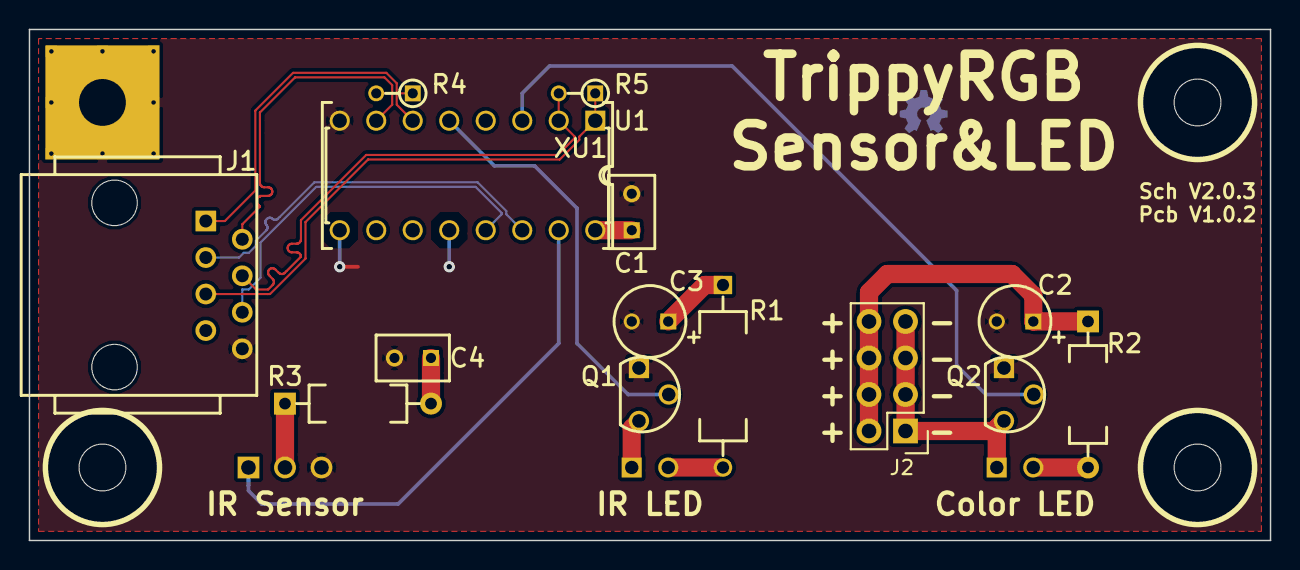
[picture p75: board LED&Sensor.kicad_pcb from above]

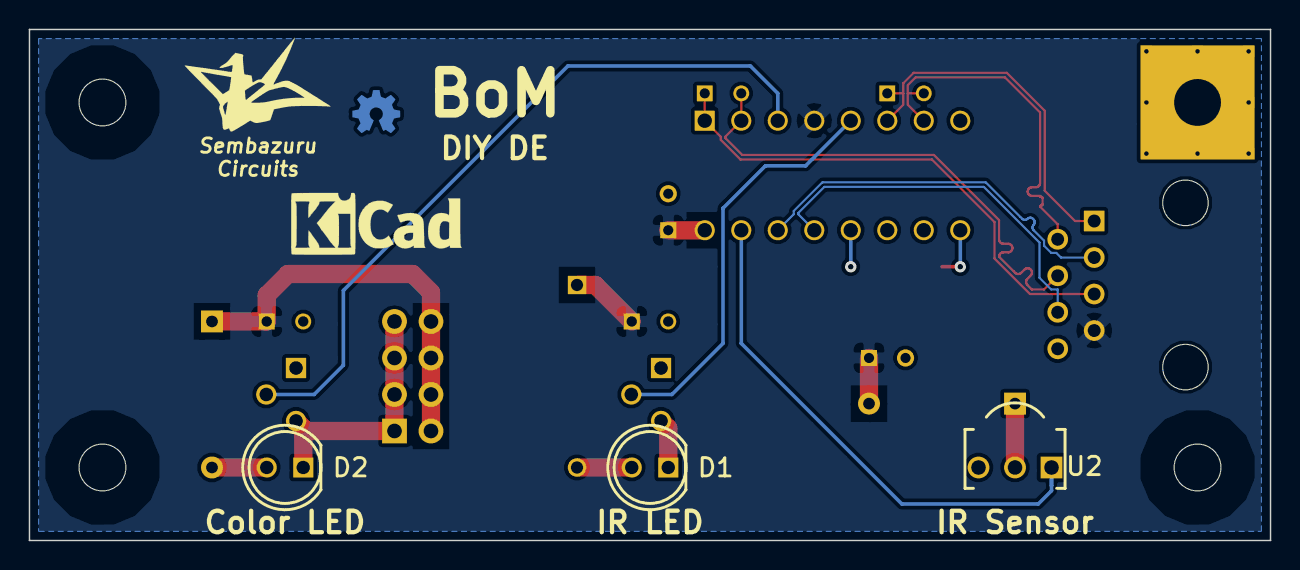
[picture p76: board LED&Sensor.kicad_pcb from below]

Board: 2 copper layers, 86.4 x 35.6 mm, 22 parts (3 on the bottom side), 16 nets.
