Sembazuru/Interactive-Rainbow/Schematic/Logic&Oscillator/Logic&Oscillator.kicad_pcb

## KiCad design Schematic/Logic&Oscillator/Logic&Oscillator.kicad_pcb (2018-09-17)

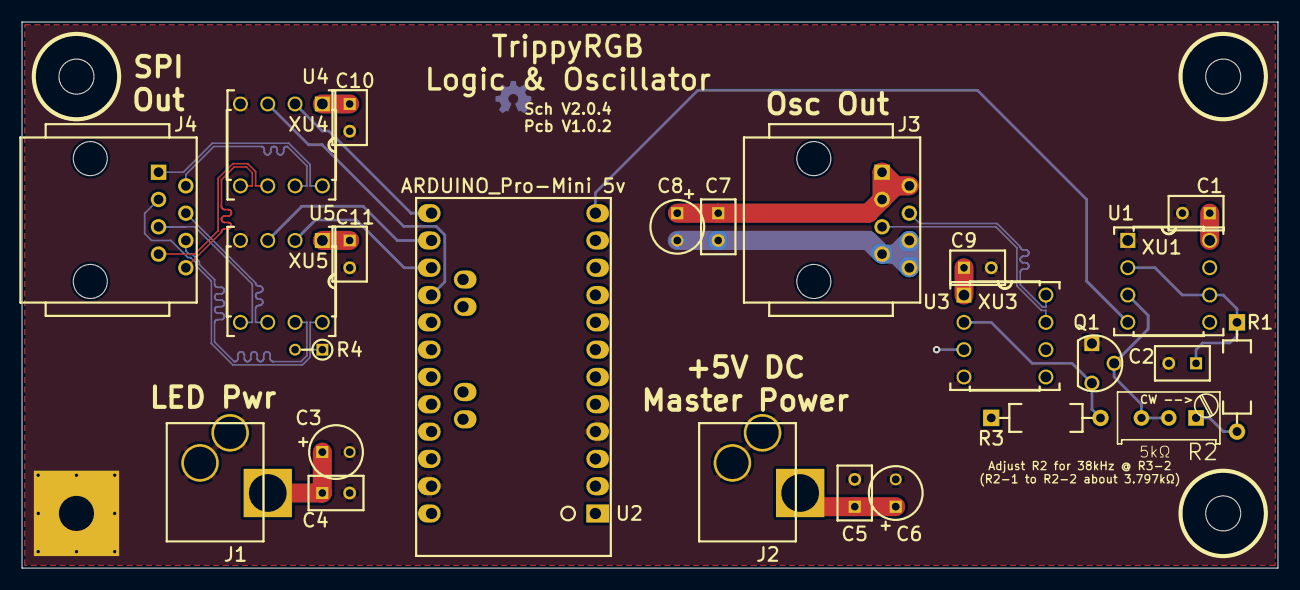
[picture p77: board Logic&Oscillator.kicad_pcb from above]

Board: 2 copper layers, 116.8 x 50.8 mm, 33 parts (0 on the bottom side), 21 nets.

Parts:
C1, C4, C5, C7, C9, C10, C11: 0.1µF; CAPRR254W51L508T318H660P
C2: 0.001µF; CAPRR254W51L508T318H660P
C3, C6, C8: 10µF; CAPPRD254W50D500H850
J1, J2: KLDVHCX-0202-A; KYCON_KLDVHCX-0202-x_CirHole
J3, J4: RJ45-Unshielded; WURTH_615008144221
MH1: #4 PTH; MTGP794H326V8P
MH2, MH3, MH4: #4 NPTH; MTGNP794H326Z794P
Q1: VN3205; TO92184P520H734-3
R1, R3: 15kΩ; RESAD1016W56L681D259
R2: 5kΩ; TRIM_Bourns3296WA
R4: 100Ω; RESADV254W45L350D185
U1: ICM7555; DIPS762W45P254L1003H508Q8
U2: ARDUINO_Pro-Mini 5v; ARDUINO_Pro-MiniU
U3, U4: uA9638C; DIPS762W45P254L1003H508Q8
U5: DS8921; DIPS762W45P254L1003H508Q8
XU1, XU3, XU4, XU5: IC_Socket08; DIPfS762W45P254L1016H508Q8

Connections:
+5V: C1.1, C3.1, C4.1, C5.1, C6.1, C7.1, C8.1, C9.1, C10.1, C11.1, J1.1, J2.1, J3.1, J3.2, J3.3, R3.1, U1.8, U2.21, U3.1, U4.1, U5.1
/IR_Enable: U1.4, U2.12
/IR_Osc: Q1.2, R2.2, R2.3, U1.3
/MISO: U2.15, U5.2
/MISO+: J4.3, R4.1, U5.8
/MISO-: J4.6, R4.2, U5.7
/MOSI: U2.14, U5.3
/MOSI+: J4.4, U5.6
/MOSI-: J4.5, U5.5
/SCK: U2.16, U4.3
/SCK+: J4.7, U4.6
/SCK-: J4.8, U4.5
/~IR_Osc: Q1.3, R3.2, U3.2
/~IR_Osc+: J3.4, U3.8
/~IR_Osc-: J3.5, U3.7
/~SS: U2.13, U4.2
/~SS+: J4.1, U4.8
/~SS-: J4.2, U4.7
GND: C1.2, C2.2, C3.2, C4.2, C5.2, C6.2, C7.2, C8.2, C9.2, C10.2, C11.2, J1.2, J1.3, J2.2, J2.3, J3.6, J3.7, J3.8, MH1.0, Q1.1, U1.1, U2.4, U2.23, U3.3, U3.4, U4.4, U5.4
unnamed: C2.1, R1.1, U1.2, U1.6
unnamed: R1.2, R2.1
