Sembazuru/Interactive-Rainbow/(commit log)

2015-09-07 V1.1.0 Realized that while the TLS5940 PWM Driver chip is using the SPI MOSI and SCK signals, the full signaling isn't SPI compatable. Specifically, the latch signal is high active where SPI CS is lo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
    [ControlCircuit.sch, LED_Group.sch, Schematic.csv, Schematic.ods, Schematic.sch]
2015-09-24 1.1.1 Change TIP120 to TIP31C (on-hand stock), change Cap Ref'ds on LED Groups Fritzing file to plan perfboard layout for LED groups.
    [ControlCircuit.sch, LED_Group.sch, LED_Group_Perfboard.fzz, Schematic.csv, Schematic.sch]
2015-11-25 CyclingLEDTimingTest.ino: Changed LED reset trigger from state triggered to edge triggered.
    [CyclingLEDTimingTest.ino]
2015-12-06 Updated schematic for simplified auto-cycling leds. Lower part count and cost, not as flexible on color cycling.
    [ControlCircuit.sch, LED_Group.sch, Schematic.csv, Schematic.ods, Schematic.sch]
2015-12-07 Change TIP31C to 2N2222. (Don't need the current capacity, so why pay for it?) Clean-up BOM items.
    [ControlCircuit.sch, LED_Group.sch, Octopart_bom.csv, Schematic.csv, Schematic.ods, Schematic.sch]
2015-12-07 Updated Fritzing sketch for simplified LED groups.
    [LED_Group_Perfboard.fzz]
2015-12-17 v1.2.2 Change 555 to CMOS 7555 to simplify IR strobe design & lower current. And, control IR LEDs to only light when SPI transfer.
    [ControlCircuit.sch, LED_Group.sch, Octopart_bom.csv, Schematic.ods, Schematic.sch, Schematic_bom_with_title_block_2_csv.csv]
2016-01-09 v1.2.3 Correct 7555 enable logic level to high active. (Also remembered to put latest schematic pdf in repository)
    [ControlCircuit.sch, LED_Group.sch, Schematic.sch, Schematic_bom_with_title_block_2_csv.csv]
2016-01-30 Added annotation and single module view to layout drawing.
    [Layout suggestion 2105-08-07.dwg]
2016-02-09 Schematic v1.2.4 - Change all 2N2222 BJT to VN3205 N-MOSFET (and remove base/gate resistors.) CyclingRainbow.ino v0.1.1 - Incorporate code from CyclingLEDTimingTest.ino and remove single-switch logic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
    [ControlCircuit.sch, LED_Group.sch, Schematic.sch, Schematic_bom_with_title_block_2_csv.csv]
2016-02-10 CyclingRainbow.ino v0.1.2 - Renamed index variables intelligently, fixed the MISO triggering code. Still need to sort out byte order of in and out.
    [CyclingRainbow.ino]
2016-02-10 CyclingRainbow.ino v0.1.3 - Fixed byte order for inputs and outputs.
    [CyclingRainbow.ino]
2016-02-13 v1.2.5 - Corrected pinout of TSOP32138 (Had Vss and GND backwards.)
    [ControlCircuit.sch, LED_Group.sch, Schematic.sch, Schematic_bom_with_title_block_2_csv.csv]
2016-02-18 v0.1.5 - Remove logic to disable 555 between cycles. Just too problematic.
    [CyclingRainbow.ino]
2016-02-20 Revert "v1.2.5 - Corrected pinout of TSOP32138 (Had Vss and GND backwards.)"
    This reverts commit 92fd972df3028d2ac81965aa4d2affe324d0815a.
    [ControlCircuit.sch, LED_Group.sch, Schematic.sch, Schematic_bom_with_title_block_2_csv.csv]
2016-05-15 2016-05-15 Snapshot prior to splitting schematic up for 4 PWB design.
    [LED_Group.sch]
2017-04-16 collected changes
    Many collected changes on track for PCB based project.
    [Calculated.csv, Circuit Board Design Relative Sizes.dwg, CleanedUp.CSV, CleanedUp.ods, ExtraLEDs - v1.0.0.kicad_pcb, ExtraLEDs - v1.0.1.kicad_pcb, ExtraLEDs.kicad_pcb, ExtraLEDs.sch]
2018-09-17 KiCAD upgrade
    Upgrade schematic and pcb files for KiCad v5.
    Make 8-pin dip holes larger for crimped-pin sockets
    InteractiveBOM plugin v1.1 board stuffing files generated.
    [ExtraLEDs.kicad_pcb, I&O_Epander - v1.0.2.kicad_pcb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]
2018-10-07 Add SensorActive constant
    Added SensorActive constant to allow easy custimization of code for high-active or low-active sensors.
2018-10-07 Update .gitignore
    Add KiCad specific items to .gitignore.
